chipsalliance/Cores-VeeR-EH1/(threads)

Thread 2 (2019-07-10):

Code cleanup: fix line endings

ChippendaleMupp, 2019-07-10:
Perforce is complaining about line endings in the 4 files below.  dos2unix seems to clean them up. (Command for recursive cleanup:  'find . -type f -print0 | xargs -0 dos2unix'

- design/dmi/dmi_wrapper.v
- design/dmi/dmi_jtag_to_core_sync.v
- testbench/hex/data.hex
- testbench/hex/program.hex

jrahmeh, 2019-07-12:
Fixed.

Closed 2019-07-12.

Thread 14 (2019-09-04):

Issues to enable DMA for SweRV

rajoogupta, 2019-09-04:
Hi,
I am trying to enable DMA for SweRV. I did following changes in **testbench/tb_top.sv**

   1.added following signal
    logic [31:0] dma_haddr;
    logic [2:0] dma_hburst;
    logic [3:0] dma_hprot;
    logic [2:0] dma_hsize;
    logic [1:0] dma_htrans;
    logic dma_hmastlock;
    logic dma_hwrite;
    wire dma_hresp_out;

   2. port mapping
    // DMA Slave
    //---------------------------------------------------------------
    .dma_haddr **('0) replaced with** ( dma_haddr ),
    .dma_hburst **('0) replaced with** ( dma_hburst ),
    .dma_hmastlock **('0) replaced with** ( dma_hmastlock),
    .dma_hprot **('0) replaced with** ( dma_hprot ),
    .dma_hsize **('0) replaced with** ( dma_hsize),
    .dma_htrans **('0) replaced with** ( dma_htrans),
    .dma_hwrite **('0) replaced with** ( dma_hwrite ),
    .dma_hwdata **('0) replaced with** ( dma_hwdata ),

        .dma_hrdata          ( dma_hrdata    ),
        .dma_hresp          **(dma_out)   **replaced with****   ( dma_hresp_out   ),
        .dma_hsel            ( 1'b1            ),
        .dma_hreadyin        ( dma_hready_out  ),
        .dma_hreadyout       ( dma_hready_out  ),

  3.  added instance
    ahb_sif **o_ahb_dma** (

    .HWDATA(dma_hwdata),
    .HCLK(core_clk),
    .HSEL(1'b1),
    .HPROT(dma_hprot),
    .HWRITE(dma_hwrite),
    .HTRANS(dma_htrans),
    .HSIZE(dma_hsize),
    .HREADY(dma_hready),
    .HRESETn(reset_l),
    .HADDR(dma_haddr),
    .HBURST(dma_hburst),

    .HREADYOUT(dma_hready),
    .HRESP(dma_hresp),
    .HRDATA(dma_hrdata)

    );

I have **DMA controller (master) to drive read or write requests into ICCM/DCCM**

after all , ran verilator and got hello world but **DMA is not enable** as ICCM and DCCM donot getting any data.

Here is GTKwave for reference

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

Please help me, to enable DMA for SweRV

Thanks & Regards
Rajoo

aprnath, 2019-09-06:
Hi Rajoo,

 Looking a your waveform, I notice a couple of things:

- Your dma_bus_clk_en is 0. This should be 1 to enable the DMA bus interface clocking. See the PRM for details on how the clock enables control clock ratios. A 0 effectively disables the clock.

- I do not see any DMA read/swrite initiated in the portion of the waveform shown. Your testbench bfm/DMA master must initiate read/write sequences on the bus. The core is a slave and will respond.

-Ajay

rajoogupta, 2019-09-06:
Hi Ajay,
             I set **dma_bus_clk_en** to 1 as you suggested (also referred  PRM) but DMA is not enable.
Here snapshot of DMA master signal.

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

Thanks & Regards
Rajoo

aprnath, 2019-09-06:
Please show me a snapshot of waveform where your testbench  AHB master is initiating a read or write on the dma* AHB bus (assuming you are using the AHB flavor of the interface and not AXI).

The DMA port is a slave port and an external agent has to initiate the activity.

rajoogupta, 2019-09-06:
Hi Ajay,
             Please find snapshot of AHB master initiating a read or write on the dma AHB bus.
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

Previously there is no code in testbench to initiating a read or write on the dma AHB bus.
so added following code in testbench as I mentioned in my issue post.

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

Thanks & Regards
Rajoo

rajoogupta, 2019-09-07:
Hi,
      I am trying to enable DMA for SweRV. Inside design , there is a DMA controller which work as master for DMA.
if anybody enable DMA , Please help me to enable it.

Thanks & Regards
Rajoo

aprnath, 2019-09-07:
Hi Rajoo,

The SweRV core has a DMA slave port, not a DMA master port. You need an external master to pull/push data from/to the core.

Ajay

milk0920, 2019-09-12:
Hi , if we want to use the iccm ，Can I simply edit the link file， And let the cpu core to automatically download the code from external rom/ram/flash, is that possible, if we do not have the dma master design, but we still want to run code in iccm

Closed 2020-02-11.

Thread 15 (2019-09-12):

Boot code from iccm

milk0920, 2019-09-12:
Hi , if we want to use the iccm ，Can I simply edit the link file， And let the cpu core to automatically download the code from external rom/ram/flash, is that possible, if we do not have the dma master design, but we still want to run code in iccm

agrobman, 2020-02-12:
provided TB doesn't support any usage of ICCM

agrobman, 2020-02-20:
checkout latest and *_iccm test ...

aprnath, 2020-04-13:
Closing this. Please see prior comment about using the *iccm tests. It enables one of

- a gasket that allows stores to ICCM by hooking up the LSU to the DMA port
- or a testbench preload of the ICCM

Thanks

Closed 2020-04-13.

Thread 23 (2019-11-07):

ifu interface access illegal address

Chuanjieliu, 2019-11-07:
Ifu interface will access illegal address while cpu is running，But does not affect the function.
For example，the 0x0-0x30 is illegal address
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
after analysis，we found that the BP predicted an incorrect address. Can I solve this problem by set the register?

Chuanjieliu, 2019-11-07:
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
spec

Closed 2019-11-07.

Thread 24 (2019-11-08):

Interrupt example

Jagannaths3, 2019-11-08:
Hi,
   I am trying to use the interrupt on the SweRV core. I am trying the following
1) Setup interrupt[1] with following features -
    standard priority order - 0x0 @ mpiccfg
   gateway configuration set to Edge-triggered, active high - 0x2 @ meigwctrl1
   set priority level for interrupt1 to 15 - 0x000F @ meipl1
   mask no interrupt - 0x0 @ meipt
   0x0 @ meicidpl
   0x0 @ meicurpl
   Enable the interrupt - 0x1 @ meie1
   machine interrupt enable - 0x800 @ mie (0x304)

2)  put the system to sleep by writing 0x1 to 0x7C6(mpmc)

3) Toggle the interrupt1 bit using testbench.

I see the signal mhwakeup( in dec.tlu) get asserted, but the mhwakeup_ready does not go high since the interrupt is not enabled in the mstatus register.

What is the correct sequence of setting up interrupts and handlers? Can you please provide an example of basic interrupt handler setup and usage? The Example interrupt flows (5.14.1) seems inadequate.

Thanks,
Jagannath

olofk, 2019-11-08:
Hi,

Perhaps you might be helped by the Zephyr interrupt driver for SweRV [here](https://github.com/olofk/zephyr/blob/swerv_pic/drivers/interrupt_controller/swerv_pic.c), currently [under review for inclusion](https://github.com/zephyrproject-rtos/zephyr/pull/19865) in Zephyr

Closed 2020-04-13.

Thread 26 (2019-11-20):

Issue in running the Design in vivado

rajat-agnisys, 2019-11-20:
Hello,

I am just trying to run swerv design on xilinx zed board using vivado and instead of running it in the debug mode using jtag and uart i want to interface this with zedboard io's.
Could you help me in this as i am unable to write firmware sequences for the swerv core in fpga or how to initialize the memory with those hardcode sequence.

Thanks

aprnath, 2020-04-13:
Hi Rajat, we could not understand exactly what is being asked/requested here. If this is still an issue blocking you please open a new issue and we can try to understand your use case.

Closed 2020-04-13.

Thread 28 (2019-12-02):

Software breakpoints with OpenOCD + GDB

cstewart-ust, 2019-12-02:
When connecting OpenOCD I get the following warning:

Info : datacount=2 progbufsize=0
Warn : We won't be able to execute fence instructions on this target. Memory may not always appear consistent. (progbufsize=0, impebreak=0)

With icache enabled is there any way of reliably setting a SW breakpoint? Build options via swerv.config? I imagine this would require a fence instruction to be issued to flush cache but there's no program buffer to do so...

The custom CSR (0x7C4) seems that it would work via 'expose_csr' on OCD but initial results show inconsistent behavior

aprnath, 2020-02-11:
Yes, you need to use the custom DMST (0x7c4) CSR to force a fence.i before returning from debug mode, if you have used the system bus to update cacheable memory.

Could you be more specific about the "inconsistent behavior" ? Whats your setup and flow? Please provide your use case and steps so we can try and understand if it is a usage issue or a design issue.

agrobman, 2020-04-04:
OpenOCD out of box doesn't support DMST register, you'll need write it manually with debugger command every time you setting SW Breakpoint, or patch openOCD, including the register write into SW Breakpoint setting/removing functions.

JanMatCodasip, 2020-09-22:
A note in case anyone else runs into the same issue -

With the present day SweRV 1.8+ and [riscv-openocd](https://github.com/riscv/riscv-openocd/), the **preferred solution** is to enable abstract memory access. That will properly populate the SW breakpoint even when ICache is present. Add the following line to your OpenOCD configuration file:

```
riscv set_mem_access abstract
```

For robustness, you may also have OpenOCD clear the ICache every time the processor is resumed from the debug mode. To do so, add this to your OpenOCD configuration:

```
# Expose custom SweRV CSR dmst (CSR 0x7c4 == 1988)
riscv expose_csrs 1988

proc swerv_eh1_execute_fence {} {
    # Execute fence + fence.i via "dmst" register
    reg csr1988 0x3
}

# Configure events hooks in OpenOCD to execute Fence + Fence.i when resuming
# the processor from the debug mode:

$_TARGETNAME configure -event resume-start {
    swerv_eh1_execute_fence
}

$_TARGETNAME configure -event step-start {
    swerv_eh1_execute_fence
}

```

Closed 2020-04-13.

Thread 31 (2019-12-28):

RV core With AHB bus will cause bug when send read operation

walkingjian, 2019-12-28:
In the latest test, RV core in my soc envirent will cause NMI err.

The detail is because the RV core send a 64bit width read transation of AHB bus, while I only wirte an "unsigned int read regitster" code in my c file.
And ,the register I want read is right the last register of one module, so this 64 bit read cause slverr back, and then the RV core get into MNI interrupt.

aprnath, 2020-02-10:
Hi,
Please use MRAC to set the region for your device to be non-idempotent. Non-idempotent (or side-effect) regions will support exact size for load stores, and is recommended for non-memory load stores, especially to devices.

Closed 2020-02-11.

Thread 32 (2019-12-30):

EH2 and EL2 are missing.

pieter3d, 2019-12-30:
Earlier this month Western Digital announced two new cores, EH2 and EL2, in addition to the current one here, EH1: https://www.westerndigital.com/risc-v

But I don't see them in this repository, linked on that page. Where could I find these two new cores?

aprnath, 2020-04-13:
EH2/EL2 are visible to ChipsAlliance members for now and will be globally visibly at some later date.

Closed 2020-04-13.

Thread 33 (2020-02-10):

RISCV-Compliance check - Some Fails

cr8601, 2020-02-10:
Hi,
I successfully run the RISC-V Compliance check (https://github.com/riscv/riscv-compliance) on the provided SweRV RTL and I was able to pass most of the tests except the following:

1. ree_rv32i.I-MISALIGN_JMP-01
2. ree_rv32i.I-MISALIGN_LDST-01
3. ree_rv32mi.breakpoint
4. ree_rv32Zifencei.I-FENCE.I-01
5. ree_rv32ui.fence_i

Unfortunately I couldn't find any information about RISC-V-Compliance check regarding SweRV.

- Regarding 1./2.
I read that this is not needed by RISC-V spec. And also it is implementation dependent. Whenever the RTL already contains mechanism to handle misalignments, this test probably fails...
What about SweRV implementation?

- Regarding 3
I didn't yet analyze in detail, but I don't expect this to be really relevant

- Regarding 4./5.
As stated in the PRM (1.1 Features):
> RV32IMCZifencei_Zicsr-compliant RISC-V core with branch predictor
I would expect this test to pass...

Has anyone ever run RISC-V compliance on SweRV and can comment on the above issues?

Thanks and best regards
cr

aprnath, 2020-02-10:
Misalign tests will fail because SweRV supports unaligned accesses to normal memory. IO (non-idempotent) ld/st will take misalignment exceptions, but you will need to mark the region as such using the MRAC CSR. SweRV also supports compressed (16 bit) instructions, and there is no way to turn off 16 bit support - so you cannot get alignment exceptions on branch/jump instructions either.

Regarding the fence instructions - it depends on your test setup and if it supports a unified instruction.data memory. The (currently*) provide simple TB does not support self-modifying code since the stores are not reflected in the instruction memory. To really test the fence.i instruction, you need your system to have share memory between the fetch and data buses.

* We will be updating the provided TB soon.

aprnath, 2020-02-10:
Regarding the breakpoint test, note that SweRV disables breakpoints when mstaus.mie is cleared.

cr8601, 2020-02-10:
Hi aprnath,
thank you very much for this information. This helps a lot in further debugging and understanding!

cr8601, 2020-02-13:
Hi aprnath,

- I was able to successfully run the "fence" instruction test by using shared memory for IFU&LSU. Thank for your hint.

- I did some analysis for the breakpoint test. By adding the following code to the beginning of the test I could successfully run it:
```
# from https://github.com/riscv/riscv-asm-manual/blob/master/riscv-asm.md
# set mstatus.MIE=1 (enable M mode interrupt)
li      t0, 8
csrrs   zero, mstatus, t0
```

After digging some more in the latest ISA spec, 3.1.6 Machine Status Registers, I am wondering whether mstatus.MIE should be '1' by default and this is an inconsistency to the spec? Can you comment on that?

Best regards
cr

cr8601, 2020-02-13:
Hi aprnath,
I think it's cleared in chapter 3.3:

> Upon reset, a hart’s privilege mode is set to M. The mstatus fields MIE and MPRV are reset to
> 0.

Correct? Then I am wondering about the compliance check and why it works for others...
I probably need to open an issue at their repo. Do you agree, or do you you have any other idea?

Best regards
cr

tmw-wdc, 2020-02-13:
Hi,

I think the answer to your question above is covered in Section 5.1, ‘Native M-Mode Triggers’ of the [RISC-V External Debug Support specification, Version 0.13.2](https://riscv.org/specifications/debug-specification/).  There are two implementation options to deal with breakpoints in M-mode only cores.  SweRV disables breakpoints when MSTATUS.MIE is cleared.  Presumably, the breakpoint test might pass on cores which implement the other option.

Thanks,
Thomas

cr8601, 2020-02-14:
Hi,
thanks for your support and quick feedback. I'll request to add the register settings within the compliance test.
Thanks
cr

tmw-wdc, 2020-02-14:
Thank you for reporting these test cases!  They will be documented in the next PRM release.

Thanks,
Thomas

Closed 2020-02-14.

Thread 35 (2020-02-18):

running with stack in RAM

monniaux, 2020-02-18:
I have tried running on the "verilated" simulated core a simple program making a function call but hit a snag.

The program is

```
#include "defines.h"

#define STDOUT 0xd0580000

.section .text
.global _start
_start:
    la   sp, _sp

    // Clear minstret
    csrw minstret, zero
    csrw minstreth, zero

    // Set up MTVEC - not expecting to use it though
    li x1, RV_ICCM_SADR
    csrw mtvec, x1

    // Enable Caches in MRAC
    li x1, 0x55555555
    csrw 0x7c0, x1

    call main

// Write 0xff to STDOUT for TB to termiate test.
_finish:
    li x3, STDOUT
    addi x5, x0, 0xff
    sb x5, 0(x3)
    beq x0, x0, _finish
.rept 100
    nop
.endr

	.align	1
	.globl	main
	.type	main, @function
main:
	addi	sp,sp,-256
	sw	ra,252(sp)
	sw	s0,248(sp)

.rept 7
	nop
.endr

	lw	ra,252(sp)
	lw	s0,248(sp)
	addi	sp,sp,256
	jr	ra
	.size	main, .-main
```

The link file is
```
OUTPUT_ARCH( "riscv" )
ENTRY(_start)

MEMORY
{
	RAM  (wxa!ri) : ORIGIN = 0x00000000, LENGTH = 64K
}

/*----------------------------------------------------------------------*/
/* Sections                                                             */
/*----------------------------------------------------------------------*/

SECTIONS
{
  __stack_size = DEFINED(__stack_size) ? __stack_size : 4K;

  .text.init	:
  {
	*(.text.init)
	. = ALIGN(8);
  } > RAM

  .text :
  {
    *(.text.unlikely .text.unlikely.*)
    *(.text.startup .text.startup.*)
    *(.text .text.*)
    *(.gnu.linkonce.t.*)
	. = ALIGN(8);
  } > RAM

  .rodata	:
  {
    *(.rdata)
    *(.rodata .rodata.*)
    *(.gnu.linkonce.r.*)
	. = ALIGN(8);
  } > RAM

  .data	:
  {
	*(.data .data.*)
    *(.gnu.linkonce.d.*)
	. = ALIGN(8);
  } > RAM
  .sdata	:
  {
	. = ALIGN(8);
    __global_pointer$ = . + 0x800;
    *(.sdata .sdata.*)
    *(.gnu.linkonce.s.*)
    . = ALIGN(8);
    *(.srodata .srodata.*)
	. = ALIGN(8);
  } > RAM

  .sbss : {
    *(.sbss .sbss.* .gnu.linkonce.sb.*)
    *(.scommon)
	. = ALIGN(8);
  } > RAM
  .bss :
  {
	*(.bss)
	. = ALIGN(8);
  } > RAM

  _end = .;

  .stack :
  {
	_heap_end = .;
	. = . + __stack_size;
	_sp = .;
  } > RAM
}
```

The trace seems to imply that value `0` is read from memory and restored to `ra` thus the function returns not to the normal return location but to program start. A neverending loop ensues and the program is killed because the number of simulated instructions exceeds a threshold.

If `rept 7` is replaced by `rept 6` things run perfectly : function `main` is called and then the program terminates.

My interpretation is that in one case the read to `ra` is not actually performed from RAM but from a write buffer, while in the other case a read from RAM is performed and the simulated RAM answers `0`.

I'm at a loss—how am I supposed to run programs that write to RAM?

aprnath, 2020-02-18:
Hi,
Are you using the provided simple testbench for this test? If so, then yes there is a known issue that this demo testbench does not support proper store/load persistence.

We are going to be releasing a more capable testbench slave shortly. Stay tuned.

monniaux, 2020-02-19:
Indeed. I just use my own assembly code instead of `hello_world2.s`. Since I could not make head or tail of what was happening, I also fiddled with the link file.

Do I understand it correctly that this demo does not support writing to RAM and reading back from it?

aprnath, 2020-02-19:
> Do I understand it correctly that this demo does not support writing to RAM and reading back from it?

Yes. Sorry. A better demo testbench will be pushed soon.

agrobman, 2020-02-19:
meanwhile you can try to update testbench/ahb_sif.sv

always @ (posedge HCLK or negedge HRESETn) begin
  if (Write **&& Last_HADDR == 32'h0**) begin

removing '&& Last_HADDR ==32'h0'

aprnath, 2020-02-20:
Please try out the latest release and reopen if needed.

Closed 2020-02-20.

Thread 36 (2020-02-19):

DCCM load/store conflict situation

TAD-dev, 2020-02-19:
DCCM data outputs are forced to 0 values at he [testbench](https://github.com/chipsalliance/Cores-SweRV/blob/1651bdf99a9c7dafab543e8697c48bf300e56cfa/testbench/tb_top.sv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).
Does this mean DCCM is not supposed to be used?

And if DCCM is in the working state, I've got a question.
Does LSU support resolving of conflicts when store and load operations are performed with the same target address? Or such situations should be resolved on the software side?

aprnath, 2020-02-19:
Hi,
The DCCM is fully functional. The simple demo TB we put out does not support it, obviously.
We will be releasing a new testbench shortly which will run with the DCCM. Please stay tuned.

Resolution of resource conflicts are handled by the hardware.

aprnath, 2020-02-20:
Please try out the latest release, and reopen if needed.

TAD-dev, 2020-02-20:
I've pulled newest version of the project but it doesn't help.

I'll describe the issue I've found.
When there are sequential storing and loading with the same target address are done, it's not guaranteed they'll be ordered in a correct way.

In case which I've explored there is a sequence of store operation and then store and load to the same address are done. As I've understood load and store units work in parallel and are not synchronous. Because of payload store unit is busy when new accesses come, so it postpones new memory write operations. And when load access happens it is executed immediately, as load unit is doing nothing at that time.
It causes situation in which store happens later then load to the same address even if in assembly code load should happens later.

This error is reproducible, so I've created small test-case to illustrate it. Here is assembler file [(dccm_test.s.txt)](https://github.com/chipsalliance/Cores-SweRV/files/4230485/dccm_test.s.txt) and its disassembled version [(dccm_test.dS.txt)](https://github.com/chipsalliance/Cores-SweRV/files/4230484/dccm_test.dS.txt).

Last two instructions uses the same addresses (sp+12 or 0x7_FFCC). As you can see on waveforms store to 0x7_FFCC happens a few cycles later then load from it, but in assembly program and disassembled code order is reversed.
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

So, it causes reading of X's from this address.

aprnath, 2020-02-20:
Reopening this issue.

The way the DCCM works, for alignment and ECC handling, is that it always does a read-modify-write, and even for writes the ECC has to be calculated before updating the memory. If the memories are not initialized at reset, this could result in X propagation in simulation.

agrobman, 2020-02-20:
I didn't understand how do you run your test. Please, provide run commands/test sources/linker file and exec.log from simulation.

FYI:

TB sets up reset to address 0, your code starts from 0x80000000,
Your stack is set to 0x28_0000, while DCCM base address is 0xf0040000.

You need to be aware that external memories are 64KB only and ignore upper 16 bits of the address. Also the $readmemh tasks, loading the RAMs will not load bytes, which address is higher than 0xffff .

Please, take a look on tests code and linker files of the provided  examples to get hints how to deal with DCCM,  ICCM code and data.  These are a bit tricky.
( all this complexity is because our verilator version doesn't support SV dynamic data types, the stuff could be much simpler if we could use associative arrays to model CPU memories)

The TB setup has changed since 1.4 .

 exec.log helps to understand what processor did during a test simulation. ( although it doesn't show registers updates for external loads)

TAD-dev, 2020-02-20:
I'm using custom testbench and configurations, so addresses differ from default ones.
In my test case initialization part of program (init section) located in the ROM (with offset 0x80000000) that's why 0x80000000 is start address. And main program (text section) located in the ICCM with offset 0x00100000.
In this test case DCCM has offset 0x00200000 and size 512 KB. Stack is located at the end of the memory, so default value of pointer is 0x28_0000.

For complication and linking of the program I used this commands:
```
${GCC_PREFIX}-as -march=rv32imc dccm_test.s -o dccm_test.o
${GCC_PREFIX}-as -march=rv32imc ctrl0.s -o ctrl0.o
${GCC_PREFIX}-ld -m elf32lriscv --discard-none -Tdccm_test.ld -o dccm_test.elf dccm_test.o ctrl0.o
```
Here are links for [initial](https://github.com/chipsalliance/Cores-SweRV/files/4233425/ctrl0.s.txt) and [main](https://github.com/chipsalliance/Cores-SweRV/files/4233428/dccm_test.s.txt) parts of the program.
Here is [linkers sctipt](https://github.com/chipsalliance/Cores-SweRV/files/4233427/dccm_test.ld.txt).
Here are resulting [disassembled code](https://github.com/chipsalliance/Cores-SweRV/files/4233426/dccm_test.dS.txt) and [exec.log](https://github.com/chipsalliance/Cores-SweRV/files/4233444/exec.log.txt).

In general both ICCM and DCCM work fine except of this "store-load" case.
As the example I've changed test program which I've shared earlier to make it work fine. I've just put 20 NOP operation between store and load and it resolved this coherency problem. [Here](https://github.com/chipsalliance/Cores-SweRV/files/4233330/dccm_test_no_conflict.s.txt) is the link to this program and [here](https://github.com/chipsalliance/Cores-SweRV/files/4233329/dccm_test_no_conflict.drtelf.txt) is its disassembled version.
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
As you can see on waveforms load happens later then store now, and data are read correctly.

So, it seems there is a problem in coherency mechanism of the processor.

agrobman, 2020-02-21:
OK, this is effect of the uninitialized memory with ECC protection and Store to Load bypassing in the Store buffer. You need first write the DCCM locations, you are going to use, then you can read them in any order. The problem happens if you write uninitialized location and read immediately from it.

Theoretically, memory with ECC protection should be first "initialized" by word aligned word size stores and only then it can be freely accessed. The crt0 can execute the whole application data region zeroing and only then C coded main can use it as data, stack or heap ...
Also, I need to remind that any uninitialized variable in C is assumed to have zero value.
There is another reason for memory initialization - misaligned of smaller than word variables access.
the CPU always make read/modify/write operations for byte and half word stores. These will fail in simulation if the memory was not initialized or cause random ECC error/exceptions in real life.

TAD-dev, 2020-02-21:
Initialization of stack area with zeros helped to avoid coherence problem.
Thanks!

But what will happen in real life situation in this case?
DCCM has unknown values after reset, so ECC will be inevitably incorrect at the very first read. And as there is always read before write, first stack writing will cause ECC errors.

BTW. Is it possible to remove ECC checking from ICCM and DCCM with some option as it is done at I-Cache?

aprnath, 2020-02-21:
The PRM has this verbiage in section 3.4:
 _**Note:** Memories with parity or ECC protection must be initialized with correct parity or ECC. Otherwise, a read access to an uninitialized memory may report an error. The method of initialization depends on the organization and capabilities of the memory. Initialization might be performed by a memory self-test or depend on firmware to overwrite the entire memory range (e.g., via DMA accesses)._

We will update it to be explicit about the initialization mechanisms, adding the following:

_**Note:** If the DCCM is uninitialized, a load following a store to the same address may get incorrect data.  If firmware initializes the DCCM, **aligned word-sized stores** should be used (because they don’t check ECC), followed by a fence, before any load instructions to DCCM addresses are executed._

agrobman, 2020-02-21:
mfdc[8] disables ECC checking/correction for all swerv memories.

agrobman, 2020-02-21:
but you still may get simulation problems if your application will read uninitialized memory locations

TAD-dev, 2020-02-24:
@aprnath
Thanks for clarification!

@agrobman
Yes, I know about this bit. I'm interesting can DCCM ECC checking mechanism be removed entirely from the design by some HDL parameter?

And as for the situation with store followed by load instruction in my testcase. If Store to Load bypassing in the Store buffer happens why then LSU reads DCCM at all? There is aligned word-sized store, so generaly we don't care about data in the memory as it'll be fully overwritten.

agrobman, 2020-03-03:
We don't have plans to create a design parameter to remove ECC protection from the memories.
You are welcome to create your local version without ECC logic.
Regarding DCCM store buffer behavior - the ECC logic is executed in parallel to speed up the CPU operation regardless of access size.

Again the CCMs were designed in assumption that the memories had to be initialized before use.

TAD-dev, 2020-03-04:
Ok, it's clear.
Thanks!

Closed 2020-03-04.

Thread 37 (2020-02-20):

Question: how to disable (bypass) data checks in cache?

vit82, 2020-02-20:
I see that CPU often checks for instruction data in icache even when it's disabled by SWERV configuration (icache_enable=0). This affects overall CPU memory access performance.
Please, suggest if it's possible to bypass icache.

aprnath, 2020-02-20:
The core is designed to have ICACHE , ICCM or both. It is not optimized for the case that Icache and ICCM are **both** not enabled. It will function but not efficiently. In other words , cycles are not taken out when Icache is not enabled.

agrobman, 2020-02-20:
check for RV_ICACHE_ENABLE define in common_defines.vh if this defined the IC logic will present in design. if you want CPU without IC, you need to use -unset icache_enable switch with swerv.config
 (-set icache_enable=0, has no effect) ...

Closed 2020-02-26.

Thread 38 (2020-02-20):

DCCM coherncy issue

TAD-dev, 2020-02-20:
Unfortunately I can't reopen issue #36, so I've created this one as to continue the thread.

agrobman, 2020-02-20:
please, provide you *.hex files and CPU configuration setup to rerun the test

aprnath, 2020-02-20:
I have reopened #36

Closed 2020-02-20.

Thread 46 (2020-03-03):

SWERV CPU doesn't work properly if memory interface HREADY signal is high by default

vit82, 2020-03-03:
SWERV CPU doesn't work properly if memory interface HREADY signal (highlighted on the waveform) is high by default:
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

If HREADY is low as shown below, the CPU work fine.
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

vit82, 2020-03-03:
In this case HREADY comes from the memory where proram executable code locates (ROM).
In my opinion according to AMBA standard HREADY is permitted to be high by default.
Please, comment.

aprnath, 2020-03-04:
Hi,
Please clarify a few things in your report for us:

- What are the two waveforms provided? Is the 2nd one the "working" case, and the 1st one the failing case?
- Are both cases using the same slave IP?
- We would like to understand how the master and slave are connected. Is there a bridge or interconnect logic between them? A diagram or tb_top verilg would be useful.
- In the failing case we don't see hrdata @rvtop being drive the cycle after transaction starts and hready is still high. If hready is high, the DUT expects data that cycle.

Thanks

agrobman, 2020-03-04:
If the 1st diagram is your failing case, seems that your slave drives zero data for the CPU request of 0x80000000 -( the hready is asserted for next clock after HTRANS=2) if your slave needs more time it should drop hready right after transaction start .

vit82, 2020-04-03:
Thank you. Indeed between SWERV CPU and ROM, there's AHB switch fabric which doesn't work fine with AHB-lite provided by SWERV CPU.
That was the main root cause of the problems.

Closed 2020-04-03.

Thread 47 (2020-03-05):

D-cache to complement I-cache

cahz, 2020-03-05:
To get the full performance of SweRV, I am aware that you should use the tightly coupled memories (ICCM and DCCM).
When using larger external memory, the common way is to attach them via AXI. Then you can use the I-cache for faster access to instructions. However, this option is not available for data accesses. One workaround is to use a DMA engine to transfer data into the DCCM.
A more convenient solution would be a _D-cache_, similar to the existing I-cache. Are there any plans to include such a feature in upcoming releases of SweRV?

agrobman, 2020-03-08:
So far there are no plans to add DCache to Swerv EH1. This is pretty substantial design effort and our main customer does not need DCache.

Closed 2020-04-13.

Thread 48 (2020-03-18):

SweRV on genesys2

z897899878, 2020-03-18:
I tried to run the swerv core with Configure in "SweRV_CoreMark_Benchmarking.pdf" on genesys2 fpga board, and it could successfully run the hello example through openocd;
But when I tried to run the dhrystone with "number of runs" = 1000000 through openocd, it took 334 seconds  and the DMIPS was very low.

So, could somebody tell me where the question is?
The change all I made was:

1. change the constraint file
2. update the IP for genesys2 FPGA

The dryhstone code was from https://github.com/sifive/benchmark-dhrystone
I copied the makefile from hello example for dryhstone
Deleting -nostdlib and change all hello.c to dhry_1.c  dhry_2.c
Thanks!

jrahmeh, 2020-03-20:
Make sure the compiler is invoked with the -O2 flags.  Default compilation produces non-optimized code.  To get decent performance you have to use -O2 as allowed/required by the benchmark.

z897899878, 2020-03-21:
I had added the -O2 flags, but the time spent had increased to 358 seconds.

agrobman, 2020-03-21:
what frequency is your fpga design running? Where do you place data/stack - make sure data & stack are located inside DCCM, you need to scale DMIPS numbers with frequency.

Check that your code is placed to a region marked as cacheable in MRAC register and your design have IC enabled ...

agrobman, 2020-03-21:
You probably need review/update your crt0 code and write 0x55555555 to MRAC CSR to enable caching:
li t0,0x55555555
csrw mrac, t0

prior calling main

z897899878, 2020-03-24:
Frequency is 40Mhz
My configuration is
```
./swerv.config -set reset_vec=0xf0090000 -set=iccm_enable=1
-unset=icache_enable -iccm_region=0xf -iccm_offset=0x90000
-iccm_size=64 -dccm_region=0xf -dccm_offset=0x80000
-dccm_size=64 -btb_size=512 -bht_size=2048
```
so I changed link.ld to be like
```
MEMORY
{
  iccm  (wxa!ri) : ORIGIN = 0x00090000, LENGTH = 64k
  dccm  (wxa!ri) : ORIGIN = 0x00080000, LENGTH = 64k
}

SECTIONS
{
  __stack_size = DEFINED(__stack_size) ? __stack_size : 8K;

  .text.init	:
  {
	*(.text.init)
	. = ALIGN(8);
  } > iccm

  .text :
  {
    *(.text.unlikely .text.unlikely.*)
    *(.text.startup .text.startup.*)
    *(.text .text.*)
    *(.gnu.linkonce.t.*)
	. = ALIGN(8);
  } > iccm

  .rodata	:
  {
    *(.rdata)
    *(.rodata .rodata.*)
    *(.gnu.linkonce.r.*)
	. = ALIGN(8);
  } > dccm

  .data	:
  {
	*(.data .data.*)
    *(.gnu.linkonce.d.*)
	. = ALIGN(8);
  } > dccm
the left section .sdata, .sbss, .bss, .stack are all > dccm
```
But the GDB cannot read correctly and displayed
```
0x00000000 in ?? ()
```
which is not like what it was
```
_start () at /home/vdsl/swerv_eh1_fpga/software/bsp/startup.S:26
```

agrobman, 2020-03-24:
How do you load data/code to DCCM/ICCM before run?
Debugger with openOCD may not know how to access the CCMs

z897899878, 2020-03-27:
How to load data/code to DCCM/ICCM is specified in link.ld or startup.S files?
My link.ld file has changed to what I previously said(other section were remain same),and startup.S is the original file that github provided.

jrahmeh, 2020-03-27:
If you put the iccm and dccm in region 0xf, then your memory map should be like this:

MEMORY
{
  iccm  (wxa!ri) : ORIGIN = 0xf0090000, LENGTH = 64k
  dccm  (wxa!ri) : ORIGIN = 0xf0080000, LENGTH = 64k
}

z897899878, 2020-03-27:
I have tried that version of link.ld but still not work.
The other issue says that it must use dma to load/store from iccm, is it correct?
At least in my case.

agrobman, 2020-03-27:
>I have tried that version of link.ld but still not work.
>The other issue says that it must use dma to load/store from iccm, is it correct?
>At least in my case.

This is correct, CPU has no internal data path from ICCM to LSU (load/store unit)

z897899878, 2020-03-27:
I think solution to my problem might be adding the DMA (cause LSU cannot connect CCMs)
Below are new questions:
1. Why the program only can work when "RAM(wxa!ri) : ORIGIN = 0x00000000, LENGTH = 64k"?
My reset_vec=0xf0090000 is not pointing to 0x0.
2. What memory the data reside in? The manual says that it only have local memory ICCM/DCCM in this core but there has no data path between  ICCM/DCCM and LSU so it should't work (but it does)

agrobman, 2020-03-27:
What ( memories) do you have connected to the CPU buses ?  How do you download your test to the HW?
Most likely you have an external  memory slave near address 0.

If you have no DMA in you system, there are two ways to use DCCM:

1)      Copy initial values of data variables from external memory by the CPU to DCCM in startup code;

2)      Use debugger to preload DCCM   ( debugger needs to support abstract memory commands)
To use ICCM without DMA there are also two ways:

1)       Your system should have data path in the interconnect from LSU to DMA CPU port, then you can use CPU code to copy from external memory to ICCM;

2)      Use debugger to preload ICCM ( but it should use abstract memory commands to be able to access ICCM)

However, performance numbers for Dhrystone differ not significantly if the code is cacheable or resides in ICCM.

I think solution to my problem might be adding the DMA (cause LSU cannot connect CCMs)
Below are new questions:

  1.  Why the program only can work when "RAM(wxa!ri) : ORIGIN = 0x00000000, LENGTH = 64k"?
My reset_vec=0xf0090000 is not pointing to 0x0.
  2.  What memory the data reside in? The manual says that it only have local memory ICCM/DCCM in this core but there has no data path between ICCM/DCCM and LSU so it should't work (but it does)

z897899878, 2020-04-07:
I finally finished loading data to dccm by startup and the DMIPS became 1.9
But the uart became like this
```
Dhrystone Benc
Execution endsustruhDrsoe:C
C__lb      Balsue ntebnhak
                sol e  B
DISMz                  17712 bv    7
```
And if I didn't move rodata to dccm it became a little better
```
Dhrystone Benchmark, Version 2.1 (Language: C)
Execution endsts, 1000 runs through Dhrystone)
DMIPS/Mhz:                                   56792Gme as above
```
And if I removed all "\n", it can display all message but my Number_Of_Runs became 1000, and it should be 1000000(all number become upper 4 digits only)
```
 Dhrystone Benchmark, Version 2.1 (Language: C)  Program compiled without 'register' attribute  Execution starts, 1 Dhrystone Benchmark, Version 2.1 (Language: C)  Program compiled without 'register' attribute  Execution starts, 1000 runs through Dhrystone Execution ends  Final values of the variables used in the benchmark:  Int_Glob:            5         should be:   5 Bool_Glob:           1         should be:   1 Ch_1_Glob:           A         should be:   A Ch_2_Glob:           B         should be:   B Arr_1_Glob[8]:       7         should be:   7 Arr_2_Glob[8][7]:    1000         should be:   Number_Of_Runs + 10 Ptr_Glob->   Ptr_Comp:          -6859         should be:   (implementation-dependent)   Discr:             0         should be:   0   Enum_Comp:         2         should be:   2   Int_Comp:          1         should be:   1   Str_Comp:          DRSOEPORM OESRN         should be:   DHRYSTONE PROGRAM, SOME STRING Next_Ptr_Glob->   Ptr_Comp:          -6859         should be:   (implementation-dependent), same as above   Discr:             0         should be:   0   Enum_Comp:         1         should be:   1   Int_Comp:          1         should be:   1   Str_Comp:          DRSOEPORM OESRN         should be:   DHRYSTONE PROGRAM, SOME STRING Int_1_Loc:           5         should be:   5 Int_2_Loc:           1         should be:   1 Int_3_Loc:           7         should be:   7 Enum_Loc:            1         should be:   1 Str_1_Loc:           DRSOEPORM 'TSRN         should be:   DHRYSTONE PROGRAM, 1'ST STRING Str_2_Loc:           DRSOEPORM 'DSRN         should be:   DHRYSTONE PROGRAM, 2'ND STRING  It tooks 2 seconds. CLOCKS_PER_SEC 1000 Number_Of_Runs 1000 User_Time 2908 Microseconds for one run through Dhrystone: -0348  Dhrystones per Second:                      452  VAX MIPS:                                   2  DMIPS/Mhz:                                   56792
```
So, what leads to be like this? I don't have a clue to solve this.

Below are what I added to the file
link.ld:
```
//ram: dccm
  .lalign         :
  {
    . = ALIGN(4);
    PROVIDE( _data_lma = . );
  } >flash AT>flash

  .dalign         :
  {
    . = ALIGN(4);
    PROVIDE( _data = . );
  } >ram AT>flash

  .data          :
  {
    *(.rdata)
    *(.rodata .rodata.*)
    *(.gnu.linkonce.r.*)
    *(.data .data.*)
    *(.gnu.linkonce.d.*)
    . = ALIGN(8);
    PROVIDE( __global_pointer$ = . + 0x800 );
    *(.sdata .sdata.*)
    *(.gnu.linkonce.s.*)
    . = ALIGN(8);
    *(.srodata .srodata.*)
    . = ALIGN(8);
  } >ram AT>flash

  . = ALIGN(4);
  PROVIDE( _edata = . );
  PROVIDE( edata = . );
```
startup.S:
```
	//add below text before call main
	la a0, _data_lma
	la a1, _data
	la a2, _edata
	bgeu a1, a2, 2f
1:
	lw t0, (a0)
	sw t0, (a1)
	addi a0, a0, 4
	addi a1, a1, 4
	bltu a1, a2, 1b
2:
```

z897899878, 2020-04-07:
If  rodata and stack located in flash, the uart is fine but DMIPS is poor
```
  .rodata :
  {
    *(.rdata)
    *(.rodata .rodata.*)
    *(.gnu.linkonce.r.*)
  . = ALIGN(8);
  } >flash AT>flash

...

.stack ORIGIN(flash) + LENGTH(flash) - __stack_size :
  {
    PROVIDE( _heap_end = . );
    . = __stack_size;
    PROVIDE( _sp = . );
  } >flash AT>flash
```
If rodata in flash, stack in dccm, DMIPS is much better but uart is down
If both of them are in dccm, uart will display nothing

agrobman, 2020-04-07:
How can you place stack to flash? Flash is read only memory, I believe.
I can suggest to review cmark test setups in provided TB.

z897899878, 2020-04-07:
Flash is the memory origin at 0x0 which is the location of the block memory(specified in the address editor of axi bd).
I saw the axi have writing ports to block ram so it can write to the flash right?
I will check the cmark test setups later thanks.

Closed 2020-05-21.

Thread 50 (2020-04-03):

external interrupt handler return problem

vit82, 2020-04-03:
When writing External interrupt handler in assembly language, I follow advice from the datasheet:
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

However the CPU does not return on MRET isntruction to the main code. It continues execution of the instructions below MRET. One workaround is to place about 20 NOP instructions before MRET. In that case the CPU executes MRET as expected - it jumps to the address stored in MEPC.

Please, advice whether I miss something.

agrobman, 2020-04-04:
How do you initialize base field in meihap? how do you set up the interrupt vector table? what value do you get in t1  before jr t1? does it match with your interrupt handler start address?
can you single step your handler? can you get trace info from the CPU ( with logic analyzer)?
Can you simulate your code on RTL or ISS and get program trace ?

vit82, 2020-04-06:
At the moment I simulate RTL only. Please, have a look at the waveform with the requested signals.Also attached are program code and its listing file.
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
[issue50_listing.txt](https://github.com/chipsalliance/Cores-SweRV/files/4438446/issue50_listing.txt)
[issue50_program.txt](https://github.com/chipsalliance/Cores-SweRV/files/4438447/issue50_program.txt)

Register t3(x28) is used in the program insted t1. Before executing jr t3, t3 gets value 0x100016 - this is address of the desired interrupt handler (UART). So this looks correct.

MEIHAP gets value 2, this corresponds to uart_irq (level sensitive) connected to extintsrc_int[2]. The interrupt handler pointer (uart_handler) is stored in DCCM (offset 0x200000).

vit82, 2020-04-06:
At the waveform PC_experssion jumps to 0x100016(uart_handler) after 0x100074. Next, CPU clears interrupt source UART_IRQ, but it takes quite many cycles. If I don't insert NOPs, MRET occurs early while UART_IRQ is still high. This is probably why MRET isn't executed.

agrobman, 2020-04-06:
You can use tracer code from tb_top.sv to produce CPU trace to debug your simulations.

agrobman, 2020-04-06:
you probably need to poll UART  interrupt pending register and CPU MIP until no pending interrupts detected before exit the interrupt handler ..

aprnath, 2020-04-13:
> At the waveform PC_experssion jumps to 0x100016(uart_handler) after 0x100074. Next, CPU clears interrupt source UART_IRQ, but it takes quite many cycles. If I don't insert NOPs, MRET occurs early while UART_IRQ is still high. This is probably why MRET isn't executed.

You must clear the IRQ source and validate that the IRQ has been cleared before executing MRET. Else the core will come right back into the handler if the input external interrupt pin is still high when the MRET executes.

Please open a new issue if you still have questions.

Closed 2020-04-13.

Thread 54 (2020-05-23):

Problem with interrupts and SweRVolf

albertodbg, 2020-05-23:
I am trying to make interrupts work in the SweRVolf SoC. The concrete objective is to make switches work by using vectorized interrupts. I am following the Swerv documentation, trying to replicate the 7 steps mentioned in section 5.5.1 with the help of the code provided in section 5.14.1. Furthermore, I have included some code of my own to integrate the support for vectorized interrupts. Nevertheless, I am having problems with the code and also I have some doubts with the guide.

1) When trying to configure interrupts, it is necessary to access the CSR address space, concretely the one shown in Table 5-13. They are located in contiguous addresses, but according to documentation, these registers are 32-bits wide. It is true that there are many reserved sections, but if I am not wrong, there exists the possibility of overlapping. I am concerned about this, because the base address loaded in MEIVT for initializing the vector table is overwritten when initializing the thresholds through MEICIDPL. Here is an example:

MEIVT 0xBC8 ==> Write on bits 10..31, 9..0 reserved
MEIPT 0xBC9 ==> Write on bits 3..0, 31..4 reserved
MEICPCT 0xBCA ==> 31..0 reserved
MEICIDPL 0xBCB ==> Write on bits 3..0, 31..4 reserved
MEICURPL 0xBCC ==> Write on bits 3..0, 31..4 reserved

Memory in little endian (initialized to all 1s)

0xBC8 | 0xBC9 | 0xBCA | 0xBCB | 0xBCC
  FF  FF  FF  FF  FF

Sequence of all 0s
Write MEIVT

0xBC8 | 0xBC9 | 0xBCA | 0xBCB | 0xBCC
  FF  03  00  00  FF

Write MEIPT (0x1)

0xBC8 | 0xBC9 | 0xBCA | 0xBCB | 0xBCC
  FF  01  00  00  FF

Write MEICIDPL (0x2)

0xBC8 | 0xBC9 | 0xBCA | 0xBCB | 0xBCC
  FF  01  00  **02** FF (here overlapping is produced)

Write MEICURPL (0x3)

0xBC8 | 0xBC9 | 0xBCA | 0xBCB | 0xBCC
  FF  01  00  02  03

2) The mret instruction is not working. After executing the first routine in the code (init_vector_table_rt), the pc comes back and this routine is executed again and again. When substituting mret by just ret, the code finishes, but interrupts are not working.

3) Another issue is the id of the gateway. According to the PLIC documentation, all harts in RISC-V are connected through gateways. I have supposed this id is 1, but probably this is wrong.

I attach the code as well. If you could provide some answers it would be of great help.

[LedsSwitches.dis.txt](https://github.com/chipsalliance/Cores-SweRV/files/4671624/LedsSwitches.dis.txt)
[LedsSwitches.S.txt](https://github.com/chipsalliance/Cores-SweRV/files/4671625/LedsSwitches.S.txt)

aprnath, 2020-05-26:
Hi Albertodbg,
Please note that there are two sets of CSRs related to interrupts. One set is **internal CSR space** that uses _csrr*_ instructions and are XLEN (32) bits wide, and another **memory-mapped** set for the gateway that uses load/store instructions. I believe you may be conflating the two in your programming?
The internal CSRs that are programmed via the _csrr*_ instructions (at CSR address 0xBC*) are not memory mapped, and are 32 bits wide.

Please change your code such that the macros use _csrr*_ for the internal CSR space registers, and the gateway memory mapped CSRs uses RV_PIC_BASE_ADDR+offset addresses

aprnath, 2020-05-26:
Regarding your second issue - if the gateway is configured as level-sensitive (default) and the interrupt input pin stays asserted on MRET, SweRV will take the interrupt again. Your interrupt handler must execute code to disable/clear/negate the interrupt pin (possibly by writing to the SOC agent that is generating the interrupt), **prior to the MRET**, and must validate this by confirming via a read of the interrupt pending registers of the gateway (MEIPx), prior to the MRET. The MRET will re-enable interrupts in MSTATUS, and level sensitive interrupts pins that continue to stay asserted following MRET will trigger interrupts processing again.

albertodbg, 2020-05-27:
Thanks for your comments. I think that the first part is right now. The program runs, but the interrupt due to the switches is never pending, I am always in the "next" loop. Apparently the MEIE bit is active in the MIE register and things seems to be set up. I have tried to clear the interrupt in the handler, but as it is never run, I do not know whether is working (the same for mret).
I have two questions now:
1) Is it possible to see what gateway is active? Maybe using id=1 was not right.
2) I am mapping the vector table to DCCM (I have also tried ICCM). Could this be causing problems? As the base address is shifted 10 positions when mapped to MEIVT, it is only possible to employ region 0x0 for mapping the vector table, right?
[LedsSwitches.S.txt](https://github.com/chipsalliance/Cores-SweRV/files/4689929/LedsSwitches.S.txt)

aprnath, 2020-05-27:
Alberto, can you confirm that MSTATUS.mie is set (==1) ?
Yes, MEIVT should be in data memory (anywhere in external data memory or DCCM). The MEIHAP register will contain a fully formed address that is made up of the MEIVT base, and the interrupt claim id. This address should contain the interrupt handler pointer (which should be in instruction memory or ICCM). If you are using external memory, you are not limited to any internally mapped region to hold the vector tables and the corresponding handlers.

You can read the meip registers to see which interrupts are pending.

olofk, 2020-05-28:
Hi @albertodbg . It would help a lot if you could show us the modifications to the SweRVolf RTL that you have made. I'm flying blind here, but suspect there are several errors involved.

1. I find it unlikely that gateway ID should be 1, since that is normally used for the UART Interrupts and you seem to get your interrupts from switches, which is not available in the upstream SweRVolf SoC.
2. I don't see that the interrupt source is cleared anywhere. Since you say that this is a level-triggered interrupt, there must be some way of resetting the source. Not sure if this is what you have done, but connecting the switches directly to the interrupt line will not work since it will continuously trigger a new interrupt as soon as the previous one is handled.
3. ICCM and DCCM are not connected in SweRVolf (yet), so you can't put the interrupt vectors there

albertodbg, 2020-05-28:
> Alberto, can you confirm that MSTATUS.mie is set (==1) ?
Yes it is. The content of MSTATUS is 0x1808, but I had to force the mei bit after enabling the external interrupts.
> Yes, MEIVT should be in data memory (anywhere in external data memory or DCCM). The MEIHAP register will contain a fully formed address that is made up of the MEIVT base, and the interrupt claim id. This address should contain the interrupt handler pointer (which should be in instruction memory or ICCM). If you are using external memory, you are not limited to any internally mapped region to hold the vector tables and the corresponding handlers.
>
I think that the "base" term misguided me. So the MEIHAP register just contains the address by concatenating the base address with the claimid and "00".
> You can read the meip registers to see which interrupts are pending.
I have tried looking at address 0x10001000 but all 256 bytes are always 0.

albertodbg, 2020-05-28:
> Hi @albertodbg . It would help a lot if you could show us the modifications to the SweRVolf RTL that you have made. I'm flying blind here, but suspect there are several errors involved.

I did not modify the SoC. I am using EH1_1.5 on a Nexys A7 board. Using polling, I was able to read the least significant 8 switches and update the corresponding leds.
>
>     1. I find it unlikely that gateway ID should be 1, since that is normally used for the UART Interrupts and you seem to get your interrupts from switches, which is not available in the upstream SweRVolf SoC.
I have parameterized the id in the new version of the code, I have tested several id's but still not working. In this regard, when grepping the Verilog I found that the maximum number of interrupts is 8. Aslo, I found this line
../src/swervolf_0.6/rtl/swervolf_core.v:      .extintsrc_req ({6'd0, spi0_irq, uart_irq}),
Every bit of this signal is asserted when an interrupt is triggered with the proper priority, but apparently just spi and uart are mapped?? How could I handle gpio if this is true?
[LedsSwitches.S.txt](https://github.com/chipsalliance/Cores-SweRV/files/4697483/LedsSwitches.S.txt)

>
>     2. I don't see that the interrupt source is cleared anywhere. Since you say that this is a level-triggered interrupt, there must be some way of resetting the source. Not sure if this is what you have done, but connecting the switches directly to the interrupt line will not work since it will continuously trigger a new interrupt as soon as the previous one is handled.
In the handler I introduced these lines at the end
//Clear interrupt pending register
li t0, (RV_PIC_BASE_ADDR + RV_PIC_MEIGWCLR_OFFSET)
sw x0, 0(t0)
but the handler is never executed.
>
>     3. ICCM and DCCM are not connected in SweRVolf (yet), so you can't put the interrupt vectors there
Ok. I tried 0xC0000000 for instance.

olofk, 2020-05-28:
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

You can't. There is no interrupt connected to the GPIO. The only interrupts in SweRVolf 0.6 are from the UART, connected to gateway 1 and the SPI controller, connected to gateway 2. There is also the timer interrupt, but that goes directly to the core, not through the PIC.

One solution, if you want to set LEDs based on input switches could be to trigger a timer interrupt, say every 10 ms, and check the status of switches there

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

There is nothing at 0xC0000000, so you won't be able to write or read anything there. You can find the full memory map [here](https://github.com/chipsalliance/Cores-SweRVolf#memory-map). In addition to that, the PIC is mapped to 0xf00c0000

albertodbg, 2020-05-29:
Thanks!

Closed 2020-07-08.

Thread 58 (2020-06-16):

question regarding  how to run own C code on the core

mikemusasa, 2020-06-16:
Hi,
I have managed to perform all of the steps of the read me document and test the hello World.
I was wondering on what is the correct way to run my own written c program on the SweRV core ?

i wrote a simple c code called testar that is suppose to print out a simple text " the test worked " .
I put my C code in  testbench/ asm .
I tried the command make -f $RV_ROOT/tools/Makefile program.hex TEST=testar

 is this the right way to go abou it , even for big C codes  ?

agrobman, 2020-06-28:
there are a few things you need to consider :
1) provided Makefile builds executable from a single source : to build multi-source  program you need to write the build recipe in the <test_name>.makefile, which in the end creates program.hex and data.hex files
2) to run C program, you need to have crt0 or boot code written in assembler which initializes CPU, sets up stack pointer, calls "main" function and terminates simulation. You can review hello_world.s test how to initialize the CPU and terminate simulation and also cmark.c how to add this assembly boot code to a C source.
3) Address map of the CPU/TB - DCCM/ICCM addresses/sizes, Reset Vector, set to 0. Review provided linker command files.
4) the TB memory Data and Program slaves have limited capacity of 64KB each (this can be changed with a parameter value ...
5) the TB memories ignore upper address lines, appearing to the CPU as repeating the same content every 64KB;
6) program.hex and data.hex files should have( @) addresses below 0x10000  to be loaded to the TB memories, any code/data with addresses higher then 0x10000 will be ignored by TB
7) CPU has separate busses for instruction fetches and data accesses, which connected to different TB memories. You may place program code starting from address 0, and data/constants from address 0x10000, but you have to build data.hex file to have addresses below 0x10000. See Makefile for some technics how to do this.
8) to use DCCM see *_dccm.* linker control file - this is a bit tricky. (DCCM need to be preloaded/initialized before use)

Closed 2021-01-22.

Thread 59 (2020-06-22):

problem with the linker and undefined reference  errors ?

mikemusasa, 2020-06-22:
HI !
Is there a problem with the linker when running a c code ?
My c code includes all the necessary librarys and compiles separatly without a problem   but i try to run it using the core , I keep getting undefine reference error for a lot of standard c funtions  example printf ? anyone else had this error ?

the riscv64-unknown-elf-ld fails during the building

agrobman, 2020-06-28:
You have to review your code and find what is missing (what linker complains about)

mikemusasa, 2020-06-28:
I review my code, now whe i try to run it , i am getting some undefined reference errors to simple c funtions Like printf , fread, fopen even the headers to includes these librarys are there.   I saw in the c mark code that they had to write their own printf type of functions .  those the linker have a problem finding their definitions ?

agrobman, 2020-06-28:
The "simple C functions" are not that simple - there is a bunch of code to be executed by the CPU and computer HW/OS/BIOS.

You have to link all used libraries - Swerv Makefile doesn't do this.

However, non of the standard I/O library functions will work on provided TB.

Swerv TB can't execute OS functions as fopen or printif, which require some OS and HW.
It does not have screen/display controller or any hard drive to support file system.
I'm not sure that "-unknown-" tool chain even have all these I/O libraries, which are OS dependent...

You have to provide your own implementation for any I/O functions your program is using.

cmark code is an example of simple terminal emulation with printif function, based on putc function, which in the swerv TB
just writes to a specific address.  The TB  monitors writes to this address on LSU bus to print on screen and a log file.

Closed 2021-01-22.

Thread 60 (2020-06-22):

Add GitHub repository topics

dominiksalvet, 2020-06-22:
Hello SweRV community! :wave:

It would be great to add some relevant GitHub topics to this repository. It may bring more people and help with promoting this core as well as related open-source stuff. What do you think? :thinking:

aprnath, 2020-06-22:
Hi Dominik,
What kind of topics did you have in mind? Some examples/suggestions ?

dominiksalvet, 2020-06-22:
Yeah, e.g., [`processor`](https://github.com/topics/processor), [`risc`](https://github.com/topics/risc), [`riscv`](https://github.com/topics/riscv)/[`risc-v`](https://github.com/topics/risc-v), [`swerv`](https://github.com/topics/swerv) (!), [`open-source`](https://github.com/topics/open-source), [`hardware`](https://github.com/topics/hardware), [`pipeline`](https://github.com/topics/pipeline), [`32-bit`](https://github.com/topics/32-bit), [`wd`](https://github.com/topics/wd), [`superscalar`](https://github.com/topics/superscalar), [`axi`](https://github.com/topics/axi)/[`ahb`](https://github.com/topics/ahb), [`dma`](https://github.com/topics/dma), [`seh1`](https://github.com/topics/seh1)/[`eh1`](https://github.com/topics/eh1), [`pic`](https://github.com/topics/pic), [`systemverilog`](https://github.com/topics/systemverilog)/[`verilog`](https://github.com/topics/verilog), [`hdl`](https://github.com/topics/hdl), [`rtl`](https://github.com/topics/rtl), [`fusesoc`](https://github.com/topics/fusesoc), [`verilator`](https://github.com/topics/verilator), [`fpga`](https://github.com/topics/fpga), [`asic`](https://github.com/topics/asic), ... that should be enough. Feel free to pick the most suitable for you. :smile: :rocket:

aprnath, 2020-06-22:
Great idea. Thank you for the suggestion!

Closed 2020-06-23.

Thread 63 (2020-07-03):

$readmem file address beyond bounds of array

cebaut, 2020-07-03:
Hi,

 I try to simule a small file.c that it uses standard libraries (stdio).
For example to use printf from stdio:
```
#include <stdio.h>
#include "defines.h"
#define ITERATIONS 1
extern int STACK;
int main();

int mult() {
        int a=1000,b=3;
        return a*b;
}

/*********************MAIN************************/

int  main() {
        int result;
        result = mult();
        printf("printf" );

return 0;

}
```

I needed to change the linker script like this :
```
_OUTPUT_ARCH( "riscv" )
ENTRY(_start)

SECTIONS
{
 _start = .;
    . = 0;
  .text   : { *(.text*) }
 _end = .;
  .data  :  ALIGN(0x800) { *(.*data) *(.rodata*) STACK = ALIGN(16) + 0x8000; }
}
```_

and now I have a problem I think with verilator when I try t0 simule :
`VerilatorTB: Start of sim`
`%Error: program.hex:4097: $readmem file address beyond bounds of array`

I would like to know how configure more memory to execute my test?

Thanks,

cebaut :)

agrobman, 2020-07-06:
testbench/ahb_sif.sv memory slave has following parameter, defining size of the external slaves in double words.
This limits code and  data size to 64KB each.

"
parameter MEM_SIZE_DW = 81920;
"

However, with memories size increase,  you may need to change the tools/Makefile too on how to generate the hex files.

Also you probably will need to provide your own implementation on printf/putc functions to get something useful from usage of  printf in swerv demo TB, as standard printf will do nothing there.

cebaut, 2020-07-09:
Hi, thank you for your answer.

I put parameter MEM_SIZE_DW = 16384 to have this limits code and data size to 128KB each.
I launch `make -f $RV_ROOT/tools/Makefile verilator TEST=tst `
but it's always the same problem.
I don't understand what I have to change in tools/Makefile to achieve.
I would like to have a printf from the library standard on my simulation.

 I don't know what is exactely a TB ?

Thaks,

cebaut :)

agrobman, 2020-07-09:
1.  TB – testbench, Verilog environment where the CPU RTL is installed; ( tb_top.sv in Swerv case)
  2.  With increased memory size you need to place data at address 0x20000  in link.ld , changing statement “.= 0x10000;” to “.=0x20000;”
  3.  To link STDIO library – you’ll need to change linker command to add the library.
  4.  Again, standard I/O functions won’t work , you’ll probably can replace “putc” library function by something like:

int putc( char ch){
                *(volatile int *)(0xd0580000) = ch;
             Return ch;
}

TB snoops this address and prints data, as characters to the screen during simulation

--

cebaut, 2020-07-09:
Thanks !
I try that....

cebaut, 2020-07-09:
Hi,
always same message
`%Error: program.hex:4097: $readmem file address beyond bounds of array`
:(
My linker script:

OUTPUT_ARCH( "riscv" )
ENTRY(_start)

SECTIONS
{
 _start = .;
    . = 0;
  .text   : { *(.text*) }
 _end = 0x20000;
  .data  :  ALIGN(0x800) { *(.*data) *(.rodata*) STACK = ALIGN(16) + 0x8000; }
}
```
4.  Again, standard I/O functions won’t work , you’ll probably can replace “putc” library function by something like:

int putc( char ch){
                *(volatile int *)(0xd0580000) = ch;
             Return ch;
}
```
=> I don't do that for the moment !

any idea ?

agrobman, 2020-07-09:
Probably your .text is longer than 128K.

Linker may produce  a map file to see the memory allocations.

Also you can use *_objdump utility to see content of  the executable

-H option gives you output sections info – start address , size , etc
-D allow to disassemble executable.

Also the linker file should be:

OUTPUT_ARCH( "riscv" )
ENTRY(_start)

SECTIONS
{
    . = 0;
  .text   : { *(.text*) }
_end = .;
  . = 0x20000;
  .data  :  ALIGN(0x800) { *(.*data) *(.rodata*) STACK = ALIGN(16) + 0x8000; }
}

For your size of the memories
--

Closed 2021-01-22.

Thread 65 (2020-07-08):

Erasing pending bits for interrupts

albertodbg, 2020-07-08:
Hi, after some changes my code is working on SwerVolf 0.7 and external interrupts are configured, the handler is correctly identified. However, I am unable to clear the pending bits of the external interrupts. After updating the leds with the content of the switches, I have tried this code (and several variations)

_li t0, (RV_PIC_BASE_ADDR + RV_PIC_MEIGWCLR_OFFSET + 0x14)
sw x1, 0(t0)
lw t1, 0(t0)

csrr tp, mip
andi t0, tp, 0x7FF
csrw mip, t0_

However, the pending bit is still active and after coming back to the main loop, the handler is executed again and again. After running step by step, I have noticed that the mip register is never modified. I have read in the documentation that only the supervisor bits can be written, but I am working in M mode, so I guess that I have to erase the 11th bit (MEIP). Using the meigwclr register alone or in combination with the mip erasing, has no effect either. How should this be done? Am I missing something?

agrobman, 2020-07-09:
MIP (Interrupt Pending register) reflects pending interrupt requests. MIP writing does not change its state. The requests need to be cleared in the source. For PIC generated interrupts it need to be done in its sources. It was not clear what are the interrupt sources in your case. For ex, if an interrupt request is caused by a UART receiving a data byte, usually the data need to be read from UART data register to de-assert it's interrupt request, if the corresponded  PIC input  is programmed as level sensitive. meigwclrN register  need to be used to clear pending request if the PIC input is configured as edge sensitive ...

albertodbg, 2020-07-09:
The interrupts are configured to be edge triggered. Let me attach the code (sorry, it is a little dirty as I am testing things). Also, there are many load-stores because the memory viewer is not working well in Code.

[LedsSwitches.S.txt](https://github.com/chipsalliance/Cores-SweRV/files/4895607/LedsSwitches.S.txt)

Thus, I am trying to erase the pending bit using the meigwclr. But for some reason it is not doing anything. The address should be fine, as it is the only enabled interrupt (and I can see that when reading from memory). And in fact the interrupt is enabled, so gateway 5 should be the one.

agrobman, 2020-07-09:
Alberto,

Could you, please, cleanup your code? – I got lost on what you are doing there.
What interrupt input you are trying to serve? How do you generate interrupt request? ( mechanical switches create a lot of bouncing noise, which generates multiple pulses on interrupt requests)

BTW, there is no sense to read meigwclr rgisters – they are write only …

albertodbg, 2020-07-09:
Ok, I have been cleaning the code a little bit. I was reading the meip registers to see if the interrupt flag was cleared, but it was not.

[LedsSwitches_clean.S.txt](https://github.com/chipsalliance/Cores-SweRV/files/4898676/LedsSwitches_clean.S.txt)

I am serving the external interrupt (sw_irq4 is named in the verilog code). The idea is to use the switches, but even without touching them, the interrupt is pending and the handler is triggered.

agrobman, 2020-07-09:
can you single step through your handler and show what the GPR values for each instruction executed in there?

aprnath, 2020-07-10:
Albertodbg, your basic flow looks OK, and should work. Here is an example waveform and instruction trace for a negative edge triggered interrupt[5] sequence:
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

albertodbg, 2020-07-10:
> can you single step through your handler and show what the GPR values for each instruction executed in there?

Here it is. I have modified the destination register: t1 instead of x1. I have realized that x1 is the ra register, but the same behavior remains. Here is the content of the general purpose registers prior to clearing

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

And here it is after clearing the pending interrupt

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

Also, it can be observed that there is a pending interrupt in the t1 register, while the memory viewer is totally blank when showing the meip space.

agrobman, 2020-07-10:
Are you sure that the input 5 does not toggle?

albertodbg, 2020-07-13:
> Are you sure that the input 5 does not toggle?
If I cannot see the memory content, how I am supposed to see this? Loading the program and running a simulation through gtkwave or similar? I mean, I am checking the meip content by loading to a register, but line 5 is always active. Even at the beginning of the program, without interacting with the switches.
> Regarding PIC memory dump - check that your debugger supports memory access from Swerv internal memories ...
I am using riscv-openocd. Is there a special tweak to allow access? These are the options that are configured in my .cfg file
riscv set_prefer_sba on
riscv set_ir idcode 0x9
riscv set_ir dmi 0x22
riscv set_ir dtmcs 0x23

agrobman, 2020-07-13:
Can you use a scope?

I think, openocd does not support read from internal memories ( including PIC) - these are accessed with memory abstract command only.

agrobman, 2020-07-13:
Seems SwerVolf ties off  irq5 (?)

JanMatCodasip, 2020-07-14:
> I think, openocd does not support read from internal memories ( including PIC) - these are accessed with memory abstract command only.

That is correct, the current version of riscv-openocd does not allow to access internal memories (ICCM, DCCM and PIC). There is a patched OpenOCD version for SweRV that has proper support for accessing the internal memories: https://github.com/Codasip/swerv-openocd. If you'd like to try it, please see the README for instructions.

tmw-wdc, 2020-07-15:
Hi @albertodbg,
Please note that the gateway does not implement any edge-detection logic (e.g., an edge-triggered flop) to convert the interrupt request to a level-triggered interrupt signal (see Figure 6-3 of the PRM).  Therefore, the interrupt request input signal must be set to the inactive level (i.e., to ‘0’ for an active-high interrupt and to ‘1’ for an active-low interrupt) to avoid an interrupt request being continuously reported as pending, even after the gateway’s IP latch has been cleared.  Consequently, if the gateway of an unused interrupt request input is programmed to an “active-high” polarity, the interrupt input signal must be tied off to ‘0’.  Likewise, if the polarity is programmed to “active-low”, the interrupt input signal must be tied off to ‘1’.
We will add a note to the PRM to clarify this.

albertodbg, 2020-07-16:
> Hi @albertodbg,
> Please note that the gateway does not implement any edge-detection logic (e.g., an edge-triggered flop) to convert the interrupt request to a level-triggered interrupt signal (see Figure 6-3 of the PRM). Therefore, the interrupt request input signal must be set to the inactive level (i.e., to ‘0’ for an active-high interrupt and to ‘1’ for an active-low interrupt) to avoid an interrupt request being continuously reported as pending, even after the gateway’s IP latch has been cleared. Consequently, if the gateway of an unused interrupt request input is programmed to an “active-high” polarity, the interrupt input signal must be tied off to ‘0’. Likewise, if the polarity is programmed to “active-low”, the interrupt input signal must be tied off to ‘1’.
> We will add a note to the PRM to clarify this.

Ok. But how am I supposed to do this with the PIC registers? Using meigwclr is not working and the meip registers only have reading permission, so I cannot erase the pending bit. Then, how can I deassert extintsrc_req? (in this case bit 5).

On other hand, Table 6-11 and this code in the PRM seem to be incoherent, since type is mapped on bit 1 and polarity on bit 0. In any case, I had both set to 1, so this is not part of the problem.
.macro init_gateway id, polarity, type
             init_gateway_\@:
              li tp, (RV_PIC_BASE_ADDR + RV_PIC_MEIGWCTRL_OFFSET + (\id <<2))
              **li t0, ((\polarity<<1) | \type)**
              sw t0, 0(tp)
.endm

agrobman, 2020-07-16:
You can 1) not to enable tied off interrupts; 2) not to program polarity to 1 for input 5;

albertodbg, 2020-07-16:
> You can 1) not to enable tied off interrupts; 2) not to program polarity to 1 for input 5;

According to Table 6-11

type | 1 | External interrupt type for interrupt source ID S: 0: Level-triggered interrupt 1: Edge-triggered interrupt |   |  
polarity | 0 | External interrupt polarity for interrupt source ID S: 0: Active-high interrupt 1: Active-low interrupt |   |  

I have tested several configurations and what matters is polarity, the type value (level vs edge) does not have any effect. I mean, if polarity is 1, I am going through the handler forever and ever (even without moving the switches); and if polarity is 0, the handler is never triggered. So any of the configurations is working well

agrobman, 2020-07-16:
I don't think you can use tied off interrupts inputs, like #5 in SwerVolf. You will get or no or permanent request. The interrupt request to work some agent needs to assert it and de-assert it when this request is served by the CPU.
You can model such behavior with a GPIO - if you connect the GPIO output to an interrupt request. Setting the GPIO in main will cause interrupt request, then in handler you need to reset the GPIO before exiting the handler.

Or you can use SwerVolf peripherals to generate interrupt requests on connected PIC inputs. Consult with Olof how to accomplish this. (I think UART is connected to PIC, you can program the UART to generate interrupt when it transmits a byte).

albertodbg, 2020-07-24:
> > I think, openocd does not support read from internal memories ( including PIC) - these are accessed with memory abstract command only.
>
> That is correct, the current version of riscv-openocd does not allow to access internal memories (ICCM, DCCM and PIC). There is a patched OpenOCD version for SweRV that has proper support for accessing the internal memories: https://github.com/Codasip/swerv-openocd. If you'd like to try it, please see the README for instructions.

I am trying to debut using this version of openocd. However I am getting the following error:

Warn : Note: Command `add_abstract_mem_range` is a custom workaround for SweRV.
Warn :       (Not part of the official upstream OpenOCD.)
Info : tcl server disabled
Info : telnet server disabled
Warn : Note: This is custom OpenOCD version with extensions and workarounds for SweRV cores.
Info : clock speed 5000 kHz
Info : JTAG tap: riscv.cpu tap/device found: 0x13631093 (mfg: 0x049 (Xilinx), part: 0x3631, ver: 0x1)
**Error: Unsupported DTM version: 9**
Info : starting gdb server for riscv.cpu on pipe
Info : accepting 'gdb' connection from pipe
Error: Target not examined yet
Error executing event gdb-attach on target riscv.cpu:

Error: Target not initialized. Return ERROR_FAIL.
Error: Target not initialized. Return ERROR_FAIL.
Error: get register list failed
Info : Failed detecting Target Description Support, disabling
warning: Remote failure reply: E01
Error: Target not initialized. Return ERROR_FAIL.
.pioinit:13: Error in sourced command file:
Could not read registers; remote failure reply 'E0E'

I attach the whole trace when debugging with -d3
[swerv-openocd_full_trace.txt](https://github.com/chipsalliance/Cores-SweRV/files/4973101/swerv-openocd_full_trace.txt)

JanMatCodasip, 2020-07-27:
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

Hi Alberto,
thank you for the log. What configuration file(s) do you use for OpenOCD? From the log, it seems you're using that `swerv-example.cfg` from the `swerv-openocd` repository.

Please note that this file is meant only as a crude example and needs to be modified for your own situation. Especially your JTAG adapter needs to be configured properly, as well as the JTAG chain in your target hardware.

What JTAG adapter are you using?

- If for instance you are using Olimex ARM-USB-TINY-H adapter, you would need to delete the first section of `swerv-example.cfg` and replace it with `source [find interface/ftdi/olimex-arm-usb-tiny-h.cfg]`.

- Also update your JTAG TAP configuration to match reality (`jtag newtap ...`).

- Finally, update the memory ranges where your ICCM, DCCM and PIC are mapped (`riscv add_abstract_mem_range ....`).

Please let me know if that helped.

Regards,
Jan

albertodbg, 2020-07-27:
>     * Also update your JTAG TAP configuration to match reality (`jtag newtap ...`).

I am using a Nexys A7 board, so the JTAG is the one by Digilent. Basically I have followed swerv-example.cfg structure because it resembled a lot to the .cfg file I was using with the regular riscv-openocd debugger. Let me attach the file

[swerv-nexys-debug.cfg.txt](https://github.com/chipsalliance/Cores-SweRV/files/4983560/swerv-nexys-debug.cfg.txt)

As for the ICCM and DCCM I have used the addresses given in the PRM in Table 2-10.

tmw-wdc, 2020-07-27:
Hi Alberto,
Please note that the address map shown in Table 2-10 of the PRM is just an example.  The actual addresses and sizes of the ICCM and DCCM are core build arguments.

JanMatCodasip, 2020-07-28:
> I am using a Nexys A7 board, so the JTAG is the one by Digilent.

Hi Alberto,
just as a background information, it is important to understand that the JTAG interface on Digilent Nexys A7 board is the JTAG interface of the FPGA chip itself, not SweRV's JTAG port. Those are essentialy two different JTAG interfaces.

In the beginning of this thread, it is mentioned that you're using SweRVolf as your SoC, so I'm assuming that is still the case.

SweRVolf is a special case when it comes to JTAG - it uses a proprietary mechanism (Xilinx BSCAN cell) to "tunnel" the SweRV's JTAG port through the JTAG port of the FPGA chip, so it looks like you are using just one JTAG interface although you deal with two.

For SweRVolf, please update your .cfg file by adding these lines. They are required due to the use of the Xilinx BSCAN cell:

```
riscv set_ir idcode 0x9
riscv set_ir dmi 0x22
riscv set_ir dtmcs 0x23
```

(See also the original SweRVolf's .cfg file: https://github.com/chipsalliance/Cores-SweRVolf/blob/master/data/swervolf_nexys_debug.cfg)

This should make OpenOCD work in your situation.

Feel free to ping back if run into further issues.
Jan

albertodbg, 2020-07-28:
> riscv set_ir idcode 0x9
> riscv set_ir dmi 0x22
> riscv set_ir dtmcs 0x23

Thanks! Now it is working, however the pending bit is still there. But at least I can see the memory content.

aprnath, 2020-08-17:
Thanks for reaching out, Alberto. Hope we have been able to address your issues.

Closed 2020-08-17.

Thread 67 (2020-07-23):

Which signal should I choose to trace Load/Store/pipeline state

ymlei, 2020-07-23:
Hi! I want to trace memory accesses and their target address during the program running on SweRV Core. Which signal should I trace? How about coming to the pipeline state(stall, bypass...)?

deepakpan, 2020-07-30:
Which signals specifically you are looking it? Do you want to look at the DCCM access signals in the waves or through the trace port. Please provide more details and I will try to provide the answer.

Closed 2020-09-01.

Thread 71 (2020-09-01):

dccm initialization

S-Nomii, 2020-09-01:
Hi, I was trying to understand how dccm works, but it keep reporting assertion fail for output data port of dccm is always x. I was trying to use '.word' in my assembly file, and change the link.ld file to make the address fit the dccm region, but the dccm is never loaded with those word i write. I am curious about when and how dccm load the word from my data.hex file?

agrobman, 2020-09-01:
try to understand hello_world_dccm.ld/cmark_dccm.ld - examples how to create executables with DCCM preload for simulations. In real life, CPU has to write DCCM with aligned word size stores before use in program. CPU Boot code is the place for DCCM initialization.

S-Nomii, 2020-09-02:
> try to understand hello_world_dccm.ld/cmark_dccm.ld - examples how to create executables with DCCM preload for simulations. In real life, CPU has to write DCCM with aligned word size stores before use in program. CPU Boot code is the place for DCCM initialization.

Thanks for explaining that, I will check it later, and yesterday I noticed another problem. The store instruction get permission to write back to dccm at dc5 stage, but if I launch an instruction to load data from the same memory space right after that store instruction, the load instruction tried to read data from dccm at dc2 stage and find x in its output port. Then it will raise an assertion failure and I can't find the logic that stop the load instruction from launching.

example code

li x1, 0xf004000
li x2, 0xffffffff
sw x2, 0x0(x1)
lw x3, 0x0(x1)

S-Nomii, 2020-09-02:
Thanks for explaining that, I thought it is the hardware's job to link data between dccm with memory. I noticed another problem yesterday. The store instruction write data back to dccm at dc5 stage, but if I launch a load instruction accessing the same memory space, it tried to read data from dccm at dc2 stage. Since the data has not been written yet, it will read x in the output port and raise several assertion failure.  So I'll be very grateful if you can help me understand how eh1 deal with these sort of reference (if it does) , so I can eliminate those assertion failure.

sample code
li x2, 0xf004000
li x3, 0xffffffff
sw x3, 0x0(x2)
lw x4, 0x0(x2)

S-Nomii, 2020-09-02:
> try to understand hello_world_dccm.ld/cmark_dccm.ld - examples how to create executables with DCCM preload for simulations. In real life, CPU has to write DCCM with aligned word size stores before use in program. CPU Boot code is the place for DCCM initialization.

Thanks for explaining that, I thought it is the hardware's job to link data between dccm and memory. I noticed another problem yesterday. The store instruction write data back to dccm at dc5 stage, but if I launch a load instruction accessing the same memory space, it tried to read data from dccm at dc2 stage. Since the data has not been written yet, it will read x in the output port and raise several assertion failures. So I'll be very grateful if you can help me understand how eh1 deal with these sort of references or data hazard (if it does).

sample code
li x2, 0xf004000
li x3, 0xffffffff
sw x3, 0x0(x2)
lw x4, 0x0(x2)

aprnath, 2020-09-02:
Comments in issue #36 may clarify this for you..

Closed 2021-01-22.

Thread 72 (2020-09-04):

The CSR mepc cann't save correct mret address after Continuous NMI happened

Richard2088, 2020-09-04:
Hi Sir:
    When the Continuous NMI happened,  mepc cann't save the return address correctly.

   And if we Triggered NMI every more then ten milliseconds, everything is ok!

program 1：
20000816:	508010ef          	jal	ra,20001d1e <SMPU_Add_Region>
2000081a:	4585                	li	a1,1
2000081c:	4501                	li	a0,0
2000081e:	4b2010ef          	jal	ra,20001cd0 <SMPU_Enable>
20000822:	20020737          	lui	a4,0x20020
**20000826:	431c                	lw	a5,0(a4) //This LW instruction triggers NMI, and the value stored in MEPC is 20000826**
20000828:	e0000537          	lui	a0,0xe0000
2000082c:	22c50513          	addi	a0,a0,556 # e000022c <__freertos_irq_stack_top+0xfffc022c>
20000830:	0887e793          	ori	a5,a5,136
20000834:	c31c                	sw	a5,0(a4)
20000836:	496020ef          	jal	ra,20002ccc <puts>
2000083a:	4501                	li	a0,0
2000083c:	6ed010ef          	jal	ra,20002728 <exit>

program 2：
20000816:	518010ef          	jal	ra,20001d2e <SMPU_Add_Region>
2000081a:	4585                	li	a1,1
2000081c:	4501                	li	a0,0
2000081e:	4c2010ef          	jal	ra,20001ce0 <SMPU_Enable>
20000822:	200207b7          	lui	a5,0x20020
**20000826:	438c                	lw	a1,0(a5)//This LW instruction triggers NMI, and the value stored in MEPC is 20002b00**
20000828:	e0000537          	lui	a0,0xe0000
2000082c:	22c50513          	addi	a0,a0,556 # e000022c <__freertos_irq_stack_top+0xfffc022c>
20000830:	2d0020ef          	jal	ra,20002b00 <iprintf>
20000834:	e0000537          	lui	a0,0xe0000
20000838:	24450513          	addi	a0,a0,580 # e0000244 <__freertos_irq_stack_top+0xfffc0244>
2000083c:	4a0020ef          	jal	ra,20002cdc <puts>
20000840:	4501                	li	a0,0

program 3：
20000816:	508010ef          	jal	ra,20001d1e <SMPU_Add_Region>
2000081a:	4585                	li	a1,1
2000081c:	4501                	li	a0,0
2000081e:	4b2010ef          	jal	ra,20001cd0 <SMPU_Enable>
20000822:	200207b7          	lui	a5,0x20020
20000826:	08800713          	li	a4,136
2000082a:	e0000537          	lui	a0,0xe0000
**2000082e:	c398                	sw	a4,0(a5) //This SW instruction triggers NMI, and the value stored in MEPC is 20002b6c**
20000830:	22c50513          	addi	a0,a0,556 # e000022c <__freertos_irq_stack_top+0xfffc022c>
20000834:	498020ef          	jal	ra,20002ccc <puts>
20000838:	4501                	li	a0,0
2000083a:	6ef010ef          	jal	ra,20002728 <exit>

Looking forward to your reply
Thanks!
Best wish.

aprnath, 2020-09-04:
NMIs are  nonmaskable and not deferred (and usually fatal), so if an NMI  occurs while you are still handling a prior exception/interrupt, there is no built-in protection available to the processor states to allow recovery, since the hardware architecture does not have provision hardware for nested traps or a trap stack.

If you need to be able to handle nested NMIs, you could try to save off MEPC into a stack structure as the first thing in your handler.. but even that is not a guarantee - since you could really get them back to back in a pathological case.

agrobman, 2020-09-04:
BTW, why do you consider that 1st case is correct and 2,3 are not?

Richard2088, 2020-09-07:
> NMIs are nonmaskable and not deferred (and usually fatal), so if an NMI occurs while you are still handling a prior exception/interrupt, there is no built-in protection available to the processor states to allow recovery, since the hardware architecture does not provision hardware for nested traps or a trap stack.
>
> If you need to be able to handle nested NMIs, you could try to save off MEPC into a stack structure as the first thing in your handler.. but even that is not a guarantee - since you could really get them back to back in a pathological case.

Thank you for your reply！
These NMIs are not generated in exceptions or irq, but in normal procedures.
   It is not the problem of saving empc with the stack, the entry function mepc in nmi_entry is wrong.

Richard2088, 2020-09-07:
> BTW, why do you consider that 1st case is correct and 2,3 are not?

Thank you for your reply！
According to the description of mecp in the document: mepc will save the next instruction that occurs in NMI, so I think it is an error if it does not return normally.

agrobman, 2020-09-07:
how do you know instruction when NMI did occur? How is the NMI generated, "triggered" for your cases?

The Swerv CPU is pipelined machine.  Fetches, instruction commits and Load/Store bus transactions happen in different times. Loads are "non-blocking" and may write target register much later than the loads are "committed" or "executed" from CPU pipe point of view. Any bus errors, caused by external Loads/Store instructions are considered as "asynchronous" to the instruction flow and can be "attached" to any instruction, followed the Load/store instruction with bus error. These NMI exceptions are not "precise" in sense the MEPS does not points on instruction, really caused the exception. For the same code snippet, MEPC can be different, depending on execution and bus timings, even if the same Load/Store instruction is causing the bus error.

The stores are  handled  with a store buffer and considered by the CPU "executed", when issued to the store buffer, but actually create write transactions on the LSU bus later in time. The store bus errors are also "asynchronous" and not precise.

Only load/store errors to DCCM/PIC or external memory with side-effect are handled precisely ...

SW can't use mepc to point on  instruction, caused NMI exception, related to the bus error...

Richard2088, 2020-09-07:
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

Thank you for your reply！
     NMI does not happen inside the core, but outside.  In a normal program, when I use a SW/LW instruction to access the address protected by the MPU, and trigger NMI, it enter nmi_entry and cannot jump to the correct execution address after 'mret'.  We checked the simulation waveform, and did not see the bus error or other errors, but the value saved by MEPC was incorrect, which caused the program jump error after nmi_entry 'mret'.

Thanks!

agrobman, 2020-09-07:
What mcause value do yo get in the exception handler?
Based on my knowledge, MPU violation should cause load access fault (mcause=5) precise exception  and not NMI.

Richard2088, 2020-09-08:
> What mcause value do yo get in the exception handler?
> Based on my knowledge, MPU violation should cause load access fault (mcause=5) precise exception and not NMI.

Thank you for your reply！ Brother.
mcause is not just the cause of the NMI error. When the NMI described above occurs, mcause is 0.
I only use MPU to trigger the NMI problem, and the software can only use this to trigger NMI. The same phenomenon is true if the verification environment sends other NMIs.

agrobman, 2020-09-08:
What MPU are you referring to ? Is this core external unit or SweRV built-in address protection, set up by swerv.config parameters?
If your testbench asserts NMI request pin, you can't expect any specific value in MEPC when NMI exception is taken, unless you tune NMI pin assertion timing specifically for your code  snippet  execution .

BTW, what do you call "other NMIs"?  is this NMI pin assertion or something else? CPU also takes NMI, when gets data bus errors..

agrobman, 2020-09-08:
NMI works similar way as external or timer  interrupt - generally you can't predict at what address your program will be interrupted ...

Richard2088, 2020-09-09:
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

MPU：Memory Protect Unit， Between the bus and flash, access to flash through the bus requires the judgment of MPU。
other NMIs：laser NMI etc.

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

normal program 1 .dis：
20000816: 508010ef jal ra,20001d1e <SMPU_Add_Region>
2000081a: 4585 li a1,1
2000081c: 4501 li a0,0
2000081e: 4b2010ef jal ra,20001cd0 <SMPU_Enable>
20000822: 20020737 lui a4,0x20020
20000826: 431c lw a5,0(a4) //This LW instruction triggers NMI, and the value stored in MEPC is 20000826
20000828: e0000537 lui a0,0xe0000
2000082c: 22c50513 addi a0,a0,556 # e000022c <__freertos_irq_stack_top+0xfffc022c>
20000830: 0887e793 ori a5,a5,136
20000834: c31c sw a5,0(a4)
20000836: 496020ef jal ra,20002ccc
2000083a: 4501 li a0,0
2000083c: 6ed010ef jal ra,20002728

20000826: trigger NMI， Enter nmi_entry function, return with 'mret'
The program jumps to 20000826 again，Stuck in an endless loop。

And program 2, program 3 as show above,  MEPC The value saved by mepc is random, there is no rule

agrobman, 2020-09-09:
All you see is expected. Depending on execution timing you can get NMI on L/S instruction, which triggers NMI pin assertion or other instructions after. If NMI falls on your triggering L/S instruction you'll have no forward progress. BTW, what exactly you are trying accomplish with this exercise? and you are right - the MEPC value at NMI exception can't be predicted. I wrote already that NMIs are not precise and not recoverable. Once you got NMI, only reliable action you can take is to record the event in memory and reset the system.

Richard2088, 2020-09-09:
> or other instructions after. If NMI falls on your triggering L/S instruction you'll have no forward progress. BTW, what exactly you a

Thank you for your reply！SIR。
 I am practicing the difference in architecture and function between ARM core and RISCV core. I found that contex-m3 can be recovered from NMIs. I can design the threshold of the number of nmi occurrences and how to decide whether to reset system.  However, the riscv core cannot be recovered from the NMI.
In this RISCV CORE situation, the system can only be reset after an NMI occurs.
Thanks！

Richard2088, 2020-09-09:
> All you see is expected. Depending on execution timing you can get NMI on L/S instruction, which triggers NMI pin assertion or other instructions after. If NMI falls on your triggering L/S instruction you'll have no forward progress. BTW, what exactly you are trying accomplish with this exercise? and you are right - the MEPC value at NMI exception can't be predicted. I wrote already that NMIs are not precise and not recoverable. Once you got NMI, only reliable action you can take is to record the event in memory and reset the system.

> All you see is expected. Depending on execution timing you can get NMI on L/S instruction, which triggers NMI pin assertion or other instructions after. If NMI falls on your triggering L/S instruction you'll have no forward progress. BTW, what exactly you are trying accomplish with this exercise? and you are right - the MEPC value at NMI exception can't be predicted. I wrote already that NMIs are not precise and not recoverable. Once you got NMI, only reliable action you can take is to record the event in memory and reset the system.

Thank you for your reply！SIR。
I am practicing the difference in architecture and function between ARM core and RISCV core. I found that contex-m3 can be recovered from NMIs. I can design the threshold of the number of nmi occurrences and how to decide whether to reset system. However, the riscv core cannot be recovered from the NMI.
In this RISCV CORE situation, the system can only be reset after an NMI occurs.
Thanks！

Richard2088, 2020-09-09:
> All you see is expected. Depending on execution timing you can get NMI on L/S instruction, which triggers NMI pin assertion or other instructions after. If NMI falls on your triggering L/S instruction you'll have no forward progress. BTW, what exactly you are trying accomplish with this exercise? and you are right - the MEPC value at NMI exception can't be predicted. I wrote already that NMIs are not precise and not recoverable. Once you got NMI, only reliable action you can take is to record the event in memory and reset the system.

Thank you for your reply！SIR。
I am practicing the difference in architecture and function between ARM core and RISCV core. I found that contex-m3 can be recovered from NMIs. I can design the threshold of the number of nmi occurrences and how to decide whether to reset system. However, the riscv core cannot be recovered from the NMI.
In this RISCV CORE situation, the system can only be reset after an NMI occurs.
Thanks！

agrobman, 2020-09-09:
In case you want to notify CPU about an access violation, the better way is to drive rresp[0] = 1. The cpu will set data error address register (mdseac) to the faulty access address . CPU will still get  NMI exception, but with more info about the problem.

Richard2088, 2020-09-10:
> In case you want to notify CPU about an access violation, the better way is to drive rresp[0] = 1. The cpu will set data error address register (mdseac) to the faulty access address . CPU will still get NMI exception, but with more info about the problem.

Sir, I just want to achieve this effect.
   The system is reset after 100 NMI visits. If it is less than 100 times, it will continue to run.  Can you advise how to do it?  Thank you

agrobman, 2020-09-10:
there is no reliable way to achieve your goal.

Richard2088, 2020-09-11:
> there is no reliable way to achieve your goal.

If it is not possible to resume operation from NMIs, is this a design flaw in the core?  There are still bugs ?

aprnath, 2020-09-11:
The behavior is as intended. NMIs are not meant to replace regular/periodic/maskable interrupts - which is really what you should be using. The expected use for NMIs are for near fatal hardware errors. It is better/recommended that the system go into some sort of software-initiated-reset or scrub after logging the NMI. And if you get an NMI storm then reset if your only option for any forward progress.

While you **may** recover from a single (or multiple sparse) NMI, they cannot be masked or nested, and therefore you cannot guarantee that a 2nd NMI will not occur while you are "handling" the first. The 2nd will overwrite the MEPC from the 1st. Which is why, in your original case, if you spread them out enough it will work.. but if you get NMIs close together, you will never be able to recover.

Richard2088, 2020-09-14:
> The behavior is as intended. NMIs are not meant to replace regular/periodic/maskable interrupts - which is really what you should be using. The expected use for NMIs are for near fatal hardware errors. It is better/recommended that the system go into some sort of software-initiated-reset or scrub after logging the NMI. And if you get an NMI storm then reset is your only option for any forward progress.
>
> While you **may** recover from a single (or multiple sparse) NMI, they cannot be masked or nested, and therefore you cannot guarantee that a 2nd NMI will not occur while you are "handling" the first. The 2nd will overwrite the MEPC from the 1st. Which is why, in your original case, if you spread them out enough it will work.. but if you get NMIs close together, you will never be able to recover.

Sir: this is not a question of NMI nesting.
   We have the NMI interrupt source enable bits, and only the bit enbale can trigger the corresponding NMI.
    nmi_entry function:
                  disable NMI source bits
                  push stack
                  processing nmi interrupt (only print interrupt source code)
                 pop stack
                 enable NMI source bit

We have done almost all the experiments, and our conclusion is.
   After the occurrence of NMI, the program cannot continue to execute by returning from MEPC.
   But Contex-M is ok

Richard2088, 2020-09-15:
> The behavior is as intended. NMIs are not meant to replace regular/periodic/maskable interrupts - which is really what you should be using. The expected use for NMIs are for near fatal hardware errors. It is better/recommended that the system go into some sort of software-initiated-reset or scrub after logging the NMI. And if you get an NMI storm then reset is your only option for any forward progress.
>
> While you **may** recover from a single (or multiple sparse) NMI, they cannot be masked or nested, and therefore you cannot guarantee that a 2nd NMI will not occur while you are "handling" the first. The 2nd will overwrite the MEPC from the 1st. Which is why, in your original case, if you spread them out enough it will work.. but if you get NMIs close together, you will never be able to recover.

lw a0, 0(a1)  //can trigger NMI
lw a2, 0(a3)  //can trigger NMI
When two instructions that can trigger NMI are put together, mepc will not be stored corrected and 'mret' cannot be returned.
   Is the problem caused by CORE dual launch?

agrobman, 2020-09-17:
Not, and  again I would recommend to read RISCV spec/CPU PRM,  before making any assumptions about design correctness. NMI is treated by the RISCV spec and design as un-recoverable event, and CPU can't return to normal execution after it. CPU can provide some hints about the NMI reason, but not always precisely. SW needs to threat these hints with caution . For example, for LSU bus errors, CPU records only first faulty address, and it's not necessary from the first L/S instruction in flow in your example ...

Richard2088, 2020-09-23:
> Not, and again I would recommend to read RISCV spec/CPU PRM, before making any assumptions about design correctness. NMI is treated by the RISCV spec and design as un-recoverable event, and CPU can't return to normal execution after it. CPU can provide some hints about the NMI reason, but not always precisely. SW needs to threat these hints with caution . For example, for LSU bus errors, CPU records only first faulty address, and it's not necessary from the first L/S instruction in flow in your example ...

AS "riscv-privileged-20190608-1.pdf" saied

3.1.15 Machine Exception Program Counter (mepc)
mepc is an MXLEN-bit read/write register formatted as shown in Figure 3.21. The low bit of mepc
(mepc[0]) is always zero. On implementations that support only IALIGN=32, the two low bits
(mepc[1:0]) are always zero.
If an implementation allows IALIGN to be either 16 or 32 (by changing CSR misa, for example),
then, whenever IALIGN=32, bit mepc[1] is masked on reads so that it appears to be 0. This
masking occurs also for the implicit read by the MRET instruction. Though masked, mepc[1]
remains writable when IALIGN=32.
mepc is a WARL register that must be able to hold all valid physical and virtual addresses. It
need not be capable of holding all possible invalid addresses. Implementations may convert some
invalid address patterns into other invalid addresses prior to writing them to mepc.
When a trap is taken into M-mode, mepc is written with the virtual address of the instruction
that was interrupted or that encountered the exception. Otherwise, mepc is never written by the
implementation, though it may be explicitly written by software.

The actual situation now is that mepc cannot guarantee when a continuous NMI interrupt occurs.

Closed 2021-01-22.

Thread 73 (2020-09-11):

pic

S-Nomii, 2020-09-11:
hi, i was using eh1 to study memory access in cpu, and i have trouble understanding the pic module. Since pic module is suppose to handle interruptions, what does it have to do with load and store instruction, and why check if address is in the pic region. I tried to load data from 0xf00c0000, the data never write back to register file.

agrobman, 2020-09-11:
Read PIC chapter of SweRV PRM - Some of the PIC control/status registers are implemented as memory mapped, i.e. accessible with CPU Load/Store instructions and the PIC registers are included in SweRV internal memory region.

S-Nomii, 2020-09-12:
> Read PIC chapter of SweRV PRM - Some of the PIC control/status registers are implemented as memory mapped, i.e. accessible with CPU Load/Store instructions and the PIC registers are included in SweRV internal memory region.

Thanks for explaining its usage to me, but I haven't study interruptions part yet. Can I currently consider that PIC address region is only available under interruption circumstances and not available for normal load/store instruction.

aprnath, 2020-09-13:
The PIC address space is for programming and querying the PIC control registers. It should not be treated as "memory" for load/stores.

S-Nomii, 2020-09-13:
> The PIC address space is for programming and querying the PIC control registers. It should not be treated as "memory" for load/stores.

thanks that is very helpful.

olofk, 2020-09-13:
I would like to clarify a thing. Because the PIC registers are internal to the CPU, you can read and write normally with load and store operations but you won't see any accesses to these addresses on the external buses. It also means you can't access them with a debugger like other memory. You need to use "abstract memory commands" for that.

Closed 2020-09-13.

Thread 74 (2020-09-13):

mcontrol chain bit not WARL on triggers 1 & 3

wronkiew-ghs, 2020-09-13:
Setting a store address & value breakpoint using chained triggers succeeds in setting and reading back the mcontrol registers if triggers 1 & 2 are used, but the breakpoint is hit on instructions which do not match the second trigger. These are the values read from mcontrol & tdata2 on triggers 1 & 2:

t1 mcontrol 0x2be018c2
t1 tdata2 0xf0040005
t2 mcontrol 0x2be81042
t2 tdata2 0xaaaaaaaa

In my test program the trigger fired on writes to 0xf0040004 which had values other than 0xaaaaaaaa. If I used triggers 0 & 1 instead the data HWBP worked correctly. I also found the chain bit could be set and read back on trigger 3.

The EH1 PRM section on mcontrol notes that attempts to set chain on triggers 1 & 3 are ignored because chaining is only supported on pairs 0/1 and 2/3. RISC-V debug 0.13.2 specifies all tdata registers are WARL so the debugger can determine which features are supported.

This case is likely to come up if a store addr & value HWBP is set after a simple exec HWBP.

tmw-wdc, 2020-09-15:
Thank you for reporting this issue.  We are looking into it and will report back.

tmw-wdc, 2020-10-01:
After some internal discussions, we have decided to fix the issue you have reported.  In the next release of the SweRV EH1 core, the _chain_ bit of MCONTROL will have WARL behavior (i.e., the chain bit value will always be '0' for reads of MCONTROL for triggers 1 and 3).
Thank you again for reporting this issue.  Much appreciated!

wronkiew-ghs, 2020-10-01:
Thank you very much for looking into this.

Closed 2020-10-01.

Thread 77 (2020-10-09):

NMI HELP

Richard2088, 2020-10-09:
Hi SIR:
If the A instruction triggers the NMI, the B instruction that follows is related to the A instruction, and the nmi interrupt processing function cannot continue to execute through the mepc return.
 If the following B instruction and A instruction are not related, the nmi interrupt processing function can return to normal execution through mepc.

tmw-wdc, 2020-10-09:
Hi,

Please have a look at Section 3.4 of the [ratified RISC-V Privileged spec](https://github.com/riscv/riscv-isa-manual/releases/download/Ratified-IMFDQC-and-Priv-v1.11/riscv-privileged-20190608.pdf).  NMIs can destroy processor state and it can therefore not be expected that normal program execution can resume, especially in the case of NMI storms.

We have added the following note to Section 2.15 of the SweRV EH1 PRM v1.8 release to emphasize this:

**Note:** NMIs are typically fatal! Section 3.4 of the RISC-V Privileged specification [2] states that NMIs are only used for hardware error conditions and cause an immediate jump to the address at the NMI vector running in M-mode regardless of the state of a hart’s interrupt enable bits. The NMI can thus overwrite state in an active M-mode interrupt handler and normal program execution cannot resume. Unlike resets, NMIs do not reset hart state, enabling diagnosis, reporting, and possible containment of the hardware error. Because NMIs are not maskable, the NMI handling routine performing diagnosis and reporting is itself susceptible to further NMIs, possibly making any such activity meaningless and erroneous in the face of error storms.

Closed 2021-01-22.

Thread 78 (2020-10-24):

Speculative load observed on LSU AXI

pieter3d, 2020-10-24:
I'm playing with a program on the EH1 that ends up issuing a speculative data load, despite the PRM saying that EH1 does not do this.

Code snippet:

```
; Function finishing up
lw s11, 12(sp)
lw s10, 16(sp)
; ... snip ...
lw s0, 56(sp)
lw ra, 60(sp)
addi sp, sp, 64
ret
; Some other function
lw a4, 4(a1)
```

I see the load after the `ret` go out, but it doesn't show up in the trace as expected since it isn't supposed to execute. Also a4 is correctly left untouched as expected. The issue is that the load happens on AXI, which is slow and causes a sizable bubble.

agrobman, 2020-10-24:
could you, please, provide more details:
1) what platform are you running? (provide description of environment where the EH1 is installed;
 what is EH1 configuration?
2) snapshot of waves; if simulated
3) register values before the snippet; mrac, mfdc values, etc
4) will be nice if the problem can be shown on testbench, provided in this repo, plus test snippet source.

pieter3d, 2020-10-24:
1 - Linux, running vcs simulator. EH1 in a relatively small design, bare metal code (no RTOS). Cache disabled, DCCM and ICCM only (both 32kB). IFU AXI interface tied off, code is loaded in through DMA port, then core is reset for boot.
2 - Will work on getting this.
3 - mrac = 0xaaaaaaaa (all regions marked as having side effect).
     mfdc = 0x8. Branch predict disabled. Note that enabling it has the same behavior.
4 - Will see if I can get this put together.

In general though - is this something that I should expect? Or would you agree something fishy is going on?

pieter3d, 2020-10-24:
Here's the wave dump. You can see the large stall caused by the AXI load, even though that's a speculative load that doesn't even show up in the trace.
[snip.vcd.gz](https://github.com/chipsalliance/Cores-SweRV/files/5432336/snip.vcd.gz)

agrobman, 2020-10-24:
this may be effect of branch predictor, but we need to take closer look..
At least we may need to change PRM wording ...

pieter3d, 2020-10-24:
The AXI read is not from the IFU, it's from the LSU. Also this happens with branch prediction disabled too.

It reads with address = a1 + 4, where a1 just has some unrelated data value in it, thus a bogus address. The corresponding memory region is marked as having side effects so I would expected that kind of prefetch to have been suppressed. If this is expected behavior, it seems to me that you could always get arbitrary and unpredictable reads based on whatever code is running, which could potentially cause lots of problems.

aprnath, 2020-10-24:
Hi pieter3d, please indicate which version of SweRV you are using. In version 1.8, there was a bug fix for a speculative load to region marked non-idempotent. See the [release notes](https://github.com/chipsalliance/Cores-SweRV/blob/master/release-notes.md) for version 1.8.

pieter3d, 2020-10-24:
I am using version 1.6. I tried with version 1.8, and indeed this load no longer shows up. Thanks for the pointer!

agrobman, 2020-10-24:
CPU always try to prefetch code. Without branch predictor it prefetches forward, placing instructions to decode stage.
once CPU executes taken branch (in later execution stage), it discards/flushes all following instructions and their effects.
decode stage may send load instructions to LSU for execution, which eventually may go to the bus speculatively.
1.8 fixes this problem for side-effect loads, but 'normal' loads still may go to the bus speculatively with somewhat random addresses.
 If some memory locations should be protected from CPU accesses EH1 'MPU' feature can be used. (DATA_ACCESS_ENABLE*, DATA_ACCESS_ADDR* DATA_ACCESS_MASK*)

Seems we need change PRM wording about LSU speculation ...

pieter3d, 2020-10-24:
The MPU features are compile time static though right? That couldn't be used to work around the LSU issue in pre-1.8 silicon for example.

agrobman, 2020-10-24:
yes, these are compile time defines. They could solve this problem, if you are not using LSU bus - system does not have external data memory. Or you have external data 'normal' memory, and you don't want to have these speculative accesses to go to some other locations (for ex, if these won't provide response). mrac settings are somewhat solve your problem, but have pretty course granularity ... and will make your external memory(if you have some) relatively slow ..

Closed 2020-10-24.

Thread 81 (2020-11-23):

Macro definitions not being found

rlb1116, 2020-11-23:
I am trying to use this SweRV core in a Quartus project, but I am unable to compile due to definitions of text macros (RV_XXX_YYY) used by design files not being found by the compiler. This results in syntax errors on the lines that try to use them.

I found most of these have been defined in the common_defines.vh file, which gets created as part of a "snapshot" configuration via the Make flow. However, even though I have added this file to my Quartus project, it does not seem to get recognized, and I noticed that none of the design files explicitly "include" this header file.

I imagine I could get past this by explicitly including common_defines.vh in every design file that uses one of its macros; however, in addition to the tediousness of this, it seems like that would have already been included if it were truly necessary. Is there a standard, or expected, compilation flow which naturally finds these definitions, and therefore would make explicit inclusion of the header file redundant? If so, what am I missing?

I did notice in the filelist design/flist.questa (of which I included all available files listed into my Quartus project), the file design/include/def.sv does not exist on Github, nor is it created by Make. I am not sure if this is important, or has intentionally been discontinued, but it seemed like there may have been a chance that this could be the "missing link" between the macro definitions and the rest of the design files.

Any help would be appreciated!

agrobman, 2020-11-23:
the `RV_* defines are created by swerv.config script in snapshots/<target>/common_defines.vh file, which need to be included in list of files for compilation before RTL files one time, something like:

snapshorts/default/common_defines.vh
-f $RV_ROOT/design/flist

plus all needed +incdir +libext and etc ..

flist.questa is outdated, I think. Consult with tools/Makefile how to compile swerv with Questa.
You may need to use full path names to the files ..

Notice that Makefile compiles also DemoTB files you may not need in your project ..

olofk, 2020-11-24:
Hi,

If you use FuseSoC, this will be done automatically for you. Unfortunately it seems like SweRV doesn't work with Quartus (at least not the on the no-cost version) due to some syntax problems. I just tried to do a quick test synthesis of swerv with quartus for a random device using

    fusesoc run --tool=quartus --target=synth chipsalliance.org:cores:SweRV_EH1:1.8 --family="Cyclone V" --device=5CSEMA4U23C6

This resulted in 198 syntax errors, most of them being something like

    Error (10170): Verilog HDL syntax error at lsu_trigger.sv(48) near text: "for";  expecting "endmodule". Check for and fix any syntax errors that appear immediately before or at the specified keyword. The Intel FPGA Knowledge Database contains many articles with specific details on how to resolve this error. Visit the Knowledge Database at https://www.altera.com/support/support-resources/knowledge-base/search.html and search for this specific error message number. File: /home/olof/projects/swervolf/quartus/src/chipsalliance.org_cores_SweRV_EH1_1.8/design/lsu/lsu_trigger.sv Line: 48
    Error (10170): Verilog HDL syntax error at lsu_trigger.sv(58) near text: "end";  expecting "endmodule". Check for and fix any syntax errors that appear immediately before or at the specified keyword. The Intel FPGA Knowledge Database contains many articles with specific details on how to resolve this error. Visit the Knowledge Database at https://www.altera.com/support/support-resources/knowledge-base/search.html and search for this specific error message number. File: /home/olof/projects/swervolf/quartus/src/chipsalliance.org_cores_SweRV_EH1_1.8/design/lsu/lsu_trigger.sv Line: 58
Error (10112): Ignored design unit "lsu_trigger" at lsu_trigger.sv(25) due to previous errors File: /home/olof/projects/swervolf/quartus/src/chipsalliance.org_cores_SweRV_EH1_1.8/design/lsu/lsu_trigger.sv Line: 25

I think it could be that quartus doesn't like unnamed for generate loops, but I didn't investigate further.

Also, if you want to try this yourself, I found a small error in the core description file. Check out https://github.com/chipsalliance/Cores-SweRV/pull/82 for a fix

Closed 2021-01-22.

Thread 83 (2020-12-02):

How can I debug using Verilator and gdb

kingstone1927, 2020-12-02:
Hello,

I am wondering how I can debug a C program using Verilator and riscv-gdb on Core SweRV EH1.
Do I need openOCD and JTAG to bridge Verilator and riscv-gdb? I saw people imitate a JTAG by writing a JTAG dpi, is is the only way to go?
My goal is to debug a C program that is simulated in Verilator. I appreciate it if someone could point me to the right direction.

Thanks in advance.

agrobman, 2020-12-02:
yes, you can connect openOCD to verilator simulation, -you need to add JTAG agent, compatible with openocd, to the verilog model you simulate. However, the GDB-openocd-verilator link can be very slow.
If your program isn't that big, you can use exec.log and *.dis file to debug what processor did, running your program.

kingstone1927, 2020-12-02:
Thank you. The *.dis seems like what I am looking for. However,  I am still curious how I can use GDB-openOCD-verilator together.
Do you know where I can find example codes for a JTAG agent for the riscv-openocd? Also what commands or steps I need to connect opendOCD with Verilator?
One last point: I tried writing hello_world.c as follow, but it seems like the processor does not like this. Do you know a guide that I can follow to write a proper c-program for SweRV Core? Again, Thanks so much.
```
#include <stdio.h>
int main() {
   // printf() displays the string inside quotation
   printf("Hello, World!");
   return 0;
}
```

olofk, 2020-12-02:
Hi. You can use SweRVolf for this https://github.com/chipsalliance/Cores-SweRVolf It has instructions in the readme for how to connect OpenOCD to a verilator simulator and a SoC running on FPGA

agrobman, 2020-12-02:
the DemoTB does not like your code because we don't link stdlibs and the DemoTB does not have display or/and OS with file system to print to. also you need some startup code to call main . Look at cmark.c example, how we implement printf and startup code .. Again EL2 repo has more advance support for C programs ...

JanMatCodasip, 2020-12-03:
> I am still curious how I can use GDB-openOCD-verilator together.
Do you know where I can find example codes for a JTAG agent for the riscv-openocd? Also what commands or steps I need to connect opendOCD with Verilator?

I also do recommend following @olofk's suggestion above - take a look at Cores-SweRVolf.

SweRVolf contains easy-to-follow instructions how to run SweRV core in either Verilator simulation or in an FPGA. Both the simulation and FPGA have support for UART output, so you can run programs with `printf`s and observe the output.

kingstone1927, 2020-12-03:
Thank you for your responses. This really helps. I will take a look at Core-SweRVolf

Closed 2021-01-21.

Thread 85 (2020-12-14):

Delay after fetching instructions when not using icache

crazy-catlady, 2020-12-14:
I have the following program:
```
and x3, x1, x12       # instr1
and x4, x5, x6         # instr2
and x7, x8, x10       # instr 3
and x12, x14, x16   # instr 4

and x13, x11, x2     # instr 5
and x20, x21, x22   # instr 6
and x23, x24, x25   # instr 7
and x26, x27, x28   # instr 8
```

The execution trace like this:
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

What I notice here is that it takes 10 cycles for the new instructions (5,6) to arrive at the decoder.
This is not beneficial for fast execution, since the CPU is kind of idle for 5 cycles between writing instructions 3 and 4 and reading instructions 5 and 6.

Are there configuration parameters to increase the instruction/fetch buffer? Such that it is possible to have more than 4 instructions in execution?
I also couldn't really find out if this is due to the instruction buffer size in the decoder (which seems to have 4 instruction slots but somehow only has 2) or the fetch buffer size in the IFU.

Any ideas?

agrobman, 2020-12-14:
this core should be able to execute 2 integer instructions per clock. Make sure you are running code from the cache and fast external memory or from ICCM.
the MRAC CSR register needs to be programmed to enable caching ...

crazy-catlady, 2020-12-15:
I turned on the icache and now it works as expected after the respective instructions are cached. Thanks!

However, I do not need 16 kB of icache, i want to have way less.

Is it safe to change `NUM_WAYS` and `NUM_BANKS` (https://github.com/chipsalliance/Cores-SweRV/blob/7332edc0adaa7e9a0c842d169154429e8d987786/design/ifu/ifu_ic_mem.sv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) to do so?

agrobman, 2020-12-15:
you can set cache size to 8K, I think - run swerv.config -help for possible build parameters ranges.
BTW, you can check out more modern smaller EL2 core ...

crazy-catlady, 2020-12-15:
Ok, I managed to tweak it down to 2048 Byte. However, it is more of a hack...I had to add modules to mem_lib.sv and modify the config script of course.

The EL2 does not exactly fit my purposes, since I need a core as pipelined as possible, preferably dual issue.

However, thank you very much for your help. I really appreciate it.
All my questions are resolved now.

Closed 2020-12-15.

Thread 86 (2021-01-07):

Stall point

kingstone1927, 2021-01-07:
How can I know when the core is stalled when running? is there a way for me to display/know the cycle when the core is stalled?

Thanks in advance

aprnath, 2021-01-07:
Hi @kingstone1927,

SweRV's performance monitor counters allow for counting stall events. So if you want to know the internal signals for stall events, the simplest would be to look at the signals from the various blocks to the perf counter logic in the `dec` block.

Here are the signals at the `dec` level for stall events :
```
    pmu_align_stall
    ifu_pmu_fetch_stall
    dec_pmu_decode_stall
    dec_pmu_presync_stall
    dec_pmu_postsync_stall
```
Hope this helps!

kingstone1927, 2021-01-07:
@aprnath Thank you!

The simulation generates the ```exec.log``` file. Do you know if there is a way for me explicitly display "stalled cycled" on the ```exec.log```.
I am trying to see exactly what is happening at the instruction level: what happens to the entire core when one unit is stalled, where exactly a stall happens and when it happens. Do you know if it is possible to do that and which tools I can use to do it?

aprnath, 2021-01-07:
@kingstone1927,

Yes, it is definitely possible. The `exec.log` file is created in `testbench/tb_top.v`, and all the code to monitor the commits and print the info is in that file (around line 330): https://github.com/chipsalliance/Cores-SweRV/blob/7332edc0adaa7e9a0c842d169154429e8d987786/testbench/tb_top.sv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
You can add any additional formatted monitors in the testbench and have them write to the `exec.log` file handle (`el`) with the appropriate timestamps to show what is happening in the pipeline.

kingstone1927, 2021-01-07:
@aprnath Wow this is really cool! Thanks!

I will take a look at the file.

aprnath, 2021-01-07:
Good luck!

Closed 2021-01-07.

Thread 90 (2021-01-20):

tlu_flush_path_e4

kingstone1927, 2021-01-20:
Can someone help me understand this snippet of code from `dec_tlu_ctl.sv`?

```
   assign tlu_flush_path_e4[31:1] = take_reset ? rst_vec[31:1] :

                                     ( ({31{~take_nmi & i0_mp_e4}} & exu_i0_flush_path_e4[31:1]) |
                                      ({31{~take_nmi & ~i0_mp_e4 & i1_mp_e4 & ~rfpc_i0_e4 & ~lsu_i0_exc_dc4}} & exu_i1_flush_path_e4[31:1]) |
                                      ({31{~take_nmi & sel_npc_e4}} & npc_e4[31:1]) |
                                      ({31{~take_nmi & rfpc_i0_e4}} & dec_tlu_i0_pc_e4[31:1]) |
                                      ({31{~take_nmi & rfpc_i1_e4}} & dec_tlu_i1_pc_e4[31:1]) |
                                      ({31{interrupt_valid}} & interrupt_path[31:1]) |
                                      ({31{(i0_exception_valid_e4 | lsu_exc_valid_e4 | (trigger_hit_e4 & ~trigger_hit_dmode_e4)) & ~interrupt_valid}} & {mtvec[30:1],1'b0}) |
                                      ({31{~take_nmi & mret_e4 & ~wr_mepc_wb}} & mepc[31:1]) |
                                      ({31{~take_nmi & debug_resume_req_f}} & dpc[31:1]) |
                                      ({31{~take_nmi & sel_npc_wb}} & npc_wb[31:1]) |
                                      ({31{~take_nmi & mret_e4 & wr_mepc_wb}} & dec_csr_wrdata_wb[31:1]) );
```

Thanks

aprnath, 2021-01-21:
This is the PC address that the core is going to fetch after flushing the entire pipeline due to one or more of:
- Interrupt taken,
- mispredict from i0 at E4,
- mispredict from i1 at E4,
- exception,
- microarch refetch of the current pc,
- microarch refetch of the next pc,
- mret,
- resume from halt,
- resume from debug halt,
- reset,
- and nmi.

kingstone1927, 2021-01-21:
@aprnath  Thank you! This is a huge help for me.

Can you point me to code sections that control/command "flushing the entire pipeline" ? Also, where in the design are the pipelines defined and created? I look forward to you answers.

I appreciate your help.

aprnath, 2021-01-21:
Hi @kingstone1927 ,
Follow these signals from the dec/tlu block:
```
design/dec/dec.sv:  output logic dec_tlu_flush_noredir_wb ,    // Tell fetch to idle on this flush
design/dec/dec.sv:   output logic dec_tlu_flush_leak_one_wb,   // single step
design/dec/dec.sv:   output logic dec_tlu_flush_err_wb,        // iside perr/ecc rfpc
design/dec/dec.sv:   output logic        dec_tlu_flush_lower_wb,     // tlu flush due to late mp, exception, rfpc, or int
design/dec/dec.sv:   output logic [31:1] dec_tlu_flush_path_wb,      // tlu flush target
```

kingstone1927, 2021-01-21:
@aprnath Thank you!

Can you point me to where the pipeline registers are instantiated/created?

Again, I appreciate your help

aprnath, 2021-01-22:
I am afraid there is single place where all the pipeline registers exist. It is distributed around the core. Look for stage name suffixes. The PRM has a pipeline block diagram that could be your guide.

kingstone1927, 2021-01-23:
@aprnath  Thank you! I will take a look at the PRM

kingstone1927, 2021-01-23:
@aprnath  I just have one more question for this post

```
rvdffe #(32) csr_rs1_ff (.*, .en(i0_e1_data_en), .din(csr_rs1_in_d[31:0]), .dout(exu_csr_rs1_e1[31:0]));
```
Is this an example of a pipeline register?

Thank you

Thread 92 (2021-02-15):

cmark_dccm fails to build

danielmlynek, 2021-02-15:
riscv64-unknown-elf-gcc -Isnapshots/default -g -O3 -funroll-all-loops -mabi=ilp32 -march=rv32imc -nostdlib -c /builds/gitlab/gliwice/Cores-SweRV/testbench/tests/cmark_dccm/cmark_dccm.c -o cmark_dccm.o
Building cmark_dccm
riscv64-unknown-elf-gcc -mabi=ilp32 -march=rv32imc -Wl,-Map=cmark_dccm.map -lgcc -T/builds/gitlab/gliwice/Cores-SweRV/testbench/tests/cmark_dccm/cmark_dccm.ld -o cmark_dccm.exe cmark_dccm.o -nostartfiles
/opt/riscv-64/lib/gcc/riscv64-unknown-elf/10.2.0/../../../../riscv64-unknown-elf/bin/ld: warning: cannot find entry symbol _start; defaulting to 0000000000000000
/opt/riscv-64/lib/gcc/riscv64-unknown-elf/10.2.0/../../../../riscv64-unknown-elf/bin/ld: cmark_dccm.o: in function `main':
/builds/gitlab/gliwice/Cores-SweRV/testbench/tests/cmark_dccm/cmark_dccm.c:1116: undefined reference to `whisperPrintf'
/opt/riscv-64/lib/gcc/riscv64-unknown-elf/10.2.0/../../../../riscv64-unknown-elf/bin/ld: /builds/gitlab/gliwice/Cores-SweRV/testbench/tests/cmark_dccm/cmark_dccm.c:1144: undefined reference to `whisperPrintf'
/opt/riscv-64/lib/gcc/riscv64-unknown-elf/10.2.0/../../../../riscv64-unknown-elf/bin/ld: /builds/gitlab/gliwice/Cores-SweRV/testbench/tests/cmark_dccm/cmark_dccm.c:1149: undefined reference to `whisperPrintf'
/opt/riscv-64/lib/gcc/riscv64-unknown-elf/10.2.0/../../../../riscv64-unknown-elf/bin/ld: /builds/gitlab/gliwice/Cores-SweRV/testbench/tests/cmark_dccm/cmark_dccm.c:1060: undefined reference to `whisperPrintf'
/opt/riscv-64/lib/gcc/riscv64-unknown-elf/10.2.0/../../../../riscv64-unknown-elf/bin/ld: /builds/gitlab/gliwice/Cores-SweRV/testbench/tests/cmark_dccm/cmark_dccm.c:1157: undefined reference to `whisperPrintf'
/opt/riscv-64/lib/gcc/riscv64-unknown-elf/10.2.0/../../../../riscv64-unknown-elf/bin/ld: cmark_dccm.o:/builds/gitlab/gliwice/Cores-SweRV/testbench/tests/cmark_dccm/cmark_dccm.c:1131: more undefined references to `whisperPrintf' follow

agrobman, 2021-02-15:
Daniel, check that you have latest Makefile and testbench/asm/cmark_dccm.mki - Make should compile  and link 3 files crt0.s, cmark.c and printf.c
program compilation flow was changed a bit with 1.9

agrobman, 2021-02-15:
or just remove testbench/tests/cmark_dccm directory ..

danielmlynek, 2021-02-23:
I see that directory testbench/tests/cmark_dccm
was removed in commit: https://github.com/chipsalliance/Cores-SweRV/commit/f3da044f15dac4cea67ed3dc76fd86300f4a59f9
Update env works fine for me. Im closing this one.

Closed 2021-02-23.

Thread 98 (2021-06-18):

Timing violations with Vivado

Rusty-Wire, 2021-06-18:
Hello, i'm working on a softcore design based on the SweRV with Vivado.

When I proceed with the synthesis, there are a lot of timing violations problems which appears (even when running the core at 100MHz)

Any ideas about this ? Can I place some timing exceptions between registers without risks ? And which ones ?

Maybe someone already met this situation ?

olofk, 2021-06-18:
Perhaps you would be interested in [SweRVolf](https://github.com/chipsalliance/Cores-SweRVolf), the reference platform for SweRV which has targets for simulation and implementation for a Nexys A7 board with Vivado.

It should be noted though that SweRVolf runs SweRV EH1 at 50MHz. You can speed it up a bit by playing around with the CPU configuration, e.g. reducing branch predictor, caches etc. But in practice I haven't been able to make it run faster than 65 MHz or so. Some of the constructs are highly optimized for ASIC implementation and not very suitable for FPGA which is why it won't run much faster without invasive changes to the core

Rusty-Wire, 2021-06-18:
Yes, I tried SweRVolf some time ago but it seems Vivado didn't support all the SystemVerilog fonctionnalities in simulation of some modules (don't remember which ones). I probably don't do it in the right way.

Actually, I've build up one custom design with the SweRV and SmartConnect, UART, GPIO, DDR2 MIG Xilinx IPs (All clocked at 100MHz). All is working fine in simulation and on-board (NexysA7). But yeah, my timing report is very bad.

Thank you again for the informations, I didn't know that use this CPU on an FPGA would restrict so much the target frequency.

agrobman, 2021-06-18:
Do you have RV_FPGA_OPTIMIZE define defined  for your FPGA build?
if not, you may try add -set fpga_optimize  switch to swerv.config.  it should increase maximum frequency of design by removing clock gating cells ...

Rusty-Wire, 2021-06-29:
Yeah it is in my case.

Indeed, when I stay below 50MHz, it works properly and all my timings errors disappear so thank you again !

Closed 2021-06-29.

Thread 102 (2021-09-01):

openocd timeout occurs when trying to load elf file using command 'load_image'.

nikhill-agnisys, 2021-09-01:
Hello all,

I am trying to debug SweRV RISCV RTL v1.9 during simulation using bitbang bridge and openocd in my environment. For this, I have instantiated SimJTAG module in my testbench and connected it with swerv core. Now, using bitbang a server socket is created and I am able to listen on port 9999.

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

In another terminal (terminal 2) , I launched openocd (vOpen On-Chip Debugger 0.11.0+dev-01861-g6edf98db7-dirty) using my 'sim_swervjtag.cfg' file, the contents of config file are shown below,

`
adapter speed 100

adapter driver remote_bitbang
remote_bitbang_host localhost

remote_bitbang_port 9999

set _CHIPNAME riscv

jtag newtap $_CHIPNAME cpu -irlen 5 -expected-id 0x01

set _TARGETNAME $_CHIPNAME.cpu
target create $_TARGETNAME riscv -chain-position $_TARGETNAME

riscv set_enable_virt2phys off

riscv set_mem_access abstract

riscv expose_csrs 1988

proc swerv_eh1_execute_fence {} {
reg csr1988 0x3
}

$_TARGETNAME configure -event resume-start {
swerv_eh1_execute_fence
}

$_TARGETNAME configure -event step-start {
swerv_eh1_execute_fence
}

init

halt
`

On another terminal (terminal 3), When I connect using telnet localhost 4444 and try to issue load_image command after reset I get timeout error as below,

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

On terminal 2, it outputs as shown without -d debug switch,

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

With debug switch -d, please find attached the log file 'openocd.log',

[openocd.log](https://github.com/chipsalliance/Cores-SweRV/files/7089227/openocd.log)

I have tried increasing the timeout interval using 'riscv set_command_timeout_sec' to 2000 but then it never comes out.

If possible, please point me to any pointer on how to resolve this. Thanks.

olofk, 2021-09-01:
Is there any reason why you are using the bitbang bridge instead of jtag_vpi, which is the supported solution in SweRVolf?

olofk, 2021-09-01:
Oh, sorry. I thought this was the SweRVolf repo, not the SweRV repo. Anyway, SweRVolf, the reference platform for SweRV support this out of the box if that is of any help

nikhill-agnisys, 2021-09-01:
There is no specific reason, it is just I am not using verilator but xcelium, and I find it a little easy to link 'bitbang' and 'SimJTAG.v' DPI files with it.

agrobman, 2021-09-01:
based on what I see in your logs - openocd could not connect/access Swerv JTAG controller -
(it tries to read JTAG ID register , but gets all 0s from it. Normally it would find Manufacturer ID as of WDC ).

agrobman, 2021-09-01:
What is your design memory map? what do you have at address 0x0? Do you have ICCM/DCCM and what address is set for PIC? what are the base addresses you set for ICCM/DCCM and PIC?

Based on the attached openocd trace the CPU was instructed to execute memory write abstract command to address 0x0, which was timed out.

if you run simulation, you should see the CPU System Bus (SB) write transaction started (AWVALID, WVALID from the CPU - check, that you get corresponded  *READY are asserted too, then what you get BVALID from SB slave) - all in case if address 0x0 is not base address of ICCM/DCCM or PIC.

BTW, in the provided TB SB is tied off  - any abstract command to the core external memory will time out. If you are trying to load your code to external memory, you'll need a sort of crossbar to route  SB transactions to IFU bus slave memory. (does not exist in this testbench) to be able load code by debugger to that memory.

If your design configuration does have ICCM, you may consider to compile your test to ICCM addresses. In that case CPU will load your code to the ICCM.  but if your CPU reset vector does not point to ICCM you'll need set up PC to the start address of your test before running it.   Or you may configure your CPU to have ICCM starting from address 0x0 ..

nikhill-agnisys, 2021-09-13:
Hello everyone,

It was really helpful to have your inputs, thank you all for the wonderful contributions. After spending some additional time in target simulation I was able to find why my abstract commands were failing. My SB was indeed tied of, causing debug state to remain as 'SB_CMD_RESP' for rest of the simulation.

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

Adding crossbar to route the transactions worked for me. Thanks for the suggestion @agrobman

Also, thanks @olofk  for pointing me to the reference SwerRVolf repository, I tried it out and it really supports it out of the box. I am able to fix my issue now.

Closed 2021-09-13.

Thread 103 (2021-09-14):

Try running multi thread program on swerv EH1 core

rajat-agnisys, 2021-09-14:
Hello,

I am trying to run multi thread program on EH1 core but facing some assertion fail in core RTL.
Is EH1 supports multi thread programming?

Thanks
Rajat

aprnath, 2021-09-14:
EH1 implements only a single hardware thread. EH2 supports two hardware threads.

rajat-agnisys, 2021-09-14:
Thanks,
I will try with EH2

Closed 2021-09-21.

Thread 104 (2021-12-07):

CoreMark test score

Zissi-Lei, 2021-12-07:
Hi, I achieved 5.0 at CoreMark test by running EH1 in FPGA, using master branch and the configurations you gave in the doc "SweRV_CoreMark_Benchmarking.pdf". But in your web page "https://www.westerndigital.com/solutions/business/risc-v", I see that the CoreMark score of the EH1 core is 5.7. I want to known how you configure the EH1 core to achieve 5.7 CoreMark/MHz, thanks.

aprnath, 2021-12-08:
Hi,
We get additional performance by playing with compiler flags. There are many different variations, and it is also dependent on compiler builds and versions.
Try this :
`-mtune=sifive-7-series -mbranch-cost=1 -Ofast -funroll-all-loops -march=rv32gc -mabi=ilp32  --param=hot-bb-frequency-fraction=1 --param=max-jump-thread-duplication-stmts=2 --param=max-tail-merge-iterations=0 -fno-aggressive-loop-optimizations -fgcse-las --param=max-grow-copy-bb-insns=7 --param=unroll-jam-min-percent=0 --param=large-unit-insns=0 -fno-delete-null-pointer-checks -fno-rename-registers --param=max-partial-antic-length=1 --param=loop-max-datarefs-for-datadeps=0 -funroll-all-loops --param=uninlined-function-insns=16 -fno-tree-vrp -fwrapv -fno-toplevel-reorder --param=max-inline-insns-size=128 -fipa-pta --param=max-cse-path-length=3 --param=inline-min-speedup=1 --param=max-sched-region-insns=7 --param=max-goto-duplication-insns=0 --param=max-gcse-insertion-ratio=0 -fno-tree-ter --param=max-average-unrolled-insns=128 -fno-dce --param=max-loop-header-insns=2 -fno-tree-loop-ivcanon -fno-tree-loop-distribute-patterns -fno-sched-rank-heuristic`

There are probably other combinations that would give better results.

Zissi-Lei, 2021-12-09:
@aprnath Thank you very much! I used the compiler flags you gave above and finally achieved 6.25 CoreMark/MHz!

Closed 2021-12-14.

Thread 108 (2022-01-26):

Fusesoc's sim target is deprecated

RRozak, 2022-01-26:
When I run the following command in the root of the repository:
`fusesoc --cores-root . run --target=sim chipsalliance.org:cores:SweRV_EH1:1.8`
I get the error:
```
ERROR: Setup failed : Cannot find testbench/hex/data.hex in :
        .
        .
```
This file is required by the fileset: https://github.com/chipsalliance/Cores-SweRV/blob/master/swerv.core#L61, but it was removed from the repository in one of the previous versions.

agrobman, 2022-01-26:
I think you should remove this data.hex filename from the fileset file. It is not used anymore in simulations. Besides you should use executable build flow from tools/Makefile, instead of canned hex files.

--

RRozak, 2022-01-27:
I removed this line and changed the one with `program.hex`:
```diff
diff --git a/swerv.core b/swerv.core
index b6f986e..ef8c41e 100644
--- a/swerv.core
+++ b/swerv.core
@@ -58,8 +58,7 @@ filesets:

   mem_init:
     files:
-      - testbench/hex/data.hex : {copyto : data.hex}
-      - testbench/hex/program.hex : {copyto : program.hex}
+      - tools/program.hex : {copyto : program.hex}
     file_type : user

   tb:
```
and I got the fusesoc error:
```
INFO: Preparing chipsalliance.org:cores:SweRV_EH1:1.8
INFO: Generating chipsalliance.org:cores:SweRV_EH1-swerv_ahb_config:1.8
INFO: Wrote dependency graph to path/Documents/sv-tests/build/chipsalliance.org_cores_SweRV_EH1_1.8/sim-verilator/chipsalliance.org_cores_SweRV_EH1_1.8.deps-after-generators.dot
INFO: Wrote Makefile fragment to path/Documents/sv-tests/build/chipsalliance.org_cores_SweRV_EH1_1.8/sim-verilator/core-deps.mk
INFO: Setting up project
INFO: Building simulation model

Traceback (most recent call last):
  File "path/.local/bin/fusesoc", line 10, in <module>
    sys.exit(main())
  File "path/.local/lib/python3.7/site-packages/fusesoc/main.py", line 835, in main
    fusesoc(args)
  File "path/.local/lib/python3.7/site-packages/fusesoc/main.py", line 825, in fusesoc
    args.func(cm, args)
  File "path/.local/lib/python3.7/site-packages/fusesoc/main.py", line 412, in run
    args.verbose,
  File "path/.local/lib/python3.7/site-packages/fusesoc/main.py", line 515, in run_backend
    backend.build()
  File "path/.local/lib/python3.7/site-packages/edalize/edatool.py", line 187, in build
    self.build_main()
  File "path/.local/lib/python3.7/site-packages/edalize/verilator.py", line 166, in build_main
    self._run_tool('make', args, quiet=True)
  File "path/.local/lib/python3.7/site-packages/edalize/edatool.py", line 390, in _run_tool
    check=True)
  File "/usr/lib/python3.7/subprocess.py", line 467, in run
    raise ValueError('stdout and stderr arguments may not be used '
ValueError: stdout and stderr arguments may not be used with capture_output.
```

olofk, 2022-01-27:
Hi @RRozak. Thank you for reporting. I fixed this and made a PR now https://github.com/chipsalliance/Cores-SweRV/pull/109

The final Python error you encountered though is caused by something else and needs to be fixed in FuseSoC. I'm looking for more information about that right now

olofk, 2022-01-27:
@RRozak Sorry, I see now the error is in Edalize, not FuseSoC. Could you please tell me which version of Edalize you are using? If Edalize (or FuseSoC) was installed through pip, you can check with `pip3 show edalize`

RRozak, 2022-01-27:
Hi,
I have Edalize in version 0.2.4 and FuseSoC in 1.12.1.dev31+g14dfc82.

olofk, 2022-01-27:
I think you managed to hit a bug that exists in some versions of python 3.7 (https://bugs.python.org/issue36760) I can't easily reproduce it, but it might disappear if you add the `--verbose` flag, as in `fusesoc --verbose --cores-root . run --target=sim chipsalliance.org:cores:SweRV_EH1:1.8`

agrobman, 2022-01-27:
@olofk , program.hex file is used to load I and D side memories of the core TB, created by tools/Makefile prior simulation.
I don't think the file should be pre-requisite to the simulation.

@RRozak , you can try to create empty program.hex, data.hex files in testbench/hex directory to satisfy fusesoc - they are not used really

agrobman, 2022-01-27:
@RRozak ,

BTW, there is no such file:

   mem_init:
     files:
-      - testbench/hex/data.hex : {copyto : data.hex}
-      - testbench/hex/program.hex : {copyto : program.hex}
**_+      - tools/program.hex : {copyto : program.hex}_**
     file_type : user

olofk, 2022-01-27:
@RRozak The SweRV PR is merged now. If adding `--verbose` to FuseSoC doesn't solve the other problem, please open an FuseSoC bug report and we can look at it there

RRozak, 2022-01-28:
It works now, even without verbose flag.
Thank you very much for help. I close this issue.

> BTW, there is no such file:

I my local repository there was that file, I ran make command in tools directory: https://github.com/chipsalliance/Cores-SweRV/blob/master/tools/Makefile#L163
I modified this file only to check if it can work or if another problems happen like the one with python error.

Closed 2022-01-28.

Thread 110 (2022-06-13):

Question about pipeline FF enable signals

tunefish777, 2022-06-13:
Hi,

I'm currently trying to understand the pipeline but I'm puzzled by one small detail. The `dec_iX_decode_d` signal is used as the highest value of the `iX_pipe_en` signal which is then shifted down the pipe. From this value, we derive the enable signals (`iX_eX_data_en` and `iX_eX_ctl_en`) for the individual pipeline FFs. For the `...data_en` signals, this makes sense to me, but the `...ctl_en` signals stay active for one additional cycle. This leads to some "random" value being latched in the control FFs one cycle after `dec_iX_decode_d` changes to 0 (due to stalling etc.). So far, I don't think this "random" value matters, since the piped destination-packet contains a valid-decode flag that is not set for this cycle. But what was the design decision for this behavior?
Is this related to the comment that reads "// allow illegals to flow down the pipe"?

I would really appreciate some explanation.

Kind regards

Thread 116 (2023-01-24):

Blocking Loads/DMA disable

omezrich, 2023-01-24:
Hi,

Looking for some more information regarding blocking loads/non-blocking loads,
what is the purpose of blocking loads, why stall DMA accesses on external access with side-effects?
What are the considerations for _not_ disabling them (_bldmad_ in mfdc csr)?

Thanks!

Thread 118 (2023-03-06):

The new feature of verilator stops building procession

LoveMyPillow, 2023-03-06:
Verilator has a new feature called "IMPLICTSTATIC warning", when a function is implictly static, in the version v5.006.
When I run the command `make -f $RV_ROOT\tools\Makefile`
The shell print
`%Warning-IMPLICITSTATIC: /home/hiramhsu/W-VeeR/Cores-VeeR-EH1-main/testbench/dasm.svi:393:17: Function/task's lifetime implicitly set to static`
And the building procession will be stopped because of these warnings.
I have to downgrade the version of verilator into v5.004 so that I can run the simulation.

algrobman, 2023-07-18:
this is verilator bug - ask the tool developer to fix this. A verilog simulator supposed to support verilog standard which allows functions definitions without qualifiers. Verilator should issue Note and not warning, killing compilation, if they want.
Another way to fix this problem - to add -Wno-IMPLICITSTATIC compilation switch

Thread 122 (2023-12-22):

Instruction after pmpaddr0 csr write was not executed

Ankelih, 2023-12-22:
Hello,

When I tried to run riscv-isa test rv32ui-p-add on Veer EH-1 core, I observed that the instruction after pmpaddr0 csr write operation is not executed and I cannot see it in the log file. However, when I run the same code with Spike ISS, I see the next instruction after csr write operation. You can find the executable, its dump, and logs from core and spike iss below. Can anyone help me figure out what going on in this situation?

[rv32ui-p-add.zip](https://github.com/chipsalliance/Cores-VeeR-EH1/files/13757163/rv32ui-p-add.zip)

algrobman, 2023-12-22:
As far as I know EH1 does not have PMP - CPU should take illegal exception on pmpaddr0 write ... You need to modify your test to avoid programming PMP and other facilities, unimplemented in this CPU.

Ankelih, 2023-12-23:
@algrobman Thank you for the information, however the situation is a little bit weird. Yes, I can see that core takes illegal operation on pmpaddr0 however I can see in the log that instruction is executed. After that one, there is one li instruction in the code but it is not logged on the trace and it is not executed.  In the screenshot you can see the trace log from core(left) and from spike(right).

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

algrobman, 2023-12-23:
the testbench / tracer are confusing in sense of printing trace log with exceptions. Really instructions #48, #49 are not executed, but trapped .

You can't compare  spike and EH1 traces - spike implements more CSRs than EH1 and EH1 has privet CSRs , spike does not have.

You better compare the RTL with whisper ISS.

Ankelih, 2023-12-23:
@algrobman Okay, they are trapped, and not executed really, but I do not understand why the core is not executing the instruction address 0x0000010C. I also use whisper ISS, and whisper skips that "li" instruction too. Since the Veer EH-1 is a RISC-V core, it should cover the standards.  As far as I know pmpaddr0 is a machine-level CSR and Veer EH-1 is supporting machine-level. So, it should support pmpaddr0 I guess. But for now, my main question is why the core not executing the "li" instruction.

Thanks for the suggestion about trace printing, I'll add it to the testbench.

algrobman, 2023-12-23:
The test code is a bit tricky - instead of having unimplemented instruction handler , the test presets mtvec to instruction, next to one, potentially could be trapped (which are all CSR writes ) just before each of these CSR access instructions.  This makes the CPU to skip pieces of code related to unimplemented CSRs programming.

The RISCV spec defines PMP as optional facility, so this core does not implement it. There is no sense in PMP for Machine mode only CPU. It more usable if U or/and S modes are implemented.

BTW, trace with exceptions printing can look like:

```
     16595 :      #36 0 000000d4 00000297   x5=000000d4 ; auipc   x5,0x0
     16604 :      #37 0 000000d8 01028293   x5=000000e4 ; addi    x5,x5,16
     16605 :      #38 0 000000dc 30529073               ; csrrw   x0,mtvec,x5
     16613 : Exception 0 Cause=0x02 mtval=74445073
     16613 :      #39 0 000000e0 74445073               ; csrrwi  x0,csr_744,0x08 !EXCEPTION!
     16629 :      #40 0 000000e4 00000297   x5=000000e4 ; auipc   x5,0x0

```

algrobman, 2023-12-23:
>  but I do not understand why the core is not executing the instruction address 0x0000010C.
the test sets up mtvec to 0x114 before programming PMP CSRs - once write to pmpaddr0 traps CPU goes directly to 0x114

Ankelih, 2023-12-23:
@algrobman Thank you very much, I understand the situation now.
I am closing the case.

Closed 2023-12-23.

Thread 128 (2025-01-08):

Hit max cycle count (10000000) .. stopping

noobwei, 2025-01-08:
This issue continues some issues from the previous issue: [https://github.com/chipsalliance/Cores-VeeR-EH1/issues/125](url)
My colleague is configuring the environment in a new VM according to the documentation wirtten by me: [https://github.com/noobwei/Y-Lab/blob/main/20241226.md](url)

But build the tool chain without the tags like `--with-arch=rv32imc_zicsr --with-abi=ilp32`, but a riscv64 toolchain.

Here is the log of `riscv64-unknown-elf-gcc -v`:

```shell
wjy1@wjy1:/opt/riscv/bin$ export PATH=/opt/riscv/bin:$PATH
wjy1@wjy1:/opt/riscv/bin$ riscv64-unknown-elf-gcc -v
Using built-in specs.
COLLECT_GCC=riscv64-unknown-elf-gcc
COLLECT_LTO_WRAPPER=/opt/riscv/libexec/gcc/riscv64-unknown-elf/14.2.0/lto-wrapper
Target: riscv64-unknown-elf
Configured with: /home/wjy1/桌面/riscv-gnu-toolchain/gcc/configure --target=riscv64-unknown-elf --prefix=/opt/riscv --disable-shared --disable-threads --enable-languages=c,c++ --with-pkgversion= --with-system-zlib --enable-tls --with-newlib --with-sysroot=/opt/riscv/riscv64-unknown-elf --with-native-system-header-dir=/include --disable-libmudflap --disable-libssp --disable-libquadmath --disable-libgomp --disable-nls --disable-tm-clone-registry --src=.././gcc --disable-multilib --with-abi=lp64d --with-arch=rv64gc --with-tune=rocket --with-isa-spec=20191213 'CFLAGS_FOR_TARGET=-Os    -mcmodel=medlow' 'CXXFLAGS_FOR_TARGET=-Os    -mcmodel=medlow'
Thread model: single
Supported LTO compression algorithms: zlib
gcc version 14.2.0 ()
```

So I modified the L23 of Makefile to  `--with-abi=lp64d_zicsr --with-arch=rv64gc`

But the result of `make -f $RV_ROOT/tools/Makefile` is `Hit max cycle count (10000000) .. stopping`

Here is the full log:

```shell
wjy1@wjy1:~/桌面/Cores-VeeR-EH1$ make -f $RV_ROOT/tools/Makefile
rm -rf *.log *.s *.hex *.dis *.tbl irun* vcs* simv* *.map snapshots veer* \
verilator* *.exe obj* *.o ucli.key vc_hdrs.h csrc *.csv \
work dataset.asdb  library.cfg
BUILD_PATH=snapshots/default /home/wjy1/桌面/Cores-VeeR-EH1/configs/veer.config -target=default -set iccm_enable
veer: Set(s) requested : iccm_enable
veer: Overriding iccm_enable value 0 with 1

VeeR configuration for target=default

veer: bht_size                       = 128
veer: bht_addr_lo                    = 4
veer: reset_vec                      = 0x80000000
veer: sb_bus_tag                     = 1
veer: ifu_bus_tag                    = 3
veer: dma_bus_tag                    = 1
veer: btb_index1_lo                  = 4
veer: btb_addr_lo                    = 4
veer: btb_size                       = 32
veer: icache_enable                  = 1
veer: icache_size                    = 16
veer: icache_tag_low                 = 6
veer: pic_meie_count                 = 8
veer: pic_meigwctrl_offset           = 0x4000
veer: pic_mpiccfg_count              = 1
veer: pic_meigwclr_offset            = 0x5000
veer: pic_total_int                  = 8
veer: pic_meipt_offset               = 0x3004
veer: pic_meip_count                 = 4
veer: pic_size                       = 32
veer: pic_meipl_offset               = 0x0000
veer: pic_mpiccfg_offset             = 0x3000
veer: pic_offset                     = 0xc0000
veer: pic_region                     = 0xf
veer: pic_meigwclr_count             = 8
veer: pic_meigwctrl_mask             = 0x3
veer: pic_meipt_count                = 8
veer: pic_meie_mask                  = 0x1
veer: pic_meip_offset                = 0x1000
veer: pic_meigwctrl_count            = 8
veer: pic_meipl_mask                 = 0xf
veer: pic_meipl_count                = 8
veer: pic_meipt_mask                 = 0x0
veer: pic_mpiccfg_mask               = 0x1
veer: pic_meip_mask                  = 0x0
veer: pic_meie_offset                = 0x2000
veer: pic_meigwclr_mask              = 0x0
veer: external_mem_hole              = default disabled
veer: dccm_region                    = 0xf
veer: dccm_size                      = 64
veer: dccm_offset                    = 0x40000
veer: dccm_num_banks                 = 8
veer: dccm_enable                    = 1
veer: iccm_enable                    = 1
veer: iccm_size                      = 512
veer: iccm_num_banks                 = 8
veer: iccm_offset                    = 0xe000000
veer: iccm_region                    = 0xe
veer: nmi_vec                        = 0x11110000
veer: lsu_stbuf_depth                = 8
veer: dec_instbuf_depth              = 4
veer: lsu_num_nbload                 = 8
veer: dma_buf_depth                  = 4
veer: fpga_optimize                  = 1
veer: ret_stack_size                 = 4
veer: Writing snapshots/default/common_defines.vh
veer: Writing snapshots/default/defines.h
veer: Writing snapshots/default/pd_defines.vh
veer: Writing snapshots/default/whisper.json
veer: Writing snapshots/default/perl_configs.pl
veer: Writing snapshots/default/link.ld
riscv64-unknown-elf-cpp -Isnapshots/default  /home/wjy1/桌面/Cores-VeeR-EH1/testbench/tests/hello_world/hello_world.s  > hello_world.cpp.s
riscv64-unknown-elf-as  hello_world.cpp.s -o hello_world.o
Building hello_world
riscv64-unknown-elf-gcc  -Wl,-Map=hello_world.map -lgcc -T/home/wjy1/桌面/Cores-VeeR-EH1/testbench/link.ld -o hello_world.exe hello_world.o -nostartfiles
riscv64-unknown-elf-objcopy -O verilog hello_world.exe program.hex
riscv64-unknown-elf-objdump -S  hello_world.exe > hello_world.dis
Completed building hello_world
echo '`undef ASSERT_ON' >> snapshots/default/common_defines.vh
verilator --cc -CFLAGS "-std=c++14" snapshots/default/common_defines.vh /home/wjy1/桌面/Cores-VeeR-EH1/design/include/veer_types.sv -I/home/wjy1/桌面/Cores-VeeR-EH1/design/include -I/home/wjy1/桌面/Cores-VeeR-EH1/design/lib  -Isnapshots/default \
                -Wno-UNOPTFLAT \
                -I/home/wjy1/桌面/Cores-VeeR-EH1/testbench \
        -f /home/wjy1/桌面/Cores-VeeR-EH1/testbench/flist \
                /home/wjy1/桌面/Cores-VeeR-EH1/testbench/tb_top.sv /home/wjy1/桌面/Cores-VeeR-EH1/testbench/ahb_sif.sv \
                --top-module tb_top -exe test_tb_top.cpp --autoflush
- V e r i l a t i o n   R e p o r t: Verilator 5.033 devel rev v5.032-20-ge171463fa
- Verilator: Built from 38.579 MB sources in 117 modules, into 15.338 MB in 22 C++ files needing 0.011 MB
- Verilator: Walltime 2.684 s (elab=0.223, cvt=2.056, bld=0.000); cpu 2.645 s on 1 threads; alloced 172.344 MB
cp /home/wjy1/桌面/Cores-VeeR-EH1/testbench/test_tb_top.cpp obj_dir
make -j -C obj_dir/ -f Vtb_top.mk OPT_FAST="-Os"
make[1]: 进入目录“/home/wjy1/桌面/Cores-VeeR-EH1/obj_dir”
ccache g++  -I.  -MMD -I/usr/local/share/verilator/include -I/usr/local/share/verilator/include/vltstd -DVM_COVERAGE=0 -DVM_SC=0 -DVM_TIMING=0 -DVM_TRACE=0 -DVM_TRACE_FST=0 -DVM_TRACE_VCD=0 -faligned-new -fcf-protection=none -Wno-bool-operation -Wno-shadow -Wno-sign-compare -Wno-tautological-compare -Wno-uninitialized -Wno-unused-but-set-parameter -Wno-unused-but-set-variable -Wno-unused-parameter -Wno-unused-variable    -std=c++14   -Os  -c -o test_tb_top.o test_tb_top.cpp
ccache g++ -Os  -I.  -MMD -I/usr/local/share/verilator/include -I/usr/local/share/verilator/include/vltstd -DVM_COVERAGE=0 -DVM_SC=0 -DVM_TIMING=0 -DVM_TRACE=0 -DVM_TRACE_FST=0 -DVM_TRACE_VCD=0 -faligned-new -fcf-protection=none -Wno-bool-operation -Wno-shadow -Wno-sign-compare -Wno-tautological-compare -Wno-uninitialized -Wno-unused-but-set-parameter -Wno-unused-but-set-variable -Wno-unused-parameter -Wno-unused-variable    -std=c++14   -c -o verilated.o /usr/local/share/verilator/include/verilated.cpp
ccache g++ -Os  -I.  -MMD -I/usr/local/share/verilator/include -I/usr/local/share/verilator/include/vltstd -DVM_COVERAGE=0 -DVM_SC=0 -DVM_TIMING=0 -DVM_TRACE=0 -DVM_TRACE_FST=0 -DVM_TRACE_VCD=0 -faligned-new -fcf-protection=none -Wno-bool-operation -Wno-shadow -Wno-sign-compare -Wno-tautological-compare -Wno-uninitialized -Wno-unused-but-set-parameter -Wno-unused-but-set-variable -Wno-unused-parameter -Wno-unused-variable    -std=c++14   -c -o verilated_threads.o /usr/local/share/verilator/include/verilated_threads.cpp
ccache g++ -Os  -I.  -MMD -I/usr/local/share/verilator/include -I/usr/local/share/verilator/include/vltstd -DVM_COVERAGE=0 -DVM_SC=0 -DVM_TIMING=0 -DVM_TRACE=0 -DVM_TRACE_FST=0 -DVM_TRACE_VCD=0 -faligned-new -fcf-protection=none -Wno-bool-operation -Wno-shadow -Wno-sign-compare -Wno-tautological-compare -Wno-uninitialized -Wno-unused-but-set-parameter -Wno-unused-but-set-variable -Wno-unused-parameter -Wno-unused-variable    -std=c++14   -x c++-header Vtb_top__pch.h -o Vtb_top__pch.h.fast.gch
ccache g++   -I.  -MMD -I/usr/local/share/verilator/include -I/usr/local/share/verilator/include/vltstd -DVM_COVERAGE=0-DVM_SC=0 -DVM_TIMING=0 -DVM_TRACE=0 -DVM_TRACE_FST=0 -DVM_TRACE_VCD=0 -faligned-new -fcf-protection=none -Wno-bool-operation -Wno-shadow -Wno-sign-compare -Wno-tautological-compare -Wno-uninitialized -Wno-unused-but-set-parameter -Wno-unused-but-set-variable -Wno-unused-parameter -Wno-unused-variable    -std=c++14   -x c++-header Vtb_top__pch.h -o Vtb_top__pch.h.slow.gch
echo "" > Vtb_top__ALL.verilator_deplist.tmp
ccache g++   -I.  -MMD -I/usr/local/share/verilator/include -I/usr/local/share/verilator/include/vltstd -DVM_COVERAGE=0-DVM_SC=0 -DVM_TIMING=0 -DVM_TRACE=0 -DVM_TRACE_FST=0 -DVM_TRACE_VCD=0 -faligned-new -fcf-protection=none -Wno-bool-operation -Wno-shadow -Wno-sign-compare -Wno-tautological-compare -Wno-uninitialized -Wno-unused-but-set-parameter -Wno-unused-but-set-variable -Wno-unused-parameter -Wno-unused-variable    -std=c++14   -include Vtb_top__pch.h.slow -c -o Vtb_top__ConstPool_0.o Vtb_top__ConstPool_0.cpp
ccache g++   -I.  -MMD -I/usr/local/share/verilator/include -I/usr/local/share/verilator/include/vltstd -DVM_COVERAGE=0-DVM_SC=0 -DVM_TIMING=0 -DVM_TRACE=0 -DVM_TRACE_FST=0 -DVM_TRACE_VCD=0 -faligned-new -fcf-protection=none -Wno-bool-operation -Wno-shadow -Wno-sign-compare -Wno-tautological-compare -Wno-uninitialized -Wno-unused-but-set-parameter -Wno-unused-but-set-variable -Wno-unused-parameter -Wno-unused-variable    -std=c++14   -include Vtb_top__pch.h.slow -c -o Vtb_top___024root__Slow.o Vtb_top___024root__Slow.cpp
ccache g++   -I.  -MMD -I/usr/local/share/verilator/include -I/usr/local/share/verilator/include/vltstd -DVM_COVERAGE=0-DVM_SC=0 -DVM_TIMING=0 -DVM_TRACE=0 -DVM_TRACE_FST=0 -DVM_TRACE_VCD=0 -faligned-new -fcf-protection=none -Wno-bool-operation -Wno-shadow -Wno-sign-compare -Wno-tautological-compare -Wno-uninitialized -Wno-unused-but-set-parameter -Wno-unused-but-set-variable -Wno-unused-parameter -Wno-unused-variable    -std=c++14   -include Vtb_top__pch.h.slow -c -o Vtb_top___024root__DepSet_h7f86b803__0__Slow.o Vtb_top___024root__DepSet_h7f86b803__0__Slow.cpp
ccache g++   -I.  -MMD -I/usr/local/share/verilator/include -I/usr/local/share/verilator/include/vltstd -DVM_COVERAGE=0-DVM_SC=0 -DVM_TIMING=0 -DVM_TRACE=0 -DVM_TRACE_FST=0 -DVM_TRACE_VCD=0 -faligned-new -fcf-protection=none -Wno-bool-operation -Wno-shadow -Wno-sign-compare -Wno-tautological-compare -Wno-uninitialized -Wno-unused-but-set-parameter -Wno-unused-but-set-variable -Wno-unused-parameter -Wno-unused-variable    -std=c++14   -include Vtb_top__pch.h.slow -c -o Vtb_top___024root__DepSet_h9ad02603__0__Slow.o Vtb_top___024root__DepSet_h9ad02603__0__Slow.cpp
ccache g++   -I.  -MMD -I/usr/local/share/verilator/include -I/usr/local/share/verilator/include/vltstd -DVM_COVERAGE=0-DVM_SC=0 -DVM_TIMING=0 -DVM_TRACE=0 -DVM_TRACE_FST=0 -DVM_TRACE_VCD=0 -faligned-new -fcf-protection=none -Wno-bool-operation -Wno-shadow -Wno-sign-compare -Wno-tautological-compare -Wno-uninitialized -Wno-unused-but-set-parameter -Wno-unused-but-set-variable -Wno-unused-parameter -Wno-unused-variable    -std=c++14   -include Vtb_top__pch.h.slow -c -o Vtb_top___024root__DepSet_h9ad02603__1__Slow.o Vtb_top___024root__DepSet_h9ad02603__1__Slow.cpp
ccache g++   -I.  -MMD -I/usr/local/share/verilator/include -I/usr/local/share/verilator/include/vltstd -DVM_COVERAGE=0-DVM_SC=0 -DVM_TIMING=0 -DVM_TRACE=0 -DVM_TRACE_FST=0 -DVM_TRACE_VCD=0 -faligned-new -fcf-protection=none -Wno-bool-operation -Wno-shadow -Wno-sign-compare -Wno-tautological-compare -Wno-uninitialized -Wno-unused-but-set-parameter -Wno-unused-but-set-variable -Wno-unused-parameter -Wno-unused-variable    -std=c++14   -include Vtb_top__pch.h.slow -c -o Vtb_top___024root__DepSet_h9ad02603__2__Slow.o Vtb_top___024root__DepSet_h9ad02603__2__Slow.cpp
ccache g++   -I.  -MMD -I/usr/local/share/verilator/include -I/usr/local/share/verilator/include/vltstd -DVM_COVERAGE=0-DVM_SC=0 -DVM_TIMING=0 -DVM_TRACE=0 -DVM_TRACE_FST=0 -DVM_TRACE_VCD=0 -faligned-new -fcf-protection=none -Wno-bool-operation -Wno-shadow -Wno-sign-compare -Wno-tautological-compare -Wno-uninitialized -Wno-unused-but-set-parameter -Wno-unused-but-set-variable -Wno-unused-parameter -Wno-unused-variable    -std=c++14   -include Vtb_top__pch.h.slow -c -o Vtb_top___024root__DepSet_h9ad02603__3__Slow.o Vtb_top___024root__DepSet_h9ad02603__3__Slow.cpp
ccache g++   -I.  -MMD -I/usr/local/share/verilator/include -I/usr/local/share/verilator/include/vltstd -DVM_COVERAGE=0-DVM_SC=0 -DVM_TIMING=0 -DVM_TRACE=0 -DVM_TRACE_FST=0 -DVM_TRACE_VCD=0 -faligned-new -fcf-protection=none -Wno-bool-operation -Wno-shadow -Wno-sign-compare -Wno-tautological-compare -Wno-uninitialized -Wno-unused-but-set-parameter -Wno-unused-but-set-variable -Wno-unused-parameter -Wno-unused-variable    -std=c++14   -include Vtb_top__pch.h.slow -c -o Vtb_top___024root__DepSet_h9ad02603__4__Slow.o Vtb_top___024root__DepSet_h9ad02603__4__Slow.cpp
ccache g++   -I.  -MMD -I/usr/local/share/verilator/include -I/usr/local/share/verilator/include/vltstd -DVM_COVERAGE=0-DVM_SC=0 -DVM_TIMING=0 -DVM_TRACE=0 -DVM_TRACE_FST=0 -DVM_TRACE_VCD=0 -faligned-new -fcf-protection=none -Wno-bool-operation -Wno-shadow -Wno-sign-compare -Wno-tautological-compare -Wno-uninitialized -Wno-unused-but-set-parameter -Wno-unused-but-set-variable -Wno-unused-parameter -Wno-unused-variable    -std=c++14   -include Vtb_top__pch.h.slow -c -o Vtb_top___024root__DepSet_h9ad02603__5__Slow.o Vtb_top___024root__DepSet_h9ad02603__5__Slow.cpp
ccache g++   -I.  -MMD -I/usr/local/share/verilator/include -I/usr/local/share/verilator/include/vltstd -DVM_COVERAGE=0-DVM_SC=0 -DVM_TIMING=0 -DVM_TRACE=0 -DVM_TRACE_FST=0 -DVM_TRACE_VCD=0 -faligned-new -fcf-protection=none -Wno-bool-operation -Wno-shadow -Wno-sign-compare -Wno-tautological-compare -Wno-uninitialized -Wno-unused-but-set-parameter -Wno-unused-but-set-variable -Wno-unused-parameter -Wno-unused-variable    -std=c++14   -include Vtb_top__pch.h.slow -c -o Vtb_top___024root__DepSet_h9ad02603__6__Slow.o Vtb_top___024root__DepSet_h9ad02603__6__Slow.cpp
ccache g++   -I.  -MMD -I/usr/local/share/verilator/include -I/usr/local/share/verilator/include/vltstd -DVM_COVERAGE=0-DVM_SC=0 -DVM_TIMING=0 -DVM_TRACE=0 -DVM_TRACE_FST=0 -DVM_TRACE_VCD=0 -faligned-new -fcf-protection=none -Wno-bool-operation -Wno-shadow -Wno-sign-compare -Wno-tautological-compare -Wno-uninitialized -Wno-unused-but-set-parameter -Wno-unused-but-set-variable -Wno-unused-parameter -Wno-unused-variable    -std=c++14   -include Vtb_top__pch.h.slow -c -o Vtb_top___024unit__Slow.o Vtb_top___024unit__Slow.cpp
ccache g++   -I.  -MMD -I/usr/local/share/verilator/include -I/usr/local/share/verilator/include/vltstd -DVM_COVERAGE=0-DVM_SC=0 -DVM_TIMING=0 -DVM_TRACE=0 -DVM_TRACE_FST=0 -DVM_TRACE_VCD=0 -faligned-new -fcf-protection=none -Wno-bool-operation -Wno-shadow -Wno-sign-compare -Wno-tautological-compare -Wno-uninitialized -Wno-unused-but-set-parameter -Wno-unused-but-set-variable -Wno-unused-parameter -Wno-unused-variable    -std=c++14   -include Vtb_top__pch.h.slow -c -o Vtb_top___024unit__DepSet_hba4cee98__0__Slow.o Vtb_top___024unit__DepSet_hba4cee98__0__Slow.cpp
ccache g++   -I.  -MMD -I/usr/local/share/verilator/include -I/usr/local/share/verilator/include/vltstd -DVM_COVERAGE=0-DVM_SC=0 -DVM_TIMING=0 -DVM_TRACE=0 -DVM_TRACE_FST=0 -DVM_TRACE_VCD=0 -faligned-new -fcf-protection=none -Wno-bool-operation -Wno-shadow -Wno-sign-compare -Wno-tautological-compare -Wno-uninitialized -Wno-unused-but-set-parameter -Wno-unused-but-set-variable -Wno-unused-parameter -Wno-unused-variable    -std=c++14   -include Vtb_top__pch.h.slow -c -o Vtb_top__Syms.o Vtb_top__Syms.cpp
ccache g++ -Os  -I.  -MMD -I/usr/local/share/verilator/include -I/usr/local/share/verilator/include/vltstd -DVM_COVERAGE=0 -DVM_SC=0 -DVM_TIMING=0 -DVM_TRACE=0 -DVM_TRACE_FST=0 -DVM_TRACE_VCD=0 -faligned-new -fcf-protection=none -Wno-bool-operation -Wno-shadow -Wno-sign-compare -Wno-tautological-compare -Wno-uninitialized -Wno-unused-but-set-parameter -Wno-unused-but-set-variable -Wno-unused-parameter -Wno-unused-variable    -std=c++14   -include Vtb_top__pch.h.fast -c -o Vtb_top.o Vtb_top.cpp
ccache g++ -Os  -I.  -MMD -I/usr/local/share/verilator/include -I/usr/local/share/verilator/include/vltstd -DVM_COVERAGE=0 -DVM_SC=0 -DVM_TIMING=0 -DVM_TRACE=0 -DVM_TRACE_FST=0 -DVM_TRACE_VCD=0 -faligned-new -fcf-protection=none -Wno-bool-operation -Wno-shadow -Wno-sign-compare -Wno-tautological-compare -Wno-uninitialized -Wno-unused-but-set-parameter -Wno-unused-but-set-variable -Wno-unused-parameter -Wno-unused-variable    -std=c++14   -include Vtb_top__pch.h.fast -c -o Vtb_top___024root__DepSet_h7f86b803__0.o Vtb_top___024root__DepSet_h7f86b803__0.cpp
ccache g++ -Os  -I.  -MMD -I/usr/local/share/verilator/include -I/usr/local/share/verilator/include/vltstd -DVM_COVERAGE=0 -DVM_SC=0 -DVM_TIMING=0 -DVM_TRACE=0 -DVM_TRACE_FST=0 -DVM_TRACE_VCD=0 -faligned-new -fcf-protection=none -Wno-bool-operation -Wno-shadow -Wno-sign-compare -Wno-tautological-compare -Wno-uninitialized -Wno-unused-but-set-parameter -Wno-unused-but-set-variable -Wno-unused-parameter -Wno-unused-variable    -std=c++14   -include Vtb_top__pch.h.fast -c -o Vtb_top___024root__DepSet_h9ad02603__0.o Vtb_top___024root__DepSet_h9ad02603__0.cpp
ccache g++ -Os  -I.  -MMD -I/usr/local/share/verilator/include -I/usr/local/share/verilator/include/vltstd -DVM_COVERAGE=0 -DVM_SC=0 -DVM_TIMING=0 -DVM_TRACE=0 -DVM_TRACE_FST=0 -DVM_TRACE_VCD=0 -faligned-new -fcf-protection=none -Wno-bool-operation -Wno-shadow -Wno-sign-compare -Wno-tautological-compare -Wno-uninitialized -Wno-unused-but-set-parameter -Wno-unused-but-set-variable -Wno-unused-parameter -Wno-unused-variable    -std=c++14   -include Vtb_top__pch.h.fast -c -o Vtb_top___024root__DepSet_h9ad02603__1.o Vtb_top___024root__DepSet_h9ad02603__1.cpp
ccache g++ -Os  -I.  -MMD -I/usr/local/share/verilator/include -I/usr/local/share/verilator/include/vltstd -DVM_COVERAGE=0 -DVM_SC=0 -DVM_TIMING=0 -DVM_TRACE=0 -DVM_TRACE_FST=0 -DVM_TRACE_VCD=0 -faligned-new -fcf-protection=none -Wno-bool-operation -Wno-shadow -Wno-sign-compare -Wno-tautological-compare -Wno-uninitialized -Wno-unused-but-set-parameter -Wno-unused-but-set-variable -Wno-unused-parameter -Wno-unused-variable    -std=c++14   -include Vtb_top__pch.h.fast -c -o Vtb_top___024root__DepSet_h9ad02603__2.o Vtb_top___024root__DepSet_h9ad02603__2.cpp
ccache g++ -Os  -I.  -MMD -I/usr/local/share/verilator/include -I/usr/local/share/verilator/include/vltstd -DVM_COVERAGE=0 -DVM_SC=0 -DVM_TIMING=0 -DVM_TRACE=0 -DVM_TRACE_FST=0 -DVM_TRACE_VCD=0 -faligned-new -fcf-protection=none -Wno-bool-operation -Wno-shadow -Wno-sign-compare -Wno-tautological-compare -Wno-uninitialized -Wno-unused-but-set-parameter -Wno-unused-but-set-variable -Wno-unused-parameter -Wno-unused-variable    -std=c++14   -include Vtb_top__pch.h.fast -c -o Vtb_top___024root__DepSet_h9ad02603__3.o Vtb_top___024root__DepSet_h9ad02603__3.cpp
ccache g++ -Os  -I.  -MMD -I/usr/local/share/verilator/include -I/usr/local/share/verilator/include/vltstd -DVM_COVERAGE=0 -DVM_SC=0 -DVM_TIMING=0 -DVM_TRACE=0 -DVM_TRACE_FST=0 -DVM_TRACE_VCD=0 -faligned-new -fcf-protection=none -Wno-bool-operation -Wno-shadow -Wno-sign-compare -Wno-tautological-compare -Wno-uninitialized -Wno-unused-but-set-parameter -Wno-unused-but-set-variable -Wno-unused-parameter -Wno-unused-variable    -std=c++14   -include Vtb_top__pch.h.fast -c -o Vtb_top___024root__DepSet_h9ad02603__4.o Vtb_top___024root__DepSet_h9ad02603__4.cpp
ccache g++ -Os  -I.  -MMD -I/usr/local/share/verilator/include -I/usr/local/share/verilator/include/vltstd -DVM_COVERAGE=0 -DVM_SC=0 -DVM_TIMING=0 -DVM_TRACE=0 -DVM_TRACE_FST=0 -DVM_TRACE_VCD=0 -faligned-new -fcf-protection=none -Wno-bool-operation -Wno-shadow -Wno-sign-compare -Wno-tautological-compare -Wno-uninitialized -Wno-unused-but-set-parameter -Wno-unused-but-set-variable -Wno-unused-parameter -Wno-unused-variable    -std=c++14   -include Vtb_top__pch.h.fast -c -o Vtb_top___024root__DepSet_h9ad02603__5.o Vtb_top___024root__DepSet_h9ad02603__5.cpp
ccache g++ -Os  -I.  -MMD -I/usr/local/share/verilator/include -I/usr/local/share/verilator/include/vltstd -DVM_COVERAGE=0 -DVM_SC=0 -DVM_TIMING=0 -DVM_TRACE=0 -DVM_TRACE_FST=0 -DVM_TRACE_VCD=0 -faligned-new -fcf-protection=none -Wno-bool-operation -Wno-shadow -Wno-sign-compare -Wno-tautological-compare -Wno-uninitialized -Wno-unused-but-set-parameter -Wno-unused-but-set-variable -Wno-unused-parameter -Wno-unused-variable    -std=c++14   -include Vtb_top__pch.h.fast -c -o Vtb_top___024root__DepSet_h9ad02603__6.o Vtb_top___024root__DepSet_h9ad02603__6.cpp
g++    test_tb_top.o verilated.o verilated_threads.o Vtb_top__ALL.a    -pthread -lpthread -latomic   -o Vtb_top
rm Vtb_top__ALL.verilator_deplist.tmp
make[1]: 离开目录“/home/wjy1/桌面/Cores-VeeR-EH1/obj_dir”
touch verilator-build
./obj_dir/Vtb_top

VerilatorTB: Start of sim

Hit max cycle count (10000000) .. stopping
- /home/wjy1/桌面/Cores-VeeR-EH1/testbench/tb_top.sv:332: Verilog $finish

VerilatorTB: End of sim

```

zhishuohuang9111, 2025-03-25:
Have you done your problems?

noobwei, 2025-03-26:
> Have you done your problems?

Not solved yet
I posted this issue for my colleague, and this problem did not occur on my own machine.
She may not be following up now, so it may not be reproducible

zhishuohuang9111, 2025-03-26:
Sometimes when I changed the codes and run coremarks, I also meet this problems: Hit max cycle count (10000000) .. stopping

Thread 130 (2025-03-25):

minstret and mcycle

zhishuohuang9111, 2025-03-25:
I changed the codes and testbench can run correctly, but minstret and mcycle are not the same with the original codes printed.
 minstret and mcycle must be the same?
