chipsalliance/Cores-VeeR-EH1/design/dec/dec_tlu_ctl.sv

// SPDX-License-Identifier: Apache-2.0
// Copyright 2019 Western Digital Corporation or its affiliates.
//
// Licensed under the Apache License, Version 2.0 (the "License");
// you may not use this file except in compliance with the License.
// You may obtain a copy of the License at
//
// http://www.apache.org/licenses/LICENSE-2.0
//
// Unless required by applicable law or agreed to in writing, software
// distributed under the License is distributed on an "AS IS" BASIS,
// WITHOUT WARRANTIES OR CONDITIONS OF ANY KIND, either express or implied.
// See the License for the specific language governing permissions and
// limitations under the License.


//********************************************************************************
// dec_tlu_ctl.sv
//
//
// Function: CSRs, Commit/WB, flushing, exceptions, interrupts
// Comments:
//
//********************************************************************************

module dec_tlu_ctl
   import veer_types::*;
(
   input logic clk,
   input logic active_clk,
   input logic free_clk,
   input logic rst_l,
   input logic scan_mode,

   input logic [31:1] rst_vec, // reset vector, from core pins
   input logic        nmi_int, // nmi pin
   input logic [31:1] nmi_vec, // nmi vector
   input logic  i_cpu_halt_req,    // Asynchronous Halt request to CPU
   input logic  i_cpu_run_req,     // Asynchronous Restart request to CPU

   input logic mpc_debug_halt_req, // Async halt request
   input logic mpc_debug_run_req, // Async run request
   input logic mpc_reset_run_req, // Run/halt after reset

   // perf counter inputs
   input logic [1:0] ifu_pmu_instr_aligned,   // aligned instructions
   input logic       ifu_pmu_align_stall,  // aligner stalled
   input logic       ifu_pmu_fetch_stall, // fetch unit stalled
   input logic       ifu_pmu_ic_miss, // icache miss
   input logic       ifu_pmu_ic_hit, // icache hit
   input logic       ifu_pmu_bus_error, // Instruction side bus error
   input logic       ifu_pmu_bus_busy, // Instruction side bus busy
   input logic       ifu_pmu_bus_trxn, // Instruction side bus transaction
   input logic [1:0] dec_pmu_instr_decoded, // decoded instructions
   input logic       dec_pmu_decode_stall, // decode stall
   input logic       dec_pmu_presync_stall, // decode stall due to presync'd inst
   input logic       dec_pmu_postsync_stall,// decode stall due to postsync'd inst
   input logic       lsu_freeze_dc3,         // lsu freeze stall
   input logic       lsu_store_stall_any,    // SB or WB is full, stall decode
   input logic       dma_dccm_stall_any,     // DMA stall of lsu
   input logic       dma_iccm_stall_any,     // DMA stall of ifu
   input logic       exu_pmu_i0_br_misp,     // pipe 0 branch misp
   input logic       exu_pmu_i0_br_ataken,   // pipe 0 branch actual taken
   input logic       exu_pmu_i0_pc4,         // pipe 0 4 byte branch
   input logic       exu_pmu_i1_br_misp,     // pipe 1 branch misp
   input logic       exu_pmu_i1_br_ataken,   // pipe 1 branch actual taken
   input logic       exu_pmu_i1_pc4,         // pipe 1 4 byte branch
   input logic       lsu_pmu_bus_trxn,       // D side bus transaction
   input logic       lsu_pmu_bus_misaligned, // D side bus misaligned
   input logic       lsu_pmu_bus_error,      // D side bus error
   input logic       lsu_pmu_bus_busy,       // D side bus busy

   input logic        dma_mem_dccm_req,

   input logic       iccm_dma_sb_error,      // I side dma single bit error

   input    lsu_error_pkt_t lsu_error_pkt_dc3, // lsu precise exception/error packet
   input logic         lsu_single_ecc_error_incr,    // Increment the counter for Single ECC error

   input logic lsu_load_ecc_stbuf_full_dc3,    // STBUF full, ecc errors should be rfpc'd

   input logic dec_pause_state, // Pause counter not zero
   input logic         lsu_imprecise_error_store_any,      // store bus error
   input logic         lsu_imprecise_error_load_any,      // store bus error
   input logic [31:0]  lsu_imprecise_error_addr_any, // store bus error address
   input logic         lsu_freeze_external_ints_dc3, // load to side effect region

   input logic        dec_csr_wen_unq_d,       // valid csr with write - for csr legal
   input logic        dec_csr_any_unq_d,       // valid csr - for csr legal
   input logic        dec_csr_wen_wb,      // csr write enable at wb
   input logic [11:0] dec_csr_rdaddr_d,      // read address for csr
   input logic [11:0] dec_csr_wraddr_wb,      // write address for csr
   input logic [31:0] dec_csr_wrdata_wb,   // csr write data at wb
   input logic        dec_csr_stall_int_ff, // csr is mie/mstatus

   input logic dec_tlu_i0_valid_e4, // pipe 0 op at e4 is valid
   input logic dec_tlu_i1_valid_e4, // pipe 1 op at e4 is valid

   input logic dec_i0_load_e4, // during cycle after freeze asserts, load is in i0

   input logic dec_fence_pending, // tell TLU to stall DMA

   input logic [31:1] exu_npc_e4, // for NPC tracking
   input logic exu_i0_flush_lower_e4,       // pipe 0 branch mp flush
   input logic exu_i1_flush_lower_e4,       // pipe 1 branch mp flush
   input logic [31:1] exu_i0_flush_path_e4, // pipe 0 correct path for mp, merge with lower path
   input logic [31:1] exu_i1_flush_path_e4, // pipe 1 correct path for mp, merge with lower path

   input logic [31:1] dec_tlu_i0_pc_e4, // for PC/NPC tracking
   input logic [31:1] dec_tlu_i1_pc_e4, // for PC/NPC tracking

   input trap_pkt_t dec_tlu_packet_e4, // exceptions known at decode

   input logic [31:0] dec_illegal_inst, // For mtval
   input logic        dec_i0_decode_d,  // decode valid, used for clean icache diagnostics

   // branch info from pipe0 for errors or counter updates
   input logic [`RV_BTB_ADDR_HI:`RV_BTB_ADDR_LO] exu_i0_br_index_e4, // index
   input logic [1:0]  exu_i0_br_hist_e4, // history
   input logic [1:0]  exu_i0_br_bank_e4, // bank
   input logic        exu_i0_br_error_e4, // error
   input logic        exu_i0_br_start_error_e4, // start error
   input logic        exu_i0_br_valid_e4, // valid
   input logic        exu_i0_br_mp_e4, // mispredict
   input logic        exu_i0_br_middle_e4, // middle of bank
   input logic [`RV_BHT_GHR_RANGE]  exu_i0_br_fghr_e4, // FGHR when predicted

   // branch info from pipe1 for errors or counter updates
   input logic [`RV_BTB_ADDR_HI:`RV_BTB_ADDR_LO] exu_i1_br_index_e4, // index
   input logic [1:0]  exu_i1_br_hist_e4, // history
   input logic [1:0]  exu_i1_br_bank_e4, // bank
   input logic        exu_i1_br_error_e4, // error
   input logic        exu_i1_br_start_error_e4, // start error
   input logic        exu_i1_br_valid_e4, // valid
   input logic        exu_i1_br_mp_e4, // mispredict
   input logic        exu_i1_br_middle_e4, // middle of bank
   input logic [`RV_BHT_GHR_RANGE]  exu_i1_br_fghr_e4, // FGHR when predicted

`ifdef RV_BTB_48
   input logic [1:0]       exu_i1_br_way_e4, // way hit or repl
   input logic [1:0]       exu_i0_br_way_e4, // way hit or repl
`else
   input logic        exu_i1_br_way_e4, // way hit or repl
   input logic        exu_i0_br_way_e4, // way hit or repl
`endif

   // Debug start
   output logic dec_dbg_cmd_done, // abstract command done
   output logic dec_dbg_cmd_fail, // abstract command failed
   output logic dec_tlu_flush_noredir_wb , // Tell fetch to idle on this flush
   output logic dec_tlu_mpc_halted_only, // Core is halted only due to MPC
   output logic dec_tlu_dbg_halted, // Core is halted and ready for debug command
   output logic dec_tlu_pmu_fw_halted, // Core is halted due to Power management unit or firmware halt
   output logic dec_tlu_debug_mode, // Core is in debug mode
   output logic dec_tlu_resume_ack, // Resume acknowledge
   output logic dec_tlu_debug_stall, // stall decode while waiting on core to empty
   output logic dec_tlu_flush_leak_one_wb, // single step
   output logic dec_tlu_flush_err_wb, // iside perr/ecc rfpc
   output logic dec_tlu_stall_dma, // stall dma access when there's a halt request
   input  logic dbg_halt_req, // DM requests a halt
   input  logic dbg_resume_req, // DM requests a resume
   input  logic ifu_miss_state_idle, // I-side miss buffer empty
   input  logic lsu_halt_idle_any, // lsu is idle
   output trigger_pkt_t  [3:0] trigger_pkt_any, // trigger info for trigger blocks

`ifdef RV_ICACHE_ECC
   input logic [41:0] ifu_ic_debug_rd_data, // diagnostic icache read data
`else
   input logic [33:0] ifu_ic_debug_rd_data, // diagnostic icache read data
`endif
   input logic ifu_ic_debug_rd_data_valid, // diagnostic icache read data valid
   output cache_debug_pkt_t dec_tlu_ic_diag_pkt, // packet of DICAWICS, DICAD0/1, DICAGO info for icache diagnostics
   // Debug end

   input logic [7:0] pic_claimid, // pic claimid for csr
   input logic [3:0] pic_pl, // pic priv level for csr
   input logic       mhwakeup, // high priority external int, wakeup if halted

   input logic mexintpend, // external interrupt pending
   input logic timer_int, // timer interrupt pending

   output logic o_cpu_halt_status, // PMU interface, halted
   output logic o_cpu_halt_ack, // halt req ack
   output logic o_cpu_run_ack, // run req ack
   output logic o_debug_mode_status, // Core to the PMU that core is in debug mode. When core is in debug mode, the PMU should refrain from sendng a halt or run request

   output logic mpc_debug_halt_ack, // Halt ack
   output logic mpc_debug_run_ack, // Run ack
   output logic debug_brkpt_status, // debug breakpoint

   output logic [3:0] dec_tlu_meicurpl, // to PIC
   output logic [3:0] dec_tlu_meipt, // to PIC

   output br_tlu_pkt_t dec_tlu_br0_wb_pkt, // branch pkt to bp
   output br_tlu_pkt_t dec_tlu_br1_wb_pkt, // branch pkt to bp

   output logic [31:0] dec_csr_rddata_d,      // csr read data at wb
   output logic dec_csr_legal_d,              // csr indicates legal operation

   output logic dec_tlu_i0_kill_writeb_wb,    // I0 is flushed, don't writeback any results to arch state
   output logic dec_tlu_i1_kill_writeb_wb,    // I1 is flushed, don't writeback any results to arch state

   output logic dec_tlu_flush_lower_wb,       // commit has a flush (exception, int, mispredict at e4)
   output logic [31:1] dec_tlu_flush_path_wb, // flush pc
   output logic dec_tlu_fence_i_wb,           // flush is a fence_i rfnpc, flush icache

   output logic dec_tlu_presync_d,            // CSR read needs to be presync'd
   output logic dec_tlu_postsync_d,           // CSR needs to be presync'd

   output logic [31:0] dec_tlu_mrac_ff,        // CSR for memory region control

   output logic dec_tlu_cancel_e4,             // Cancel lsu op at DC4 due to future trigger hit

   output logic dec_tlu_wr_pause_wb,           // CSR write to pause reg is at WB.
   output logic dec_tlu_flush_pause_wb,        // Flush is due to pause

   output logic [1:0] dec_tlu_perfcnt0, // toggles when pipe0 perf counter 0 has an event inc
   output logic [1:0] dec_tlu_perfcnt1, // toggles when pipe0 perf counter 1 has an event inc
   output logic [1:0] dec_tlu_perfcnt2, // toggles when pipe0 perf counter 2 has an event inc
   output logic [1:0] dec_tlu_perfcnt3, // toggles when pipe0 perf counter 3 has an event inc


   output logic dec_tlu_i0_valid_wb1,  // pipe 0 valid
   output logic dec_tlu_i1_valid_wb1,  // pipe 1 valid
   output logic dec_tlu_i0_exc_valid_wb1, // pipe 0 exception valid
   output logic dec_tlu_i1_exc_valid_wb1, // pipe 1 exception valid
   output logic dec_tlu_int_valid_wb1, // pipe 2 int valid
   output logic [4:0] dec_tlu_exc_cause_wb1, // exception or int cause
   output logic [31:0] dec_tlu_mtval_wb1, // MTVAL value

   // feature disable from mfdc
   output logic  dec_tlu_sideeffect_posted_disable,    // disable posted writes to side-effect address
   output logic  dec_tlu_dual_issue_disable, // disable dual issue
   output logic  dec_tlu_core_ecc_disable, // disable core ECC
   output logic  dec_tlu_sec_alu_disable, // disable secondary ALU
   output logic  dec_tlu_dccm_nonblock_dma_disable, // disable dma nonblock
   output logic  dec_tlu_non_blocking_disable,    // disable non blocking loads
   output logic  dec_tlu_fast_div_disable,        // disable fast divider
   output logic  dec_tlu_bpred_disable,           // disable branch prediction
   output logic  dec_tlu_wb_coalescing_disable,   // disable writebuffer coalescing
   output logic  dec_tlu_ld_miss_byp_wb_disable,  // disable loads miss bypass write buffer
   output logic  dec_tlu_pipelining_disable,      // disable pipelining
   output logic [2:0]  dec_tlu_dma_qos_prty,    // DMA QoS priority coming from MFDC [18:16]

   // clock gating overrides from mcgc
   output logic  dec_tlu_misc_clk_override, // override misc clock domain gating
   output logic  dec_tlu_dec_clk_override,  // override decode clock domain gating
   output logic  dec_tlu_exu_clk_override,  // override exu clock domain gating
   output logic  dec_tlu_ifu_clk_override,  // override fetch clock domain gating
   output logic  dec_tlu_lsu_clk_override,  // override load/store clock domain gating
   output logic  dec_tlu_bus_clk_override,  // override bus clock domain gating
   output logic  dec_tlu_pic_clk_override,  // override PIC clock domain gating
   output logic  dec_tlu_dccm_clk_override, // override DCCM clock domain gating
   output logic  dec_tlu_icm_clk_override   // override ICCM clock domain gating

   );

   logic         dec_csr_wen_wb_mod, clk_override, e4e5_int_clk, nmi_lsu_load_type, nmi_lsu_store_type, nmi_int_detected_f, nmi_lsu_load_type_f,
                 nmi_lsu_store_type_f, allow_dbg_halt_csr_write, dbg_cmd_done_ns, i_cpu_run_req_d1_raw, debug_mode_status, lsu_single_ecc_error_wb,
                 i0_mp_e4, i1_mp_e4, sel_npc_e4, sel_npc_wb, ce_int, mtval_capture_lsu_wb, wr_mdeau_wb, micect_cout_nc, miccmect_cout_nc,
                 mdccmect_cout_nc, nmi_in_debug_mode, dpc_capture_npc, dpc_capture_pc, tdata_load, tdata_opcode, tdata_action, perfcnt_halted, tdata_chain,
                 tdata_kill_write;


   logic reset_delayed, reset_detect, reset_detected;
   logic wr_mstatus_wb, wr_mtvec_wb, wr_mie_wb, wr_mcyclel_wb, wr_mcycleh_wb,
         wr_minstretl_wb, wr_minstreth_wb, wr_mscratch_wb, wr_mepc_wb, wr_mcause_wb, wr_mtval_wb,
         wr_mrac_wb, wr_meihap_wb, wr_meicurpl_wb, wr_meipt_wb, wr_dcsr_wb,
         wr_dpc_wb, wr_meicidpl_wb, wr_meivt_wb, wr_meicpct_wb, wr_micect_wb, wr_miccmect_wb,
         wr_mdccmect_wb,wr_mhpme3_wb, wr_mhpme4_wb, wr_mhpme5_wb, wr_mhpme6_wb;
   logic wr_mgpmc_wb, mgpmc_b, mgpmc;
   logic wr_mtsel_wb, wr_mtdata1_t0_wb, wr_mtdata1_t1_wb, wr_mtdata1_t2_wb, wr_mtdata1_t3_wb, wr_mtdata2_t0_wb, wr_mtdata2_t1_wb, wr_mtdata2_t2_wb, wr_mtdata2_t3_wb;
   logic [31:0] mtdata2_t0, mtdata2_t1, mtdata2_t2, mtdata2_t3, mtdata2_tsel_out, mtdata1_tsel_out;
   logic [9:0]  mtdata1_t0_ns, mtdata1_t0, mtdata1_t1_ns, mtdata1_t1, mtdata1_t2_ns, mtdata1_t2, mtdata1_t3_ns, mtdata1_t3;
   logic [27:0] tdata_wrdata_wb;
   logic [1:0] mtsel_ns, mtsel;
   logic tlu_i0_kill_writeb_e4, tlu_i1_kill_writeb_e4;
   logic [1:0]  mstatus_ns, mstatus;
   logic mstatus_mie_ns;
   logic [30:0] mtvec_ns, mtvec;
   logic [15:2] dcsr_ns, dcsr;
   logic [5:0] mip_ns, mip;
   logic [5:0] mie_ns, mie;
   logic [31:0] mcyclel_ns, mcyclel;
   logic [31:0] mcycleh_ns, mcycleh;
   logic [31:0] minstretl_ns, minstretl;
   logic [31:0] minstreth_ns, minstreth;
   logic [31:0] micect_ns, micect, miccmect_ns, miccmect, mdccmect_ns, mdccmect;
   logic [26:0] micect_inc, miccmect_inc, mdccmect_inc;
   logic [31:0] mscratch;
   logic [31:0] mhpmc3, mhpmc3_ns, mhpmc4, mhpmc4_ns, mhpmc5, mhpmc5_ns, mhpmc6, mhpmc6_ns;
   logic [31:0] mhpmc3h, mhpmc3h_ns, mhpmc4h, mhpmc4h_ns, mhpmc5h, mhpmc5h_ns, mhpmc6h, mhpmc6h_ns;
   logic [5:0]  mhpme3, mhpme4, mhpme5, mhpme6;
   logic [31:0] mrac;
   logic [9:2] meihap;
   logic [31:10] meivt;
   logic [3:0] meicurpl_ns, meicurpl;
   logic [3:0] meicidpl_ns, meicidpl;
   logic [3:0] meipt_ns, meipt;
   logic [31:0] mdseac;
   logic mdseac_locked_ns, mdseac_locked_f, mdseac_en, nmi_lsu_detected;
   logic [31:1] mepc_ns, mepc;
   logic [31:1] dpc_ns, dpc;
   logic [31:0] mcause_ns, mcause;
   logic [31:0] mtval_ns, mtval;
   logic       mret_wb;
   logic dec_pause_state_f, dec_tlu_wr_pause_wb_f, pause_expired_e4, pause_expired_wb;
   logic       tlu_flush_lower_e4, tlu_flush_lower_wb;
   logic [31:1] tlu_flush_path_e4, tlu_flush_path_wb;
   logic i0_valid_wb, i1_valid_wb;
   logic [5:0] vectored_cause;
   logic       vpath_overflow_nc;
   logic [31:1] vectored_path, interrupt_path;
   logic [18:2] dicawics_ns, dicawics;
   logic        wr_dicawics_wb, wr_dicad0_wb, wr_dicad1_wb;
   logic [31:0] dicad0_ns, dicad0;
`ifdef RV_ICACHE_ECC
   logic [9:0]  dicad1_ns, dicad1;
 `else
   logic [1:0]  dicad1_ns, dicad1;
 `endif
   logic        ebreak_e4, ebreak_to_debug_mode_e4, ecall_e4, illegal_e4, illegal_e4_qual, mret_e4, inst_acc_e4, fence_i_e4,
                ic_perr_e4, iccm_sbecc_e4, ebreak_to_debug_mode_wb, kill_ebreak_count_wb, inst_acc_second_e4;
   logic        ebreak_wb, ecall_wb, illegal_wb,  illegal_raw_wb, inst_acc_wb, inst_acc_second_wb, fence_i_wb, ic_perr_wb, iccm_sbecc_wb;
   logic ce_int_ready, ext_int_ready, timer_int_ready, int_timer0_int_ready, int_timer1_int_ready, mhwakeup_ready,
         take_ext_int, take_ce_int, take_timer_int, take_int_timer0_int, take_int_timer1_int, take_nmi, take_nmi_wb, int_timer0_int_possible, int_timer1_int_possible;
   logic i0_exception_valid_e4, interrupt_valid, i0_exception_valid_wb, interrupt_valid_wb, exc_or_int_valid, exc_or_int_valid_wb, mdccme_ce_req, miccme_ce_req, mice_ce_req;
   logic synchronous_flush_e4;
   logic [4:0] exc_cause_e4, exc_cause_wb;
   logic        mcyclel_cout, mcyclel_cout_f;
   logic [31:0] mcyclel_inc;
   logic        mcycleh_cout_nc;
   logic [31:0] mcycleh_inc;
   logic        minstretl_cout, minstretl_cout_f, minstret_enable;
   logic [31:0] minstretl_inc, minstretl_read;
   logic        minstreth_cout_nc;
   logic [31:0] minstreth_inc, minstreth_read;
   logic [31:1] pc_e4, pc_wb, npc_e4, npc_wb;
   logic        mtval_capture_pc_wb, mtval_capture_inst_wb, mtval_clear_wb, mtval_capture_pc_plus2_wb;
   logic valid_csr;
   logic [`RV_BTB_ADDR_HI:`RV_BTB_ADDR_LO] dec_tlu_br0_addr_e4, dec_tlu_br1_addr_e4;
   logic [1:0]  dec_tlu_br0_bank_e4, dec_tlu_br1_bank_e4;
   logic rfpc_i0_e4, rfpc_i1_e4;
   logic lsu_i0_rfnpc_dc4, lsu_i1_rfnpc_dc4;
   logic lsu_i0_rfpc_dc4, lsu_i1_rfpc_dc4;
   logic dec_tlu_br0_error_e4, dec_tlu_br0_start_error_e4, dec_tlu_br0_v_e4;
   logic dec_tlu_br1_error_e4, dec_tlu_br1_start_error_e4, dec_tlu_br1_v_e4;
   logic lsu_i0_exc_dc4, lsu_i1_exc_dc4, lsu_i0_exc_dc4_raw, lsu_i1_exc_dc4_raw, lsu_exc_ma_dc4, lsu_exc_acc_dc4, lsu_exc_st_dc4,
         lsu_exc_valid_e4, lsu_exc_valid_e4_raw, lsu_exc_valid_wb, lsu_i0_exc_wb,
         block_interrupts, lsu_block_interrupts_dc3, lsu_block_interrupts_e4, lsu_load_ecc_stbuf_full_dc4;
   logic tlu_i0_commit_cmt, tlu_i1_commit_cmt;
   logic i0_trigger_eval_e4, i1_trigger_eval_e4, lsu_freeze_e4, lsu_freeze_pulse_e3, lsu_freeze_pulse_e4;

   logic request_debug_mode_e4, request_debug_mode_wb, request_debug_mode_done, request_debug_mode_done_f;
   logic take_halt, take_halt_f, halt_taken, halt_taken_f, internal_dbg_halt_mode, dbg_tlu_halted_f, take_reset,
         dbg_tlu_halted, core_empty, lsu_halt_idle_any_f, ifu_miss_state_idle_f, resume_ack_ns,
          debug_halt_req_f, debug_resume_req_f_raw, debug_resume_req_f, enter_debug_halt_req, dcsr_single_step_done, dcsr_single_step_done_f,
          debug_halt_req_d1, debug_halt_req_ns, dcsr_single_step_running, dcsr_single_step_running_f, internal_dbg_halt_timers;

   logic [3:0] i0_trigger_e4, i1_trigger_e4, trigger_action, trigger_enabled,
               i0_trigger_chain_masked_e4, i1_trigger_chain_masked_e4;
   logic [2:0] trigger_chain;
   logic       i0_trigger_hit_e4, i0_trigger_hit_raw_e4, i0_trigger_action_e4,
               trigger_hit_e4, trigger_hit_wb, i0_trigger_hit_wb,
               mepc_trigger_hit_sel_pc_e4, i0_trigger_set_hit_e4, i1_trigger_set_hit_e4,
               mepc_trigger_hit_sel_pc_wb;
   logic       i1_trigger_hit_e4, i1_trigger_hit_raw_e4, i1_trigger_action_e4;
   logic [3:0] update_hit_bit_e4, update_hit_bit_wb, i0_iside_trigger_has_pri_e4, i1_iside_trigger_has_pri_e4,
               i0_lsu_trigger_has_pri_e4, i1_lsu_trigger_has_pri_e4;
   logic cpu_halt_status, cpu_halt_ack, cpu_run_ack, ext_halt_pulse, i_cpu_halt_req_d1, i_cpu_run_req_d1;

   logic inst_acc_e4_raw, trigger_hit_dmode_e4, trigger_hit_dmode_wb, trigger_hit_for_dscr_cause_wb;
   logic wr_mcgc_wb, wr_mfdc_wb;
   logic [8:0] mcgc;
   logic [18:0] mfdc;
   logic [14:0] mfdc_int, mfdc_ns;
   logic i_cpu_halt_req_sync_qual, i_cpu_run_req_sync_qual, pmu_fw_halt_req_ns, pmu_fw_halt_req_f, int_timer_stalled,
         fw_halt_req, enter_pmu_fw_halt_req, pmu_fw_tlu_halted, pmu_fw_tlu_halted_f, internal_pmu_fw_halt_mode,
         internal_pmu_fw_halt_mode_f, int_timer0_int_hold, int_timer1_int_hold, int_timer0_int_hold_f, int_timer1_int_hold_f;
   logic dcsr_single_step_running_ff;
   logic nmi_int_delayed, nmi_int_detected;
   logic [3:0] trigger_execute, trigger_data, trigger_store;
   logic mpc_run_state_ns, debug_brkpt_status_ns, mpc_debug_halt_ack_ns, mpc_debug_run_ack_ns, dbg_halt_state_ns, dbg_run_state_ns,
         dbg_halt_state_f, mpc_debug_halt_req_sync_f, mpc_debug_run_req_sync_f, mpc_halt_state_f, mpc_halt_state_ns, mpc_run_state_f, debug_brkpt_status_f,
         mpc_debug_halt_ack_f, mpc_debug_run_ack_f, dbg_run_state_f, dbg_halt_state_ff, mpc_debug_halt_req_sync_pulse,
         mpc_debug_run_req_sync_pulse, debug_brkpt_valid, debug_halt_req, debug_resume_req, dec_tlu_mpc_halted_only_ns;

   logic wr_mpmc_wb, set_mie_pmu_fw_halt;
   logic [1:1] mpmc_b_ns, mpmc, mpmc_b;

   // internal timer, isolated for size reasons
   logic [31:0] dec_timer_rddata_d;
   logic dec_timer_read_d, dec_timer_t0_pulse, dec_timer_t1_pulse;

   dec_timer_ctl int_timers(.*);
   // end of internal timers

   assign clk_override = dec_tlu_dec_clk_override;

   // Async inputs to the core have to be sync'd to the core clock.
   logic nmi_int_sync, timer_int_sync, i_cpu_halt_req_sync, i_cpu_run_req_sync, mpc_debug_halt_req_sync, mpc_debug_run_req_sync;
   rvsyncss #(6) syncro_ff(.*,
                           .clk(free_clk),
                           .din ({nmi_int,      timer_int,      i_cpu_halt_req,      i_cpu_run_req,      mpc_debug_halt_req,      mpc_debug_run_req}),
                           .dout({nmi_int_sync, timer_int_sync, i_cpu_halt_req_sync, i_cpu_run_req_sync, mpc_debug_halt_req_sync, mpc_debug_run_req_sync}));

   // for CSRs that have inpipe writes only

   logic csr_wr_clk;
   rvoclkhdr csrwr_wb_cgc ( .en(dec_csr_wen_wb_mod | clk_override), .l1clk(csr_wr_clk), .* );
   logic lsu_e3_e4_clk, lsu_e4_e5_clk;

   // LSU exceptions (LSU responsible for prioritizing simultaneous cases)
   lsu_error_pkt_t lsu_error_pkt_dc4;

   rvoclkhdr lsu_e3_e4_cgc ( .en(lsu_error_pkt_dc3.exc_valid | lsu_error_pkt_dc4.exc_valid | lsu_error_pkt_dc3.single_ecc_error | lsu_error_pkt_dc4.single_ecc_error | clk_override), .l1clk(lsu_e3_e4_clk), .* );
   rvoclkhdr lsu_e4_e5_cgc ( .en(lsu_error_pkt_dc4.exc_valid | lsu_exc_valid_wb | clk_override), .l1clk(lsu_e4_e5_clk), .* );

   logic freeze_rfpc_e4, rfpc_postsync_in, rfpc_postsync, dma_mem_dccm_req_f;

   logic e4e5_clk, e4_valid, e5_valid, e4e5_valid, internal_dbg_halt_mode_f, internal_dbg_halt_mode_f2, internal_dbg_halt_mode_f3;
   assign e4_valid = dec_tlu_i0_valid_e4 | dec_tlu_i1_valid_e4;
   assign e4e5_valid = e4_valid | e5_valid | freeze_rfpc_e4;
   rvoclkhdr e4e5_cgc ( .en(e4e5_valid | clk_override), .l1clk(e4e5_clk), .* );
   rvoclkhdr e4e5_int_cgc ( .en(e4e5_valid | internal_dbg_halt_mode_f | i_cpu_run_req_d1 | interrupt_valid | interrupt_valid_wb | reset_delayed | pause_expired_e4 | pause_expired_wb | clk_override), .l1clk(e4e5_int_clk), .* );


   assign lsu_freeze_pulse_e3 = lsu_freeze_dc3 & ~lsu_freeze_e4;
   rvdff #(10)  freeff (.*,   .clk(free_clk),
                        .din({internal_dbg_halt_mode_f2,internal_dbg_halt_mode_f, lsu_freeze_dc3, lsu_freeze_pulse_e3,
                              e4_valid, lsu_block_interrupts_dc3, internal_dbg_halt_mode, tlu_flush_lower_e4, tlu_i0_kill_writeb_e4, tlu_i1_kill_writeb_e4 }),
                        .dout({internal_dbg_halt_mode_f3, internal_dbg_halt_mode_f2, lsu_freeze_e4, lsu_freeze_pulse_e4,
                               e5_valid, lsu_block_interrupts_e4, internal_dbg_halt_mode_f, tlu_flush_lower_wb, dec_tlu_i0_kill_writeb_wb, dec_tlu_i1_kill_writeb_wb}));


   rvdff #(2) reset_ff (.*, .clk(free_clk), .din({1'b1, reset_detect}), .dout({reset_detect, reset_detected}));
   assign reset_delayed = reset_detect ^ reset_detected;

   rvdff #(4) nmi_ff (.*, .clk(free_clk), .din({nmi_int_sync, nmi_int_detected, nmi_lsu_load_type, nmi_lsu_store_type}), .dout({nmi_int_delayed, nmi_int_detected_f, nmi_lsu_load_type_f, nmi_lsu_store_type_f}));

   // Filter subsequent bus errors after the first, until the lock on MDSEAC is cleared
   assign nmi_lsu_detected = ~mdseac_locked_f & (lsu_imprecise_error_load_any | lsu_imprecise_error_store_any);

   assign nmi_int_detected = (nmi_int_sync & ~nmi_int_delayed) | nmi_lsu_detected | (nmi_int_detected_f & ~take_nmi_wb);
   // if the first nmi is a lsu type, note it. If there's already an nmi pending, ignore
   assign nmi_lsu_load_type = (nmi_lsu_detected & lsu_imprecise_error_load_any & ~(nmi_int_detected_f & ~take_nmi_wb)) | (nmi_lsu_load_type_f & ~take_nmi_wb);
   assign nmi_lsu_store_type = (nmi_lsu_detected & lsu_imprecise_error_store_any & ~(nmi_int_detected_f & ~take_nmi_wb)) | (nmi_lsu_store_type_f & ~take_nmi_wb);

`define MSTATUS_MIE 0
`define MIP_MCEIP 5
`define MIP_MITIP0 4
`define MIP_MITIP1 3
`define MIP_MEIP 2
`define MIP_MTIP 1
`define MIP_MSIP 0

`define MIE_MCEIE 5
`define MIE_MITIE0 4
`define MIE_MITIE1 3
`define MIE_MEIE 2
`define MIE_MTIE 1
`define MIE_MSIE 0

`define DCSR_EBREAKM 15
`define DCSR_STEPIE 11
`define DCSR_STOPC 10
//`define DCSR_STOPT 9
`define DCSR_STEP 2

   // ----------------------------------------------------------------------
   // MPC halt
   // - can interact with debugger halt and v-v

    rvdff #(11)  mpvhalt_ff (.*, .clk(free_clk),
                                 .din({mpc_debug_halt_req_sync, mpc_debug_run_req_sync,
                                       mpc_halt_state_ns, mpc_run_state_ns, debug_brkpt_status_ns,
                                       mpc_debug_halt_ack_ns, mpc_debug_run_ack_ns,
                                       dbg_halt_state_ns, dbg_run_state_ns, dbg_halt_state_f,
                                       dec_tlu_mpc_halted_only_ns}),
                                .dout({mpc_debug_halt_req_sync_f, mpc_debug_run_req_sync_f,
                                       mpc_halt_state_f, mpc_run_state_f, debug_brkpt_status_f,
                                       mpc_debug_halt_ack_f, mpc_debug_run_ack_f,
                                       dbg_halt_state_f, dbg_run_state_f, dbg_halt_state_ff,
                                       dec_tlu_mpc_halted_only}));

   // turn level sensitive requests into pulses
   assign mpc_debug_halt_req_sync_pulse = mpc_debug_halt_req_sync & ~mpc_debug_halt_req_sync_f;
   assign mpc_debug_run_req_sync_pulse = mpc_debug_run_req_sync & ~mpc_debug_run_req_sync_f;

   // states
   assign mpc_halt_state_ns = (mpc_halt_state_f | mpc_debug_halt_req_sync_pulse | (reset_delayed & ~mpc_reset_run_req)) & ~mpc_debug_run_req_sync;
   assign mpc_run_state_ns = (mpc_run_state_f | (mpc_debug_run_req_sync_pulse & ~mpc_debug_run_ack_f)) & (internal_dbg_halt_mode_f & ~dcsr_single_step_running_f);

   // note, MPC halt can allow the jtag debugger to just start sending commands. When that happens, set the interal debugger halt state to prevent
   // MPC run from starting the core.
   assign dbg_halt_state_ns = (dbg_halt_state_f | (dbg_halt_req | dcsr_single_step_done_f | trigger_hit_dmode_wb | ebreak_to_debug_mode_wb)) & ~dbg_resume_req;
   assign dbg_run_state_ns = (dbg_run_state_f | dbg_resume_req) & (internal_dbg_halt_mode_f & ~dcsr_single_step_running_f);

   // tell dbg we are only MPC halted
   assign dec_tlu_mpc_halted_only_ns = ~dbg_halt_state_f & mpc_halt_state_f;

   // this asserts from detection of bkpt until after we leave debug mode
   assign debug_brkpt_valid = ebreak_to_debug_mode_wb | trigger_hit_dmode_wb;
   assign debug_brkpt_status_ns = (debug_brkpt_valid | debug_brkpt_status_f) & (internal_dbg_halt_mode & ~dcsr_single_step_running_f);

   // acks back to interface
   assign mpc_debug_halt_ack_ns = mpc_halt_state_f & internal_dbg_halt_mode_f & mpc_debug_halt_req_sync & core_empty;
   assign mpc_debug_run_ack_ns = (mpc_debug_run_req_sync & ~internal_dbg_halt_mode & ~mpc_debug_halt_req_sync) | (mpc_debug_run_ack_f & mpc_debug_run_req_sync) ;

   // Pins
   assign mpc_debug_halt_ack = mpc_debug_halt_ack_f;
   assign mpc_debug_run_ack = mpc_debug_run_ack_f;
   assign debug_brkpt_status = debug_brkpt_status_f;


   // combine MPC and DBG halt requests
   assign debug_halt_req = (dbg_halt_req | mpc_debug_halt_req_sync | (reset_delayed & ~mpc_reset_run_req)) & ~internal_dbg_halt_mode_f;

   assign debug_resume_req = ~debug_resume_req_f &  // squash back to back resumes
                             ((mpc_run_state_ns & ~dbg_halt_state_ns) |  // MPC run req
                              (dbg_run_state_ns & ~mpc_halt_state_ns)); // dbg request is a pulse

   // HALT

   // dbg/pmu/fw requests halt, service as soon as lsu is not blocking interrupts
   assign take_halt = (debug_halt_req_f | pmu_fw_halt_req_f) & ~lsu_block_interrupts_e4 & ~synchronous_flush_e4 & ~mret_e4 & ~halt_taken_f & ~dec_tlu_flush_noredir_wb & ~take_reset;

   // hold after we take a halt, so we don't keep taking halts
   assign halt_taken = (dec_tlu_flush_noredir_wb & ~dec_tlu_flush_pause_wb) | (halt_taken_f & ~dbg_tlu_halted_f & ~pmu_fw_tlu_halted_f & ~interrupt_valid_wb);

   // After doing halt flush (RFNPC) wait until core is idle before asserting a particular halt mode
   // It takes a cycle for mb_empty to assert after a fetch, take_halt covers that cycle
   assign core_empty = lsu_halt_idle_any & lsu_halt_idle_any_f & ifu_miss_state_idle & ifu_miss_state_idle_f & ~debug_halt_req & ~debug_halt_req_d1;

//--------------------------------------------------------------------------------
// Debug start
//

   assign enter_debug_halt_req = (~internal_dbg_halt_mode_f & debug_halt_req) | dcsr_single_step_done_f | trigger_hit_dmode_wb | ebreak_to_debug_mode_wb;

   // dbg halt state active from request until non-step resume
   assign internal_dbg_halt_mode = debug_halt_req_ns | (internal_dbg_halt_mode_f & ~(debug_resume_req_f & ~dcsr[`DCSR_STEP]));
   // dbg halt can access csrs as long as we are not stepping
   assign allow_dbg_halt_csr_write = internal_dbg_halt_mode_f & ~dcsr_single_step_running_f;


   // hold debug_halt_req_ns high until we enter debug halt
   assign debug_halt_req_ns = enter_debug_halt_req | (debug_halt_req_f & ~dbg_tlu_halted);

   assign dbg_tlu_halted = (debug_halt_req_f & core_empty & halt_taken) | (dbg_tlu_halted_f & ~debug_resume_req_f);

   assign resume_ack_ns = (debug_resume_req_f & dbg_tlu_halted_f & dbg_run_state_ns);

   assign dcsr_single_step_done = dec_tlu_i0_valid_e4 & ~dec_tlu_dbg_halted & dcsr[`DCSR_STEP] & ~rfpc_i0_e4;

   assign dcsr_single_step_running = (debug_resume_req_f & dcsr[`DCSR_STEP]) | (dcsr_single_step_running_f & ~dcsr_single_step_done_f);

   assign dbg_cmd_done_ns = dec_tlu_i0_valid_e4 & dec_tlu_dbg_halted;

   // used to hold off commits after an in-pipe debug mode request (triggers, DCSR)
   assign request_debug_mode_e4 = (trigger_hit_dmode_e4 | ebreak_to_debug_mode_e4) | (request_debug_mode_wb & ~dec_tlu_flush_lower_wb);

   assign request_debug_mode_done = (request_debug_mode_wb | request_debug_mode_done_f) & ~dbg_tlu_halted_f;

    rvdff #(22)  halt_ff (.*, .clk(free_clk), .din({halt_taken, take_halt, lsu_halt_idle_any, ifu_miss_state_idle, dbg_tlu_halted,
                                  resume_ack_ns, dbg_cmd_done_ns, debug_halt_req_ns, debug_resume_req, trigger_hit_dmode_e4,
                                  dcsr_single_step_done, debug_halt_req,  update_hit_bit_e4[3:0], dec_tlu_wr_pause_wb, dec_pause_state,
                                  request_debug_mode_e4, request_debug_mode_done, dcsr_single_step_running, dcsr_single_step_running_f}),
                           .dout({halt_taken_f, take_halt_f, lsu_halt_idle_any_f, ifu_miss_state_idle_f, dbg_tlu_halted_f,
                                  dec_tlu_resume_ack, dec_dbg_cmd_done, debug_halt_req_f, debug_resume_req_f_raw, trigger_hit_dmode_wb,
                                  dcsr_single_step_done_f, debug_halt_req_d1, update_hit_bit_wb[3:0], dec_tlu_wr_pause_wb_f, dec_pause_state_f,
                                  request_debug_mode_wb, request_debug_mode_done_f, dcsr_single_step_running_f, dcsr_single_step_running_ff}));

   // MPC run collides with DBG halt, fix it here
   assign debug_resume_req_f = debug_resume_req_f_raw & ~dbg_halt_req;

   assign dec_tlu_debug_stall = debug_halt_req_f;
   assign dec_tlu_dbg_halted = dbg_tlu_halted_f;
   assign dec_tlu_debug_mode = internal_dbg_halt_mode_f;
   assign dec_tlu_pmu_fw_halted = pmu_fw_tlu_halted_f;

   // kill fetch redirection on flush if going to halt, or if there's a fence during db-halt
   assign dec_tlu_flush_noredir_wb = take_halt_f | (fence_i_wb & internal_dbg_halt_mode_f) | dec_tlu_flush_pause_wb | (trigger_hit_wb & trigger_hit_dmode_wb);

   // 1 cycle after writing the PAUSE counter, flush with noredir to idle F1-D.
   assign dec_tlu_flush_pause_wb = dec_tlu_wr_pause_wb_f & ~interrupt_valid_wb;

   // detect end of pause counter and rfpc
   assign pause_expired_e4 = ~dec_pause_state & dec_pause_state_f & ~(ext_int_ready | ce_int_ready | timer_int_ready | int_timer0_int_hold_f | int_timer1_int_hold_f | nmi_int_detected) & ~interrupt_valid_wb & ~debug_halt_req_f & ~pmu_fw_halt_req_f & ~halt_taken_f;

   // stall dma fifo if a fence is pending, decode is waiting for lsu to idle before decoding the fence inst.
   assign dec_tlu_stall_dma = dec_fence_pending  & dec_tlu_dccm_nonblock_dma_disable; // Stall the DMA for fences when chicken bit is set;
   assign dec_tlu_flush_leak_one_wb = dec_tlu_flush_lower_wb  & dcsr[`DCSR_STEP] & (dec_tlu_resume_ack | dcsr_single_step_running);
   assign dec_tlu_flush_err_wb = dec_tlu_flush_lower_wb & (ic_perr_wb | iccm_sbecc_wb);

   // If DM attempts to access an illegal CSR, send cmd_fail back
   assign dec_dbg_cmd_fail = illegal_raw_wb & dec_dbg_cmd_done;


   //--------------------------------------------------------------------------------
   //--------------------------------------------------------------------------------
   // Triggers
   //
`define MTDATA1_DMODE 9
`define MTDATA1_SEL 7
`define MTDATA1_ACTION 6
`define MTDATA1_CHAIN 5
`define MTDATA1_MATCH 4
`define MTDATA1_M_ENABLED 3
`define MTDATA1_EXE 2
`define MTDATA1_ST 1
`define MTDATA1_LD 0

   // Prioritize trigger hits with other exceptions.
   //
   // Trigger should have highest priority except:
   // - trigger is an execute-data and there is an inst_access exception (lsu triggers won't fire, inst. is nop'd by decode)
   // - trigger is a store-data and there is a lsu_acc_exc or lsu_ma_exc.
   assign trigger_execute[3:0] = {mtdata1_t3[`MTDATA1_EXE], mtdata1_t2[`MTDATA1_EXE], mtdata1_t1[`MTDATA1_EXE], mtdata1_t0[`MTDATA1_EXE]};
   assign trigger_data[3:0] = {mtdata1_t3[`MTDATA1_SEL], mtdata1_t2[`MTDATA1_SEL], mtdata1_t1[`MTDATA1_SEL], mtdata1_t0[`MTDATA1_SEL]};
   assign trigger_store[3:0] = {mtdata1_t3[`MTDATA1_ST], mtdata1_t2[`MTDATA1_ST], mtdata1_t1[`MTDATA1_ST], mtdata1_t0[`MTDATA1_ST]};


   // MSTATUS[MIE] needs to be on to take triggers unless the action is trigger to debug mode.
   assign trigger_enabled[3:0] = {(mtdata1_t3[`MTDATA1_ACTION] | mstatus[`MSTATUS_MIE]) & mtdata1_t3[`MTDATA1_M_ENABLED],
                                  (mtdata1_t2[`MTDATA1_ACTION] | mstatus[`MSTATUS_MIE]) & mtdata1_t2[`MTDATA1_M_ENABLED],
                                  (mtdata1_t1[`MTDATA1_ACTION] | mstatus[`MSTATUS_MIE]) & mtdata1_t1[`MTDATA1_M_ENABLED],
                                  (mtdata1_t0[`MTDATA1_ACTION] | mstatus[`MSTATUS_MIE]) & mtdata1_t0[`MTDATA1_M_ENABLED]};

   // iside exceptions are always in i0
   assign i0_iside_trigger_has_pri_e4[3:0] = ~( (trigger_execute[3:0] & trigger_data[3:0] & {4{inst_acc_e4_raw}}) | // exe-data with inst_acc
                                                ({4{exu_i0_br_error_e4 | exu_i0_br_start_error_e4}}));              // branch error in i0

   assign i1_iside_trigger_has_pri_e4[3:0] = ~( ({4{exu_i1_br_error_e4 | exu_i1_br_start_error_e4}}) ); // branch error in i1

   // lsu excs have to line up with their respective triggers since the lsu op can be in either i0 or i1 but not both
   assign i0_lsu_trigger_has_pri_e4[3:0] = ~(trigger_store[3:0] & trigger_data[3:0] & {4{lsu_i0_exc_dc4_raw}});
   assign i1_lsu_trigger_has_pri_e4[3:0] = ~(trigger_store[3:0] & trigger_data[3:0] & {4{lsu_i1_exc_dc4_raw}});

   // Qual trigger hits
   assign i0_trigger_eval_e4 = dec_tlu_i0_valid_e4 | ( dec_i0_load_e4 & lsu_freeze_pulse_e4);
   assign i1_trigger_eval_e4 = dec_tlu_i1_valid_e4 | (~dec_i0_load_e4 & lsu_freeze_pulse_e4);

   assign i0_trigger_e4[3:0] = {4{i0_trigger_eval_e4}} & dec_tlu_packet_e4.i0trigger[3:0] & i0_iside_trigger_has_pri_e4[3:0] & i0_lsu_trigger_has_pri_e4[3:0] & trigger_enabled[3:0];
   assign i1_trigger_e4[3:0] = {4{i1_trigger_eval_e4}} & dec_tlu_packet_e4.i1trigger[3:0] & i1_iside_trigger_has_pri_e4[3:0] & i1_lsu_trigger_has_pri_e4[3:0] & trigger_enabled[3:0];

   assign trigger_chain[2:0] = {mtdata1_t2[`MTDATA1_CHAIN], mtdata1_t1[`MTDATA1_CHAIN], mtdata1_t0[`MTDATA1_CHAIN]};

   // chaining can mask raw trigger info
   assign i0_trigger_chain_masked_e4[3:0] = {i0_trigger_e4[3] & (~trigger_chain[2] | i0_trigger_e4[2]),
                                             i0_trigger_e4[2] & (~trigger_chain[2] | i0_trigger_e4[3]),
                                             i0_trigger_e4[1] & (~trigger_chain[0] | i0_trigger_e4[0]),
                                             i0_trigger_e4[0] & (~trigger_chain[0] | i0_trigger_e4[1])};

   assign i1_trigger_chain_masked_e4[3:0] = {i1_trigger_e4[3] & (~trigger_chain[2] | i1_trigger_e4[2]),
                                             i1_trigger_e4[2] & (~trigger_chain[2] | i1_trigger_e4[3]),
                                             i1_trigger_e4[1] & (~trigger_chain[0] | i1_trigger_e4[0]),
                                             i1_trigger_e4[0] & (~trigger_chain[0] | i1_trigger_e4[1])};

   // This is the highest priority by this point.
   assign i0_trigger_hit_raw_e4 = |i0_trigger_chain_masked_e4[3:0];
   assign i1_trigger_hit_raw_e4 = |i1_trigger_chain_masked_e4[3:0];

   // Qual trigger hits
   assign i0_trigger_hit_e4 = ~(dec_tlu_flush_lower_wb | dec_tlu_dbg_halted | lsu_freeze_pulse_e4) & i0_trigger_hit_raw_e4;
   assign i1_trigger_hit_e4 = ~(dec_tlu_flush_lower_wb | ~tlu_i0_commit_cmt | exu_i0_br_mp_e4 | dec_tlu_dbg_halted | lsu_freeze_pulse_e4 | lsu_i0_rfnpc_dc4) & i1_trigger_hit_raw_e4;

   assign dec_tlu_cancel_e4 = (i0_trigger_hit_raw_e4 | i1_trigger_hit_raw_e4) & lsu_freeze_pulse_e4;

   // Actions include breakpoint, or dmode. Dmode is only possible if the DMODE bit is set.
   // Otherwise, take a breakpoint.
   assign trigger_action[3:0] = {mtdata1_t3[`MTDATA1_ACTION] & mtdata1_t3[`MTDATA1_DMODE],
                                 mtdata1_t2[`MTDATA1_ACTION] & mtdata1_t2[`MTDATA1_DMODE] & ~mtdata1_t2[`MTDATA1_CHAIN],
                                 mtdata1_t1[`MTDATA1_ACTION] & mtdata1_t1[`MTDATA1_DMODE],
                                 mtdata1_t0[`MTDATA1_ACTION] & mtdata1_t0[`MTDATA1_DMODE] & ~mtdata1_t0[`MTDATA1_CHAIN]};

   // this is needed to set the HIT bit in the triggers
   assign i0_trigger_set_hit_e4 = |i0_trigger_e4[3:0] & ~(dec_tlu_flush_lower_wb | dec_tlu_dbg_halted | rfpc_i0_e4);
   assign i1_trigger_set_hit_e4 = |i1_trigger_e4[3:0] & ~(dec_tlu_flush_lower_wb | dec_tlu_dbg_halted |
                                                          ~tlu_i0_commit_cmt | exu_i0_br_mp_e4 | dec_tlu_dbg_halted |
                                                          lsu_freeze_pulse_e4 | lsu_i0_rfnpc_dc4 | rfpc_i1_e4);

   assign update_hit_bit_e4[3:0] = ({4{i0_trigger_set_hit_e4}} & {i0_trigger_chain_masked_e4[3], i0_trigger_e4[2], i0_trigger_chain_masked_e4[1], i0_trigger_e4[0]} ) |
                                   ({4{i1_trigger_set_hit_e4}} & {i1_trigger_chain_masked_e4[3], i1_trigger_e4[2], i1_trigger_chain_masked_e4[1], i1_trigger_e4[0]} );

   // action, 1 means dmode. Simultaneous triggers with at least 1 set for dmode force entire action to dmode.
   assign i0_trigger_action_e4 = |(i0_trigger_chain_masked_e4[3:0] & trigger_action[3:0]);
   assign i1_trigger_action_e4 = |(i1_trigger_chain_masked_e4[3:0] & trigger_action[3:0]);

   assign trigger_hit_e4 = i0_trigger_hit_e4 | i1_trigger_hit_e4;
   assign trigger_hit_dmode_e4 = (i0_trigger_hit_e4 & i0_trigger_action_e4) | (i1_trigger_hit_e4 & ~i0_trigger_hit_e4 & i1_trigger_action_e4);

   assign mepc_trigger_hit_sel_pc_e4 = trigger_hit_e4 & ~trigger_hit_dmode_e4;


//
// Debug end
//--------------------------------------------------------------------------------

   //----------------------------------------------------------------------
   //
   // Commit
   //
   //----------------------------------------------------------------------



   //--------------------------------------------------------------------------------
   // External halt (not debug halt)
   // - Fully interlocked handshake
   // i_cpu_halt_req  ____|--------------|_______________
   // core_empty      ---------------|___________
   // o_cpu_halt_ack  _________________|----|__________
   // o_cpu_halt_status _______________|---------------------|_________
   // i_cpu_run_req                              ______|----------|____
   // o_cpu_run_ack                              ____________|------|________
   //


   // debug mode has priority, ignore PMU/FW halt/run while in debug mode
   assign i_cpu_halt_req_sync_qual = i_cpu_halt_req_sync & ~dec_tlu_debug_mode;
   assign i_cpu_run_req_sync_qual = i_cpu_run_req_sync & ~dec_tlu_debug_mode & pmu_fw_tlu_halted_f;

   rvdff #(10) exthaltff (.*, .clk(free_clk), .din({i_cpu_halt_req_sync_qual, i_cpu_run_req_sync_qual,   cpu_halt_status,
                                                   cpu_halt_ack,   cpu_run_ack, internal_pmu_fw_halt_mode,
                                                   pmu_fw_halt_req_ns, pmu_fw_tlu_halted,
                                                   int_timer0_int_hold, int_timer1_int_hold}),
                                            .dout({i_cpu_halt_req_d1,        i_cpu_run_req_d1_raw,      o_cpu_halt_status,
                                                   o_cpu_halt_ack, o_cpu_run_ack, internal_pmu_fw_halt_mode_f,
                                                   pmu_fw_halt_req_f, pmu_fw_tlu_halted_f,
                                                   int_timer0_int_hold_f, int_timer1_int_hold_f}));

   // only happens if we aren't in dgb_halt
   assign ext_halt_pulse = i_cpu_halt_req_sync_qual & ~i_cpu_halt_req_d1;

   assign enter_pmu_fw_halt_req =  ext_halt_pulse | fw_halt_req;

   assign pmu_fw_halt_req_ns = (enter_pmu_fw_halt_req | (pmu_fw_halt_req_f & ~pmu_fw_tlu_halted)) & ~debug_halt_req_f;

   assign internal_pmu_fw_halt_mode = pmu_fw_halt_req_ns | (internal_pmu_fw_halt_mode_f & ~i_cpu_run_req_d1 & ~debug_halt_req_f);

   // debug halt has priority
   assign pmu_fw_tlu_halted = ((pmu_fw_halt_req_f & core_empty & halt_taken & ~enter_debug_halt_req) | (pmu_fw_tlu_halted_f & ~i_cpu_run_req_d1)) & ~debug_halt_req_f;

   assign cpu_halt_ack = i_cpu_halt_req_d1 & pmu_fw_tlu_halted_f;
   assign cpu_halt_status = (pmu_fw_tlu_halted_f & ~i_cpu_run_req_d1) | (o_cpu_halt_status & ~i_cpu_run_req_d1 & ~internal_dbg_halt_mode_f);
   assign cpu_run_ack = (o_cpu_halt_status & i_cpu_run_req_d1_raw) | (o_cpu_run_ack & i_cpu_run_req_sync);
   assign debug_mode_status = internal_dbg_halt_mode_f;
   assign o_debug_mode_status = debug_mode_status;// & ~mpc_debug_run_ack_f;

`ifdef ASSERT_ON
  assert_commit_while_halted: assert #0 (~((tlu_i0_commit_cmt | tlu_i1_commit_cmt) & o_cpu_halt_status)) else $display("ERROR: Commiting while cpu_halt_status asserted!");
`endif

   // high priority interrupts can wakeup from external halt, so can unmasked timer interrupts
   assign i_cpu_run_req_d1 = i_cpu_run_req_d1_raw | ((nmi_int_detected | timer_int_ready | int_timer0_int_hold_f | int_timer1_int_hold_f | (mhwakeup & mhwakeup_ready)) & o_cpu_halt_status);

   //--------------------------------------------------------------------------------
   //--------------------------------------------------------------------------------

   rvdff #( $bits(lsu_error_pkt_t)+1 ) lsu_error_dc4ff (.*, .clk(lsu_e3_e4_clk), .din({lsu_error_pkt_dc3, lsu_load_ecc_stbuf_full_dc3}),  .dout({lsu_error_pkt_dc4, lsu_load_ecc_stbuf_full_dc4}));

   logic lsu_single_ecc_error_wb_ns;
   assign lsu_single_ecc_error_wb_ns = lsu_single_ecc_error_incr;
   rvdff #(2) lsu_dccm_errorff (.*, .clk(free_clk), .din({mdseac_locked_ns, lsu_single_ecc_error_wb_ns}), .dout({mdseac_locked_f, lsu_single_ecc_error_wb}));

   logic [31:0] lsu_error_pkt_addr_dc4, lsu_error_pkt_addr_wb;
   assign lsu_error_pkt_addr_dc4[31:0] = lsu_error_pkt_dc4.addr[31:0];
   rvdff #(34) lsu_error_wbff (.*, .clk(lsu_e4_e5_clk), .din({lsu_error_pkt_addr_dc4[31:0], lsu_exc_valid_e4, lsu_i0_exc_dc4}),  .dout({lsu_error_pkt_addr_wb[31:0], lsu_exc_valid_wb, lsu_i0_exc_wb}));


   // lsu exception is valid unless it's in pipe1 and there was a rfpc_i0_e4, brmp, or an iside exception in pipe0.
   assign lsu_exc_valid_e4_raw = lsu_error_pkt_dc4.exc_valid & ~(lsu_error_pkt_dc4.inst_pipe & (rfpc_i0_e4 | i0_exception_valid_e4 | exu_i0_br_mp_e4)) & ~dec_tlu_flush_lower_wb;

   assign lsu_i0_exc_dc4_raw =  lsu_error_pkt_dc4.exc_valid & ~lsu_error_pkt_dc4.inst_pipe;
   assign lsu_i1_exc_dc4_raw = lsu_error_pkt_dc4.exc_valid &  lsu_error_pkt_dc4.inst_pipe;
   assign lsu_i0_exc_dc4 = lsu_i0_exc_dc4_raw & lsu_exc_valid_e4_raw & ~i0_trigger_hit_e4;
   assign lsu_i1_exc_dc4 = lsu_i1_exc_dc4_raw & lsu_exc_valid_e4_raw & ~trigger_hit_e4;
   assign lsu_exc_valid_e4 = lsu_i0_exc_dc4 | lsu_i1_exc_dc4;

   assign lsu_exc_ma_dc4 = (lsu_i0_exc_dc4 | lsu_i1_exc_dc4) & ~lsu_error_pkt_dc4.exc_type;
   assign lsu_exc_acc_dc4 = (lsu_i0_exc_dc4 | lsu_i1_exc_dc4) & lsu_error_pkt_dc4.exc_type;
   assign lsu_exc_st_dc4 = (lsu_i0_exc_dc4 | lsu_i1_exc_dc4) & lsu_error_pkt_dc4.inst_type;

   // If the stbuf is not full, then
   // Single bit ECC errors on loads are RFNPC corrected, with the corrected data written to the GPR.
   // LSU turns the load into a store and patches the data in the DCCM
   assign lsu_i0_rfnpc_dc4 = dec_tlu_i0_valid_e4 & ~lsu_error_pkt_dc4.inst_pipe & ~lsu_error_pkt_dc4.inst_type &
                             lsu_error_pkt_dc4.single_ecc_error & ~lsu_error_pkt_dc4.dma_valid & ~i0_trigger_hit_e4 & ~lsu_load_ecc_stbuf_full_dc4;
   assign lsu_i1_rfnpc_dc4 = dec_tlu_i1_valid_e4 &  lsu_error_pkt_dc4.inst_pipe & ~lsu_error_pkt_dc4.inst_type &
                             lsu_error_pkt_dc4.single_ecc_error & ~lsu_error_pkt_dc4.dma_valid & ~i0_trigger_hit_e4 & ~i1_trigger_hit_e4 & ~lsu_load_ecc_stbuf_full_dc4;
   // otherwise, they are rfpcs
   assign lsu_i0_rfpc_dc4 = dec_tlu_i0_valid_e4 & ~lsu_error_pkt_dc4.inst_pipe & ~lsu_error_pkt_dc4.inst_type &
                            lsu_error_pkt_dc4.single_ecc_error & ~lsu_error_pkt_dc4.dma_valid & lsu_load_ecc_stbuf_full_dc4;
   assign lsu_i1_rfpc_dc4 = dec_tlu_i1_valid_e4 &  lsu_error_pkt_dc4.inst_pipe & ~lsu_error_pkt_dc4.inst_type &
                             lsu_error_pkt_dc4.single_ecc_error & ~lsu_error_pkt_dc4.dma_valid & lsu_load_ecc_stbuf_full_dc4;

   // Branch prediction updating
   assign dec_tlu_br0_addr_e4[`RV_BTB_ADDR_HI:`RV_BTB_ADDR_LO] = exu_i0_br_index_e4[`RV_BTB_ADDR_HI:`RV_BTB_ADDR_LO];
   assign dec_tlu_br0_bank_e4[1:0] = exu_i0_br_bank_e4[1:0];
   assign dec_tlu_br1_addr_e4[`RV_BTB_ADDR_HI:`RV_BTB_ADDR_LO] = exu_i1_br_index_e4[`RV_BTB_ADDR_HI:`RV_BTB_ADDR_LO];
   assign dec_tlu_br1_bank_e4[1:0] = exu_i1_br_bank_e4[1:0];


   //  Final commit valids
   assign tlu_i0_commit_cmt = dec_tlu_i0_valid_e4 &
                              ~rfpc_i0_e4 &
                              ~lsu_i0_exc_dc4 &
                              ~inst_acc_e4 &
                              ~dec_tlu_dbg_halted &
                              ~request_debug_mode_wb &
                              ~i0_trigger_hit_e4;

   assign tlu_i1_commit_cmt = dec_tlu_i1_valid_e4 &
                              ~rfpc_i0_e4 & ~rfpc_i1_e4 &
                              ~exu_i0_br_mp_e4 &
                              ~lsu_i0_exc_dc4 & ~lsu_i1_exc_dc4 &
                              ~lsu_i0_rfnpc_dc4 &
                              ~inst_acc_e4 &
                              ~request_debug_mode_wb &
                              ~trigger_hit_e4;

   // unified place to manage the killing of arch state writebacks
   assign tlu_i0_kill_writeb_e4 = rfpc_i0_e4 | lsu_i0_exc_dc4 | inst_acc_e4 | (illegal_e4 & dec_tlu_dbg_halted) | i0_trigger_hit_e4 ;
   assign tlu_i1_kill_writeb_e4 = rfpc_i0_e4 | rfpc_i1_e4 | lsu_exc_valid_e4 | exu_i0_br_mp_e4 | inst_acc_e4 | (illegal_e4 & dec_tlu_dbg_halted) | trigger_hit_e4 | lsu_i0_rfnpc_dc4;

   // Auto postsync loads that freeze when DMA requests are stalled, if not disabled with MFDC[13].
   assign freeze_rfpc_e4 = (lsu_block_interrupts_e4 | (dma_mem_dccm_req_f & lsu_freeze_e4)) & ~dec_tlu_flush_lower_wb & mfdc[13];
   assign rfpc_postsync_in = (freeze_rfpc_e4 | rfpc_postsync) & ~tlu_i0_commit_cmt;
   assign dec_tlu_dccm_nonblock_dma_disable = ~mfdc[13];

   rvdff #(2)  freezerfpc_ff (.*,   .clk(free_clk),
                              .din({rfpc_postsync_in, dma_mem_dccm_req}),
                              .dout({rfpc_postsync, dma_mem_dccm_req_f}));


   // refetch PC, microarch flush
   // ic errors only in pipe0
   assign rfpc_i0_e4 = freeze_rfpc_e4 | (
                       dec_tlu_i0_valid_e4 & ~tlu_flush_lower_wb & (exu_i0_br_error_e4 | exu_i0_br_start_error_e4 | ic_perr_e4 | iccm_sbecc_e4 | lsu_i0_rfpc_dc4) & ~i0_trigger_hit_e4);
    assign rfpc_i1_e4 = dec_tlu_i1_valid_e4 & ~tlu_flush_lower_wb & ~i0_exception_valid_e4 & ~exu_i0_br_mp_e4 & ~lsu_i0_exc_dc4 & ~lsu_i0_rfnpc_dc4 &
                       ~(exu_i0_br_error_e4 | exu_i0_br_start_error_e4 | ic_perr_e4 | iccm_sbecc_e4 | lsu_i0_rfpc_dc4) &
                       (exu_i1_br_error_e4 | exu_i1_br_start_error_e4 | lsu_i1_rfpc_dc4) &
                       ~trigger_hit_e4;

   // go ahead and repair the branch error on other flushes, doesn't have to be the rfpc flush
   assign dec_tlu_br0_error_e4 = exu_i0_br_error_e4 & dec_tlu_i0_valid_e4 & ~tlu_flush_lower_wb;
   assign dec_tlu_br0_start_error_e4 = exu_i0_br_start_error_e4 & dec_tlu_i0_valid_e4 & ~tlu_flush_lower_wb;
   assign dec_tlu_br0_v_e4 = exu_i0_br_valid_e4 & dec_tlu_i0_valid_e4 & ~tlu_flush_lower_wb & ~exu_i0_br_mp_e4;

   assign dec_tlu_br1_error_e4 = exu_i1_br_error_e4 & dec_tlu_i1_valid_e4 & ~tlu_flush_lower_wb & ~exu_i0_br_mp_e4;
   assign dec_tlu_br1_start_error_e4 = exu_i1_br_start_error_e4 & dec_tlu_i1_valid_e4 & ~tlu_flush_lower_wb & ~exu_i0_br_mp_e4;
   assign dec_tlu_br1_v_e4 = exu_i1_br_valid_e4 & ~tlu_flush_lower_wb & dec_tlu_i1_valid_e4 & ~exu_i0_br_mp_e4 & ~exu_i1_br_mp_e4;
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
