chipsalliance/Cores-VeeR-EH1/design/ifu/ifu_aln_ctl.sv

//********************************************************************************
// SPDX-License-Identifier: Apache-2.0
// Copyright 2019 Western Digital Corporation or its affiliates.
//
// Licensed under the Apache License, Version 2.0 (the "License");
// you may not use this file except in compliance with the License.
// You may obtain a copy of the License at
//
// http://www.apache.org/licenses/LICENSE-2.0
//
// Unless required by applicable law or agreed to in writing, software
// distributed under the License is distributed on an "AS IS" BASIS,
// WITHOUT WARRANTIES OR CONDITIONS OF ANY KIND, either express or implied.
// See the License for the specific language governing permissions and
// limitations under the License.
//********************************************************************************

//********************************************************************************
// Function: Instruction aligner
//********************************************************************************
module ifu_aln_ctl
   import veer_types::*;
(

   input logic        active_clk,

   input logic        iccm_rd_ecc_single_err,         // This fetch has a single ICCM ecc  error.
   input logic [7:0]  iccm_rd_ecc_double_err,         // This fetch has a double ICCM ecc  error.
   input logic        ic_rd_parity_final_err,         // for tag parity errors

   input logic        ifu_icache_fetch_f2,

   input logic [7:0]  ic_access_fault_f2,             // Instruction access fault for the current fetch.
   input logic [`RV_BHT_GHR_RANGE]  ifu_bp_fghr_f2,   // fetch GHR
   input logic [31:1] ifu_bp_btb_target_f2,           //  predicted RET target
   input logic [11:0] ifu_bp_poffset_f2,              // predicted target offset

   input logic [7:0]  ifu_bp_hist0_f2,    // history counters for all 4 potential branches, bit 1, right justified
   input logic [7:0]  ifu_bp_hist1_f2,    // history counters for all 4 potential branches, bit 1, right justified
   input logic [7:0]  ifu_bp_pc4_f2,      // pc4 indication, right justified
`ifdef RV_BTB_48
   input logic [7:0][1:0]  ifu_bp_way_f2, // way indication, right justified
`else
   input logic [7:0]  ifu_bp_way_f2,      // way indication, right justified
`endif
   input logic [7:0]  ifu_bp_valid_f2,    // branch valid, right justified
   input logic [7:0]  ifu_bp_ret_f2,      // predicted ret indication, right justified

   input logic exu_flush_final,           // Flush from the pipeline.

   input logic dec_ib3_valid_d,           // valids for top 2 instruction buffers at decode
   input logic dec_ib2_valid_d,

   input logic dec_ib0_valid_eff_d,       // effective valid taking decode into account
   input logic dec_ib1_valid_eff_d,


   input logic [127:0] ifu_fetch_data,      // fetch data in memory format - not right justified

   input icache_err_pkt_t ic_error_f2,      // based on configuration: either parity or ecc


   input logic [7:0]   ifu_fetch_val,       // valids on a 2B boundary, right justified
   input logic [31:1]  ifu_fetch_pc,        // starting pc of fetch


   input logic   rst_l,
   input logic   clk,
   input logic   dec_tlu_core_ecc_disable,  // disable ecc checking and flagging
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
