chipsalliance/Cores-VeeR-EH1/(commit log)

2019-07-12 Remove spurious carriage return characters.
2019-08-08 Merged bug fix corresponding to Jira RISCV-1454: Write to SBDATA0 does not start an SB write access when sbreadonaddr/dbreadondata is set.
    Add fpga_optimize option to swerv.config; eliminates over 90% of
    clock-gating to support faster FPGA simulation.
    [dbg.sv, dec_tlu_ctl.sv, dma_ctrl.sv, dmi_jtag_to_core_sync.v, dmi_wrapper.v, exu_mul_ctl.sv, ifu_ic_mem.sv, ifu_iccm_mem.sv]
2019-09-04 Conditioned declaration of finished per issue #13
    [tb_top.sv]
2019-09-08 Added basic commit register update trace in exec.log
2019-10-15 Move declarations to top of Verilog file to fix fpga compile issues.
    [dec_decode_ctl.sv]
2019-12-06 Fixed FPGA build error
    [dmi_jtag_to_core_sync.v]
2020-02-24 Add initial FuseSoC support
    This adds support for using SweRV with FuseSoC. For SweRV itself, it allows linting with verilator running simulations with the provided testbench using most available simulators and doing synthesis for resource usage analysis with Vivado. It also allows SweRV to be integrated into FuseSoC-built SoCs, such as [SweRVolf](https://github.com/chipsalliance/Cores-SweRVolf)
    **Quickstart**
    1. Install [FuseSoC](https://github.com/olofk/fusesoc) and Verilator
    2. Create an empty workspace directory. All subsequent commands are run from this directory
    3. Add SweRV as FuseSoC library `fusesoc library add swerv https://github.com/chipsalliance/Cores-SweRV`
    4. Run linting wit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
2020-02-24 Update dmi_jtag_to_core_sync.v
    Fixed incorrect syntax
    [dmi_jtag_to_core_sync.v]
2020-02-27 Fix Riviera -l switch
2020-04-02 fix for assignment to enum variable from expression of different type
    [ifu_ifc_ctl.sv]
2020-04-02 remove unnecessary switch from vlog
2020-05-27 Reverted change related to enum assign as it broke some Verilog tools.
    [ifu_ifc_ctl.sv]
2020-09-22 Adapt FuseSoC SweRV config generator wrt new snapshot dir
2020-09-24 Set snapshot dir to a known location in FuseSoC SweRV config generator
    The previous fix for the FuseSoC SweRV config generator was not complete
2021-02-16 Delete testbench/tests/cmark_dccm directory
    This directory is redundant due to the reworking of test flow in release 1.9
2022-01-27 Fix FuseSoC simulation target
